ashabelnikov/secu3doc/PDF/SECU-3T-BLUETOOTH/secu3t_bluetooth_rev2_sch.png

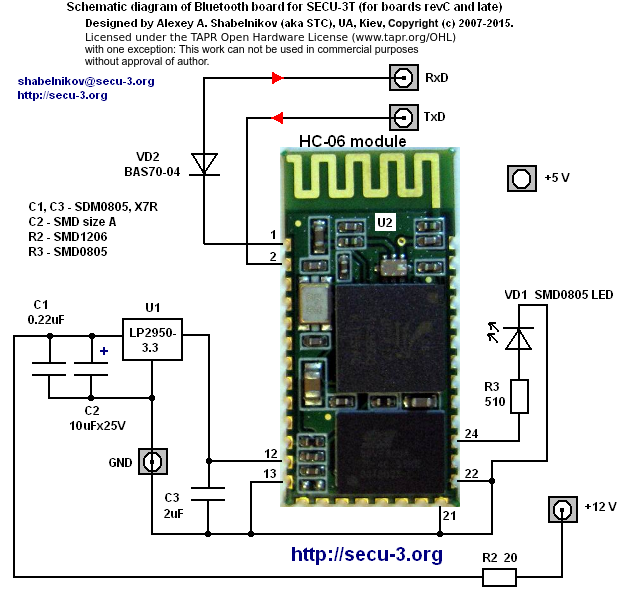
PDF/SECU-3T-BLUETOOTH/secu3t_bluetooth_rev2_sch.png
