ashabelnikov/secu3doc/README.md

# secu3doc
SECU-3 Project documentation

PCB, Schematic diagrams, pinouts etc

Contacts:
Author: Alexey A. Shabelnikov, UA, Kiev
        aka Oleksii Shabelnykov, STC
Website: http://secu-3.org
e-mail: shabelnikov@secu-3.org
