ashabelnikov/secu3doc/PDF/SECU-3T-BLUETOOTH/secu3t_bluetooth_rev2_botsilk.pdf

SECU-3T Bluetooth PCB rev. 2
Designed by Alexey A. Shabelnikov (aka STC). UA, Kiev,
Copyright (C) 2007-2015 Alexey A. Shabelnikov, http://secu-3.org Licensed under the TAPR Open Hardware License (www.tapr.org/OHL) with one exception: You can not use this work in commercial purposes

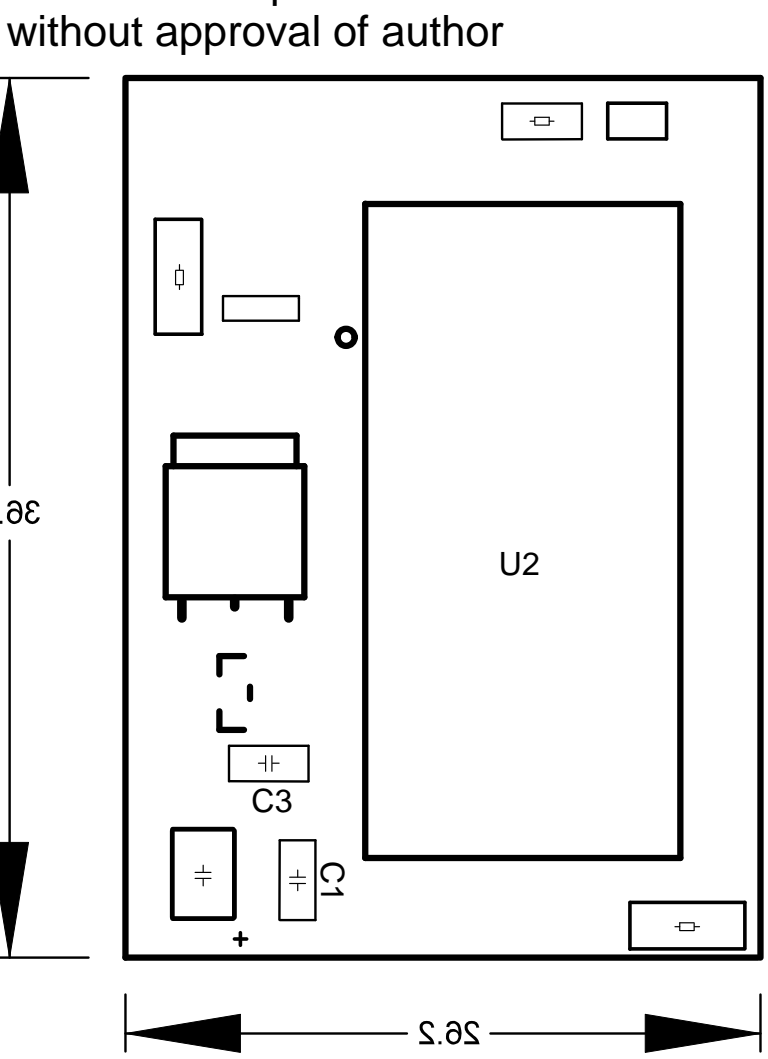
[picture p2: figure]
without approval of author
