ashabelnikov/secu3doc/PDF/SECU-INJ-DRV4/secu3_hi-z_inj_drv_botsilk.pdf

24.5

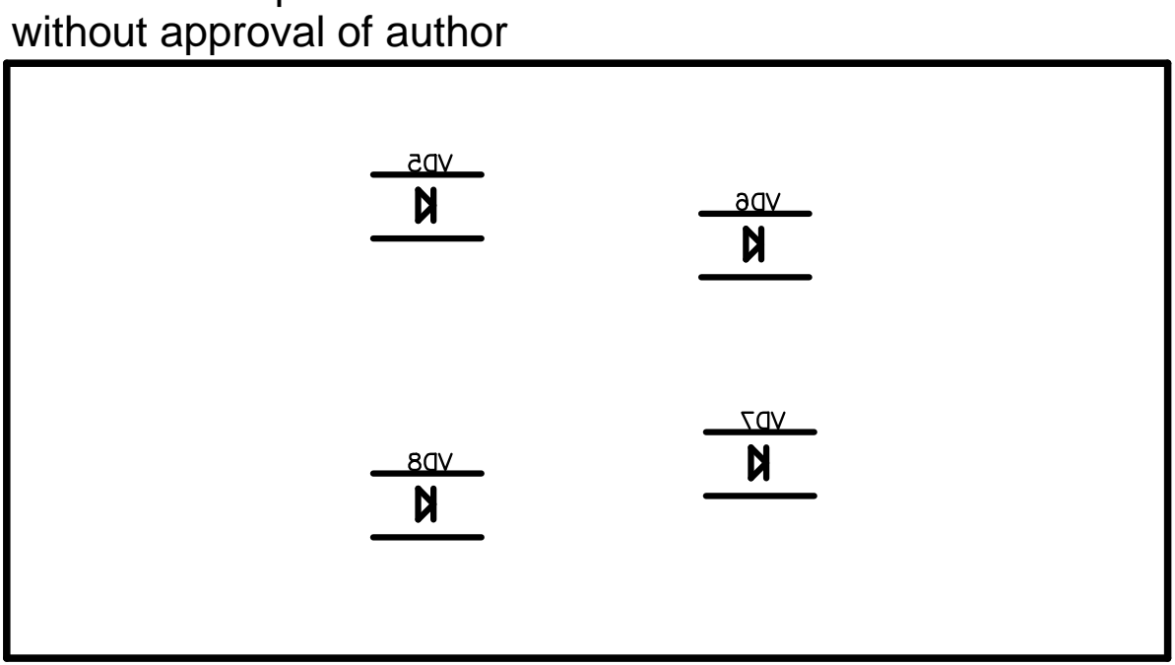
[picture p3: figure]
without approval of author

47.8

4-channel hi-z injector driver board PCB
Designed by Alexey A. Shabelnikov (aka STC). UA, Kiev.
Copyright (C) 2007-2015 Alexey A. Shabelnikov, http://secu-3.org Licensed under the TAPR Open Hardware License (www.tapr.org/OHL) with one exception: You can not use this work in commercial purposes
