ashabelnikov/secu3doc/PDF/SECU-P&H+PWMIAC/secu3_pnh+pwm_iac_pcb_topsilk.pdf

P&H injector + PWM IAC driver PCB rev.0 (SECU-P&H+PWMIAC) Designed by Alexey A. Shabelnikov (aka STC), UA, Kiev.
Copyright (C) 2007-2015 Alexey A. Shabelnikov, http://secu-3.org Licensed under the TAPR Open Hardware License (www.tapr.org/OHL) with one exception: You can not use this work in commercial purposes

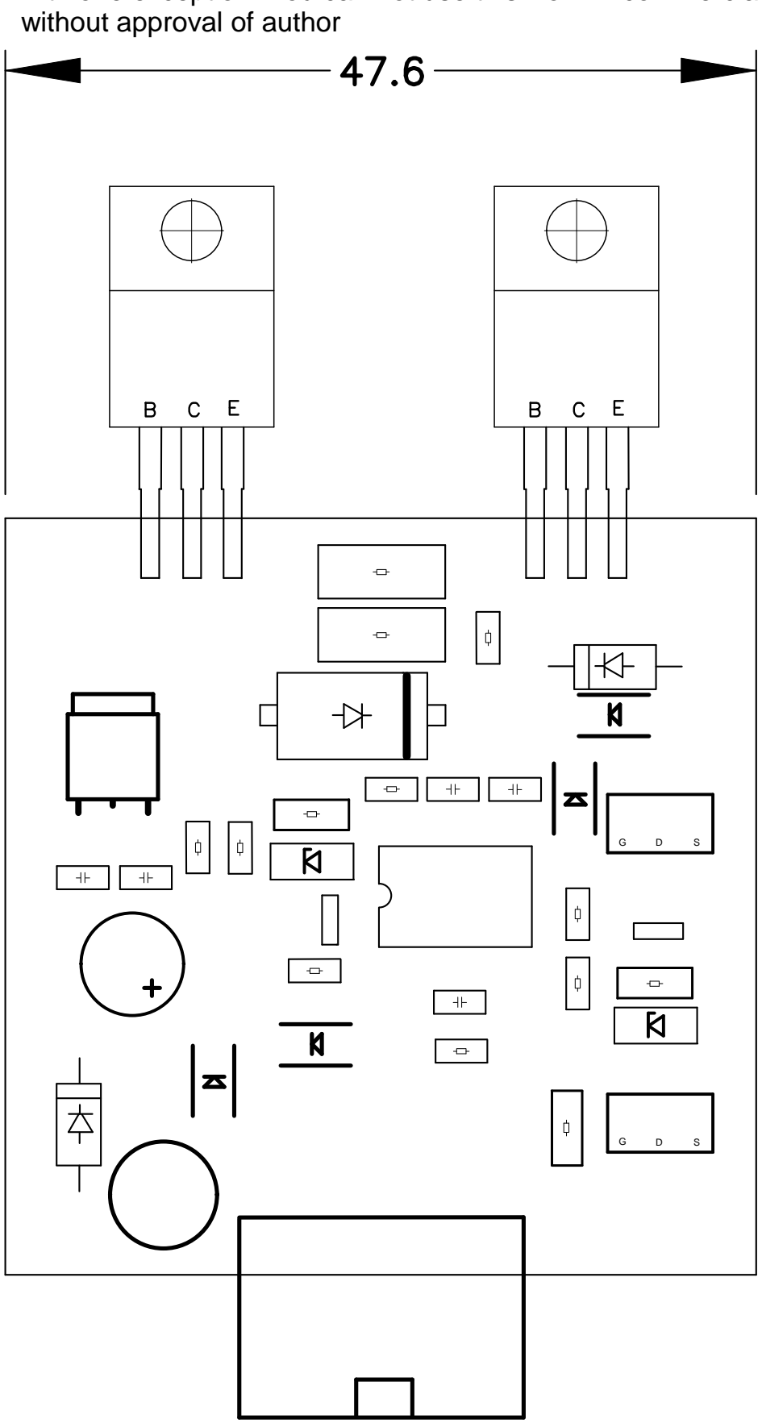
[picture p4: figure]
without approval of author
