ashabelnikov/secu3doc/Publications/readme.txt

            List of publications

1. 47939-96219-1-PB.pdf, p.90-95
"ЭЛЕКТРОННЫЙ БЛОК УПРАВЛЕНИЯ ДВИГАТЕЛЕМ ВНУТРЕННЕГО СГОРАНИЯ SECU-3"
Шабельников А. А.
Электронный блок управления двигателем внутреннего сгорания secu-3 / А. А. Шабельников // Вісник
Національного технічного університету "ХПІ". Серія : Механіко-технологічні системи та комплекси. - 2015.
- № 22. - С. 90-95. - Режим доступу: http://nbuv.gov.ua/j-pdf/vcpimtck_2015_22_26.pdf
http://mtsc.khpi.edu.ua/article/view/47939

2. BRANCH_PROBLEMS_OF_ECOLOGICAL_SAFETY_KhNADU-22-10-2015.pdf, p.55-56
Шабельников А.А.
"РАСЧЕТ ВРЕМЕНИ ВПРЫСКА В БЛОКЕ УПРАВЛЕНИЯ ДВИГАТЕЛЕМ ВНУТРЕННЕГО СГОРАНИЯ SECU-3"
І International scientific and practical conference of students, undergraduates and
graduate students «BRANCH PROBLEMS OF ECOLOGICAL SAFETY», dedicated to 85-th anniversary of KhNADU
I Міжнародна науково-практична конференція студентів, магістрантів та
аспірантів «ГАЛУЗЕВІ ПРОБЛЕМИ ЕКОЛОГІЧНОЇ БЕЗПЕКИ», присвячена 85-річчю ХНАДУ
22 October 2015, Kharkiv
Харків, ХНАДУ, 2015
http://dl.khadi.kharkov.ua/course/view.php?id=106

3. 2015-06-21_A4_tom-13.pdf, p.22-25
Шабельников А. А.
"Микропроцессорная система управления двигателем внутреннего сгорания SECU-3"
Материали за 11-а международна научна практична
конференция, «Найновите постижения на европейската
наука», - 2015. Том 13. Технологии. Селско стопанство.
Здание и архитектура. София. «Бял ГРАД-БГ» ООД - 96 стр.
http://www.rusnauka.com/23_ADEN_2015/Tecnic/4_197934.doc.htm
http://www.ukrnauka.ru/25_ADEN_2015/2015-06-21_A4_tom-13.pdf
http://www.warmdax.com/Diploms/197934.pdf

4. NTU-KhPI_N46-1155-2015.pdf, p.115-121
Шабельников А.А.
Система управления зажиганием для двигателей внутреннего сгорания SECU-3L (Lite) / А. А. Шабельников // Вісник
Національного технічного університету "ХПІ". Серія : Нові рішення в сучасних технологіях.
- № 46 (1155) 2015. - C. 115-121. p-ISSN 2079-5459, e-ISSN 2413-4295
Shabelnikov A. "Ignition control system for internalcombustion engines SECU-3L (Lite)"
BULLETIN OF THE NATIONAL TECHNICAL UNIVERSITY “KHARKIV POLYTECHNIC INSTITUTE”
Collected Works. Series: New solutions in modern technology. - Kharkiv: NTU
"KhPI" – 2015. – No 46 (1155) – 155 p.

5. MICROPROCESSOR CONTROLLED IGNITION SYSTEM SECU-3 MICRO, p.55-61
Materia.y XII Mi.dzynarodowej naukowi-praktycznej
konferencji «Aktualne problemy nowoczesnych nauk-2016» Volume 12.
Techniczne nauki, Budownictwo i architektura, Matematyka :
Przemy.l. Nauka i studia – 112 str.
http://www.rusnauka.com/21_APSN_2016/Tecnic/4_214692.doc.htm

6. SECU-3i PROGRAMMABLE ENGINE MANAGEMENT SYSTEM, p.67-73
SECU-3i PROGRAMMABLE ENGINE MANAGEMENT SYSTEM / Alexey Shabelnikov // Всеукраїнський науково – технічний журнал
«Техніка, енергетика, транспорт АПК» / Редколегія: Калетнік Г.М. (головний редактор) та інші.–Вінниця, 2016.–No 2 (94) – 112 с.
http://tetapk.vsau.org/index.php?jour=11&lang=1&kind=articles&showyear=2016&shownumber=169&seenumber=2%20(94)

7. conf-2016_t2.pdf, p.201-204
Шабельников А.А. "Использование ЭСУД SECU-3 для улучшения эксплуатационных
и экологических показателей двигателей внутреннего сгорания"
Социально-экономические и экологические проблемы горной промыш-ленности, строительства и энергетики:
11-я Международная конференция по проблемам горной промышленности, строительства и энергетики. В 2 т.
Т.2: материалы конференции. Тула: Изд-во ТулГУ, 2016. 384 с.
ISBN 978-5-7679-3618-2
ISBN 978-5-7679-3622-9 (т.2)
http://tsu.tula.ru/gs/science/conf/

Publications' list on the author's site: http://secu-3.org/publications
