ashabelnikov/secu3doc/Publications/197934.pdf

# СЕРТИФИКАТ УЧАСТНИКА

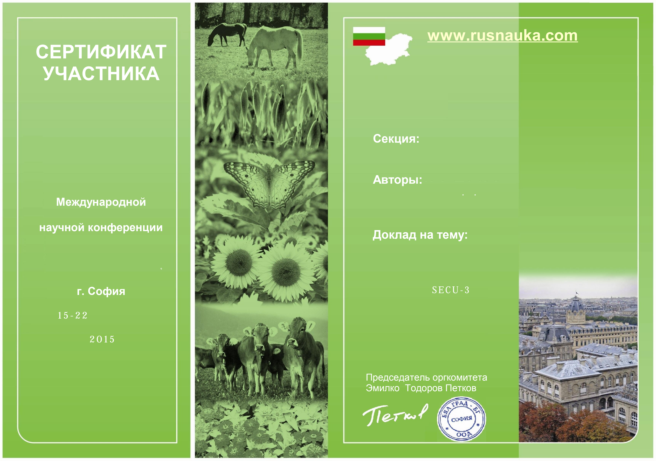
[picture p5: page 1]

Международной

научной конференции

г. София

### Секция:

### Авторы:

### Доклад на тему:

Председатель оргкомитета
Эмилко Тодоров Петков

## www.rusnauka.com

Технические науки

15-22 июня

2015

НАЙНОВИТЕ ПОСТИЖЕНИЯ
НА ЕВРОПЕЙСКАТА НАУКА˛

Шабельников А.А.

МИКРОПРОЦЕССОРНАЯ
СИСТЕМА УПРАВЛЕНИЯ
ДВИГАТЕЛЕМ ВНУТРЕННЕГО
СГОРАНИЯ SECU-3
