ashabelnikov/secu3doc/PDF/SECU-FAN-PWM/secu3t_cooling_fan_pwr_unit.gif

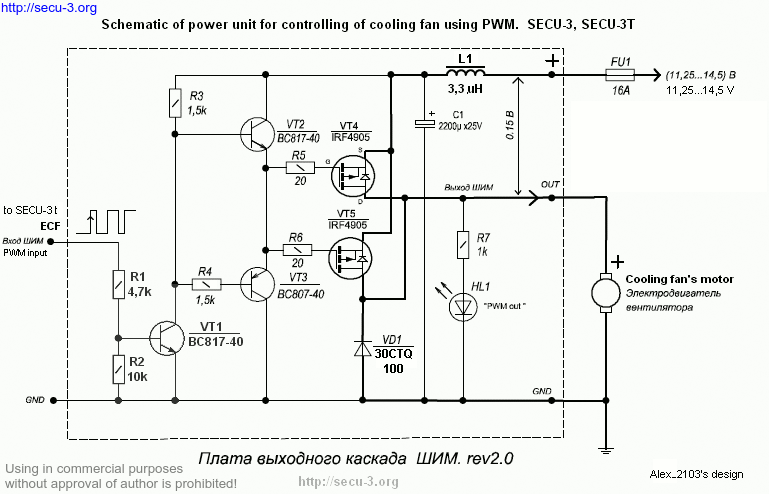
PDF/SECU-FAN-PWM/secu3t_cooling_fan_pwr_unit.gif
