ashabelnikov/secu3doc/Pinouts/fanpwm_ext_connector_config.gif

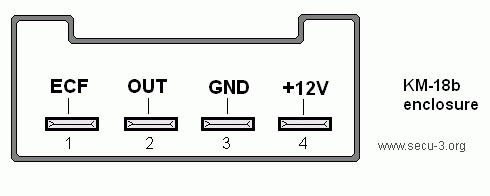
Pinouts/fanpwm_ext_connector_config.gif
