ashabelnikov/secu3doc/Pinouts/secu3-pnh-inj-drv-ext-conn-cfg.png

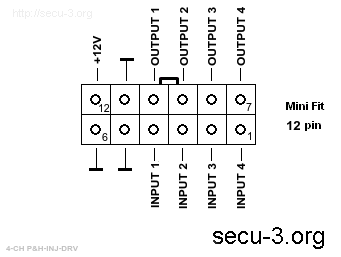
Pinouts/secu3-pnh-inj-drv-ext-conn-cfg.png
