ashabelnikov/secu3doc/Pinouts/secu3_ext_connector_config.gif

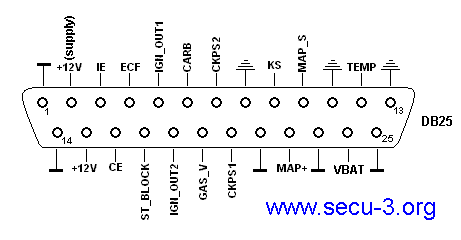
Pinouts/secu3_ext_connector_config.gif
