ashabelnikov/secu3doc/Pinouts/secu3_hi-z_inj_drv_ext_connector_config.gif

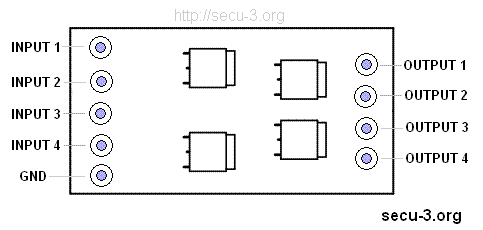
Pinouts/secu3_hi-z_inj_drv_ext_connector_config.gif
