ashabelnikov/secu3doc/Pinouts/secu3_pnh+pwm_iac_ext_connector_config.gif

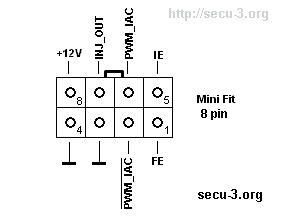
Pinouts/secu3_pnh+pwm_iac_ext_connector_config.gif
