ashabelnikov/secu3doc/Pinouts/secu3igniters_ext_connector_config.gif

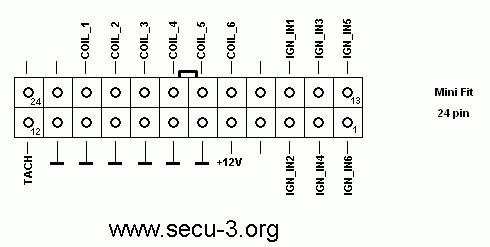
Pinouts/secu3igniters_ext_connector_config.gif
