ashabelnikov/secu3doc/Pinouts/secu3l_ext_connector_config.png

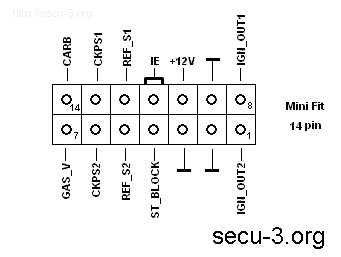
Pinouts/secu3l_ext_connector_config.png
