ashabelnikov/secu3doc/Pinouts/secu3m-ext-conn-cfg.png

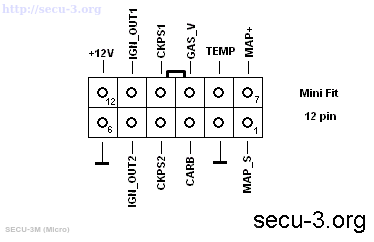
Pinouts/secu3m-ext-conn-cfg.png
