ashabelnikov/secu3doc/Pinouts/secu3smcu_ext_connector_config.gif

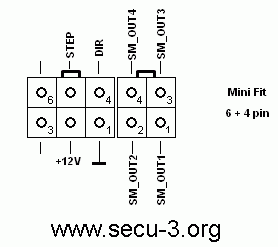
Pinouts/secu3smcu_ext_connector_config.gif
