ashabelnikov/secu3doc/Pinouts/secu3t_ext_connector_config14+12.png

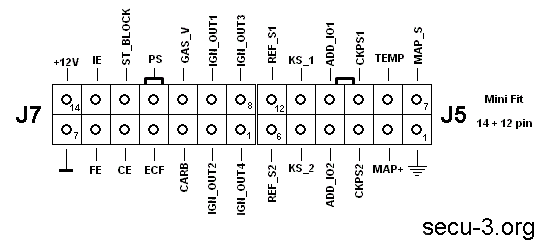
Pinouts/secu3t_ext_connector_config14+12.png
