ashabelnikov/secu3doc/Pinouts/secu3t_ext_connector_config24.png

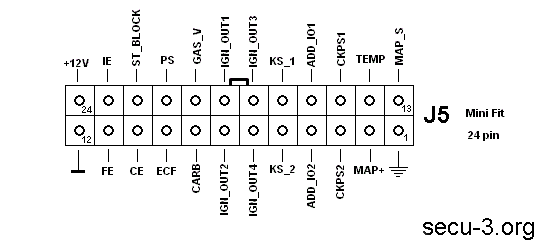
Pinouts/secu3t_ext_connector_config24.png
