ashabelnikov/secu3doc/Pinouts/secu3t_ext_connector_config.gif

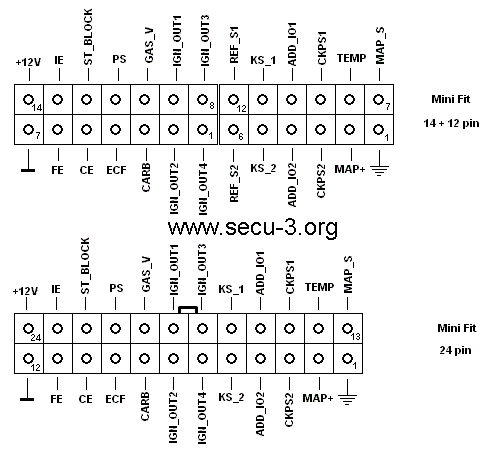
Pinouts/secu3t_ext_connector_config.gif
