ashabelnikov/secu3doc/BOM/secu-2pnh+step-bill-of-materials.xls

ComponentName | Package | Value | Count | Description
CAPACITOR
C14 | SMD_0805 | 10nF | 1 | Must be X7R
C17 | SMD_0805 | 22nF | 1 | Must be X7R
C4, C5, C6, C7, C8, C9, C11, C13 | SMD_0805 | 100nF | 8 | Must be X7R
C2, C3, C12, C15, C16 | SMD_0805 | 2.2uF x 50V | 5 | Must be X7R
C1 | Size: D5-H11 | EL 10/35V 5x11 SAMWHA | 1 | Electrolytic capacitor | Leaded component
C10 | Size: D5-H11 | EL 47/63V 6.3x11 SAMWHA | 1 | Electrolytic capacitor | Leaded component
RESISTOR
R17, R18 | SMD_0805 | 0.1 | 2
R22 | SMD_0805 | 5.1 | 1
R15 | SMD_0805 | 270 | 1
R5, R6, R7, R8, R25, R28 | SMD_0805 | 1k | 6
R2, R4, R19, R20, R24, R27 | SMD_0805 | 10k | 6
R9, R10 | SMD_0805 | 39k | 2
R16 | SMD_0805 | 1MO | 1
R21, R23 | SMD_0805 | 68k | 2
R1, R3, R26, R29 | SMD_1206 | 1k | 4
R11, R12, R13, R14 | SMD_2512 | 0.22Ohm | 4
DIODE
VD1 | SMB | SMBJ18A | 1 | TVS diode
VD2, VD3 | SOD-80 | BZV55-C4v7 | 2 | Zener diode
VD4, VD6 | DO-201 | FR303 | 2 | FAST RECOVERY RECTIFIER | Leaded component
VD5 | DO-41 | 1N4753A | 1 | Zener diode 36V, BZV85-C36V | Leaded component
VD7, VD8 | SOT-23 | BAS70-04 | 2 | Schottky barrier diode
TRANSISTOR
VT1, VT2, VT6 | SOT-23 | BC817 | 3
VT3, VT4 | TO220 | TIP122 | 2 |  | Leaded component
VT5 | TO220 | TIP42 | 1 |  | Leaded component
ICs
U1 | TO252 | LP2950CDT-5.0 | 1 | LDO IC
U2, U3 | DIP8 | LM1949 | 2 | Injector drive controller | Leaded component
U4 | HTSSOP | DRV8825 | 1 | Stepper motor driver
OTHER
J1 | Mini-Fit, 14pin, RA | MF-14MRA, MF-2x7 MRA | 1 | Connector | Without mounting pegs! Leaded component
L1 | 47uH | DM0608-470K-S0 | 1 | Radial inductor | Leaded component
 |  | Bill of materials for SECU 2P&H + STEP driver board |  |  | Revision 1. 29/01/2017
HTTP://SECU-3.ORG, © Alexey A. Shabelnikov 2007-2017
All rights reserved.
