ashabelnikov/secu3doc/BOM/secu-drv8825-bill-of-materials.xls

ComponentName | Package | Value | Count | Description
CAPACITOR
C5 | SMD_0805 | 10nF | 1 | Must be X7R
C8 | SMD_0805 | 22nF | 1 | Must be X7R
C2, C4 | SMD_0805 | 100nF | 2 | Must be X7R
C1, C3, C6, C7, C9 | SMD_0805 | 2.2uF x 50V | 5 | Must be X7R
RESISTOR
R2, R3 | SMD_0805 | 0.1 | 2
R7 | SMD_0805 | 5.1 | 1
R10, R14 | SMD_0805 | 1k | 2
R4, R5, R9, R13 | SMD_0805 | 10k | 4
R1 | SMD_0805 | 1MO | 1
R6, R8 | SMD_0805 | 68k | 2
R12 | SMD_1206 | 510 | 1
R11, R15 | SMD_1206 | 1k | 2
DIODE
VD3 | SOD-80 | BZV55-C4v7 | 1 | Zener diode
VD1, VD2 | SOT-23 | BAS70-04 | 2 | SCHOTTKY BARRIER DIODE
TRANSISTOR
VT1 | SOT-23 | BC817 | 1 | NPN transistor
ICs
U1 | HTSSOP | DRV8825 | 1 | Stepper motor driver
OTHER
- | - | - | - | - | -
 |  | Bill of materials for SECU-DRV8825 driver board |  |  | Revision 0. 28/03/2017
HTTP://SECU-3.ORG, © Alexey A. Shabelnikov 2007-2017
All rights reserved.
