ashabelnikov/secu3doc/BOM/fanpwm_bill_of_materials.xls

ComponentName | Package | Value | Count | Description
CAPACITOR
C1 | Size: D13-H25 | EL 2200/25V 13x25 SAMWHA | 1 | Electrolytic capacitor | Leaded component
RESISTOR
R1, R3, R4, R7 | SMD_1206 | 1k | 4
R5, R6 | SMD_1206 | 20 | 2
R2 | SMD_1206 | 10k | 1
 | SMD_1206 | 0 | 1 |  | Marked on top silk as R8
DIODE
VD1 | TO220 | 30CTQ100 | 1 |  | Leaded component
HL1 | 5x2mm | FYL-2513 HD | 1 | LED | Leaded component
TRANSISTOR
VT1, VT2 | SOT-23 | BC817-40 | 1
VT3 | SOT-23 | BC807-40 | 1
VT4, VT5 | TO220 | IRF4905 | 2 |  | Leaded component
OTHER
 | W: 6,3mm L: 25,1 | 6.3mm male crimp terminal connector | 4 | Connector | Leaded component
L1 | Size: D16-H16 | 4,7uH (RCR1616NP-4R7) | 1 | Radial inductor | Leaded component
FU1 | ATN20A | ATN910200 | 1 | 20A Fuse | Leaded component
 |  | Bill of materials for cooling fan power board |  |  | Revision 1. 24/06/2015
HTTP://SECU-3.ORG, © Alexey A. Shabelnikov 2007-2015
