ashabelnikov/secu3doc/BOM/secu-3-micro-bill-of-materials.xls

ComponentName | Package | Value | Count | Description
CAPACITOR
C4, C5 | SMD_0805 | 20pF, X7R | 2 | Must be X7R
C3, C15 | SMD_0805 | 3.3nF, X7R | 2 | Must be X7R
C2, C6, C7, C8, C9, C10, C11, C12, C14, C17, C18, C19, C20, C21 | SMD_0805 | 220nF x 25V, X7R | 14 | Must be X7R
C1, C13, C16 | SMD_0805 | 2.2uF x 50V, X7R | 3 | Must be X7R
RESISTOR
R6, R7, R8, R13, R19, R22, R24, R27 | SMD_0805 | 1k | 8
R1, R2, R3, R18, R26 | SMD_0805 | 10k | 5
R21 | SMD_0805 | 470k | 1
R4, R5, R10, R12, R20, R25 | SMD_0805 | 2k | 6
R9, R11, R17, R23 | SMD_0805 | 20k | 4
R14 | SMD_1206 | 20k | 1
R15, R16 | SMD_1206 | 10k | 2
DIODE
VD1 | SMA | SN1G (S1M) | 1 | Diode
VD3 | SMA | SMBJ22A | 1 | TVS diode
VD4, VD5 | SOT-23 | BAS70-04 | 2 | Schottky diode
VD2 | SMD_0805 | HCL-1705AOR-4 | 1 | LED
TRANSISTOR
VT1, VT2 | SOT-23 | BC817-40 | 2 | NPN transistor
ICs
U3 | TQFP44 | ATMEGA644-20AU | 1 | AVR MCU IC
U5 | SOT-23-5 | LMV331-N | 1 | Comparator IC
U4 | TO252 | LP2950CDT-5.0 | 1 | LDO IC
U1 | QFN28 | CP2102 | 1 | USB to UART bridge IC
U2 | SOT143 | SP0503BAHT | 1 | ESD protection IC
OTHER
J3 | Mini-Fit, 12pin, RA | MF-12MRA, MF-2x6 MRA | 1 | Connector | Without mounting pegs! Leaded component
Z1 | HC-49/S | 20MHZ/Geyer KX-3HT | 1 | Crystal (-40…85C) | Leaded component
L1 |  | 47uH (CECL-470K-CEC) | 2 | Axial inductor | Leaded component
J2 | Pin pitch 2.54mm | DS1021-1*6 | 1 | Connector | Leaded component
J5, J6 | Pin pitch 2.54mm | DS1021-2*2 | 1 | Connector | Leaded component
J1 | USBB-1J |  | 1 | USB Connector | Leaded component
washer | QW-3 (FIX&FASTEN) |  | 1 | Crystal Insulating washer
Enclosure | KM-86 |  | 1
Notes:
 |  | Bill of materials for SECU-3 Micro ignition controller unit |  |  | Revision 1. 02/03/2016
HTTP://SECU-3.ORG, © Alexey A. Shabelnikov 2007-2015
