ashabelnikov/secu3doc/BOM/secu3-inj-drv4-bill-of-materials.xls

ComponentName | Package | Value | Count | Description
RESISTOR
R1, R2, R3, R4 | SMD_1206 | 510 | 4
R5, R6 | SMD_1206 | 1k | 2
DIODE
VD1, VD2, VD3, VD4 | SOD-80 | BZV55-C4v7 | 4 | Zener diode
TRANSISTOR
VT1, VT2, VT3, VT4 | SOT-223 | NCV8403 | 4 | VND14NV04, IPS021L
 |  | Bill of materials for 4-ch Hi-Z injector driver board |  |  | Revision 1. 13/02/2015
HTTP://SECU-3.ORG, © Alexey A. Shabelnikov 2007-2015
All rights reserved.
