ashabelnikov/secu3doc/BOM/secu3-pnh+pwm-iac-bill-of-materials.xls

ComponentName | Package | Value | Count | Description
CAPACITOR
C4, C5 | SMD_0805 | 100nF | 2 | Must be X7R
C2, C6 | SMD_0805 | 220nF x 50V, X7R | 2 | Must be X7R
C3 | SMD_0805 | 1uF, X7R | 1 | Must be X7R
C1 | Size: D5-H11 | EL 10/35V 5x11 SAMWHA | 1 | Electrolytic capacitor | Leaded component
RESISTOR
R12 | SMD_0805 | 270 | 1
R6, R8, R9 | SMD_0805 | 1k | 3
R1, R4, R7 | SMD_0805 | 10k | 3
R10 | SMD_0805 | 39k | 1
R3 | SMD_1206 | 510 | 1
R2, R5 | SMD_1206 | 1k | 2
R11, R13 | SMD_2512 | 0.22Ohm | 2
DIODE
VD1 | DO-15 | P6KE18A | 1 | TVS diode | Leaded component
VD2, VD3 | SOD-80 | BZV55-C4v7 | 2 | Zener diode
VD8, VD9 | SMA | SN1G | 2
VD7 | DO-201 | FR303 | 1 | FAST RECOVERY RECTIFIER | Leaded component
VD6 | DO-41 | 1N4753A | 1 | Zener diode 36V, BZV85-C36V | Leaded component
TRANSISTOR
VT2, VT3 | SOT-23 | BC817 | 2
VT5 | TO220 | TIP122 | 1 |  | Leaded component
VT6 | TO220 | TIP42 | 1 |  | Leaded component
VT1, VT4 | SOT-223 | NCV8403 | 2 | IPS021L
ICs
U1 | TO252 | LP2950CDT-5.0 | 1 | LDO IC
U2 | DIP8 | LM1949 | 1 | Injector drive controller | Leaded component
OTHER
X1 | Mini-Fit, 8pin, RA | MF-8MRA, MF-2x4 MRA | 1 | Connector | Without mounting pegs! Leaded component
L1 | 47uH | DM0608-470K-S0 | 1 | Radial inductor | Leaded component
 |  | Bill of materials for P&H injector + PWM IAC driver board |  |  | Revision 1. 12/08/2015
HTTP://SECU-3.ORG, © Alexey A. Shabelnikov 2007-2015
All rights reserved.
