ashabelnikov/secu3doc/BOM/secu3-pnh-inj-drv4-bill-of-materials.xls

ComponentName | Package | Value | Count | Description
CAPACITOR
C7, C11, C15, C19 | SMD_0805 | 3,3nF, X7R | 4 | Must be X7R
C4, C6, C8, C10, C12, C14, C16, C18 | SMD_0805 | 100nF | 8 | Must be X7R
C2, C5, C9, C13, C17 | SMD_0805 | 220nF x 50V, X7R | 5 | Must be X7R
C3 | SMD_0805 | 1uF, X7R | 1 | Must be X7R
C1 | Size: D5-H11 | EL 10/35V 5x11 SAMWHA | 1 | Electrolytic capacitor | Leaded component
RESISTOR
R5, R13, R21, R29 | SMD_0805 | 0 | 4
R33 | SMD_0805 | 270 | 1
R3, R4, R11, R12, R19, R20, R27, R28 | SMD_0805 | 1k | 8
R1, R9, R17, R25 | SMD_0805 | 10k | 4
R6, R14, R22, R30 | SMD_0805 | 39k | 4
R2, R10, R18, R26 | SMD_1206 | 1k | 4
R7, R8, R15, R16, R23, R24, R31, R32 | SMD_2512 | 0.22Ohm | 8
DIODE
VD1 | DO-15 | P6KE18A | 1 | TVS diode | Leaded component
VD2, VD4, VD6, VD8 | SOD-80 | BZV55-C4v7 | 4 | Zener diode
VD3, VD5, VD7, VD9 | DO-201 | FR303 | 4 | FAST RECOVERY RECTIFIER | Leaded component
VD10 | DO-41 | 1N4753A | 1 | Zener diode 36V, BZV85-C36V | Leaded component
TRANSISTOR
VT1, VT3, VT5, VT7 | SOT-23 | BC817 | 4
VT2, VT4, VT6, VT8 | TO220 | TIP122 | 4 |  | Leaded component
VT9 | TO220 | TIP42 | 1 |  | Leaded component
ICs
U1 | TO252 | LP2950CDT-5.0 | 1 | LDO IC
U2, U3, U4, U5 | DIP8 | LM1949 | 4 | Injector drive controller | Leaded component
OTHER
X1 | Mini-Fit, 12pin, RA | MF-12MRA, MF-2x6 MRA | 1 | Connector | Without mounting pegs! Leaded component
L1 | 47uH | DM0608-470K-S0 | 1 | Radial inductor | Leaded component
 |  | Bill of materials for 4-ch P&H injector driver board |  |  | Revision 1. 13/01/2016
HTTP://SECU-3.ORG, © Alexey A. Shabelnikov 2007-2016
All rights reserved.
