ashabelnikov/secu3doc/BOM/secu3_bill_of_materials.xls

ComponentName | Package | Value | Count | Description | Replacement
CAPACITOR
C2, C3, C10, C11 | SMD_0805 | 20pF | 4 | Capacitor | 18pF, 22pF
C1, C6, C12, C13, C14, C15, C16, C17, C18,C19,C20,C21,C22,C24,C27,C30,C33 | SMD_0805 | 220nF | 17 |  | 150nF, 330nF
C4, C9 | SMD_0805 | 22nF | 2 |  | 33nF
C5 | SMD_0805 | 3,3nF | 1 |  | 4,7nF
C23, C25 | EIA 3216-18 (Size A) | 4.7uFx10v | 2 |  | SMD1206, C >= 2.2uF, U >= 6,3V (ceramic)
C7, C8, C34 | EIA 3528-21 (Size B) | 10uFx16v | 3 |  | C >= 10uF, U >= 16V, SizeB
C32 | EIA 3528-21 (Size B) | 47uFx10v | 1 |  | C >= 47uF, U >= 6,3V, SizeB
C26 | SMD_0805 | 1000pFx250v | 1 | Capacitor | CL11 Polyester Film Capacitor, C=1000pF, U >= 200V
C29 | Size: D8-H12 | 470uFx25v | 1 |  | C>= 220uF, U >=25V Size: D<=10mm, H<=20mm
C28 | Size: D10-H12 | 220uFx50v | 1 |  | C>= 100uF, U >=35V Size: D<=10mm, H<=20mm
C31 | Size: D12-H22 | 1000uFx25v | 1 |  | C>=470uF, U >= 6,3V Size: D<=12mm, H<=22mm
RESISTOR
R10, R18, R19, R33, R35, R37, R39, R44, R46, R47 | SMD_0805 | 1k | 10 | Resistor | 820…1500 Ohm
R2, R3, R5, R6, R7, R9, R10, R14, R15, R16, R17, R20, R21, R22, R23, R25, R2, R29, R31 | SMD_0805 | 10k | 19
R1 | SMD_0805 | 1MO | 1 |  | 1…10 MOhm
R11, R12, R13 | SMD_0805 | 510 | 3
R9 | SMD_0805 | 68k | 1 |  | 47…68 kOhm
R8, R45 | SMD_0805 | 470k | 2
R24, R30 | SMD_0805 | 2k | 2
R26 | SMD_0805 | 15k | 1
R34, R36, R38, R40, R50 | SMD_1206 | 2k7 | 5 |  | 2000…3000Ohm
R41 | SMD_1206 | 20k | 1
R48, R49 | SMD_1206 | 10 | 2 |  | 0…10 Ohm
R28, R32, R51 | SMD_1206 | 1k | 3 |  | 820…1500 Ohm
R42, R43 | SMD_1206 | 10k | 2
DIODE
VD4, VD5, VD6, VD7, | SMA | SN1G (S1M) | 4 | Rectifier | 1N4004,1N4005,1N4006,1N4007
VD13 | SMA | SS14 | 1 | Shottky diode | SHOTTKY - 40V/1A
VD8, VD9 | SOD80 | 4v7 | 2 | Zener diode | 5v1 zener
VD14 | SOD80 | 9v1 | 1 | Zener diode
VD12 | DO-15 | P6KE18A | 1 | Supressor | Optional* (ESD protection), SMBJ18A, P6KE20A
VD1, VD2, VD3, VD10, VD11 | SOD80 | 1N4148 | 5 | General purpose diode | BAS32L, KD521, KD522
TRANSISTOR
VT8 | D-PAK | IRFR010 | 1 | FET | IRFL014
VT2, VT4, VT6 | D-PAK | IRFR9010 | 3 | FET | IRFL9014
VT1, VT3, VT5, VT7, VT9, VT10 | SOT-23 | BC847 | 6 | NPN | NPN transistor - 60V/100mA, BC817
ICs
U4, U5, U6 | SO4 | TLP181 | 3 | Photocoupler | PC817
U2 | SOT-23 | DS1811-15 | 1 |  | Optional* (Voltage monitor)
U1 | SO20 | HIP9011AB | 1 |  | Optional* (Knock detector)
U3 | TQFP44 | ATMEGA32-16AU | 1 | MCU | ATMEGA32A, ATMEGA16A
U7 | SO8 | LM293 | 1 | Comparator | LM393
U8 | TO220 | LM2931T-5,0 | 1 | LDO | LM2937-5.0, LM2940T-5.0, LM7805
Optional* ISP Adapter | DIP20 (SO20) | 74HC244 | 1 | Buffer IC | 74LS244
OTHER
J4 | DB9F | DB9F | 1 | Connector (female)
J5 | DB25M | DB25M | 1 | Connector (male)
Z1 | HC-49/S | 4mHz/Geyer KX-3HT | 1 | crystal (-40…85C) | 4 or 16mHz HC-49/U
Z2 | HC-49/S | 16mHZ/Geyer KX-3HT | 1 | crystal (-40…85C) | 16 mHz HC-49/U
L1,L2, L3 | SMD, Size: 0705 (0703) | 39uH | 3 | Inductor | L>=33uH, D=7…8mm, H<=10mm
L4 | Size: D8-H15 | 50uH (Bourns, RLB0914-470KL) | 1 | Inductor | L>=50uH, D=8…10mm, H<=20mm
J1, J2, J3 | One Line Connector 2.5MM |  | 1 | Connector
 |  |  |  |  | revision 9. 23/01/2012
Copyright © 2007-2012 Alexey A. Shabelnikov, UA, Kiev
http://secu-3.org
