ashabelnikov/secu3doc/BOM/secu3_bluetooth_bill_of_materials.xls

ComponentName | Package | Value | Count | Description
CAPACITOR
C1 | SMD_0805 | 0.22uF X 25V | 1
C3 | SMD_0805 | 2uF | 1
C2 | Size B (EIA 3528) | SA1 10uF x 25V
RESISTOR
R2 | SMD_1206 | 20 | 1
R3 | SMD_0805 | 510 | 1
DIODE
VD1 | SMD_0805 | L-C170KRCT | 1 | SMD LED
VD2 | SOT-23 | BAS70-04 | 1 | LED | Leaded component
IC
U1 | TO252 | LP2950CDT-3.3 | 1
OTHER
pins | PLS-40 2.54mm | 4 pins | 4 | Connector | Leaded component
 |  | Bill of materials for bluetooth board |  |  | Revision 1. 24/06/2015
HTTP://SECU-3.ORG, © Alexey A. Shabelnikov 2007-2015
