ashabelnikov/secu3doc/BOM/secu3_smcu_bill_of_materials.xls

ComponentName | Package | Value | Count | Description
CAPACITOR
C6 | SMD_0805 | 3,3nF | 1
C2, C5, C7, C8, C9 | SMD_0805 | 220nF x 25V, X7R | 5 | Must be X7R
C4 | SMD_0805 | 1uF | 1 | Must be X7R
C1, C3 | Size: D5-H11 | EL 10/35V 5x11 SAMWHA | 2 | Electrolytic capacitor | Leaded component
C10 | Size: D8-H12 | EL 220/35V 8x12 SAMWHA | 1 | Electrolytic capacitor | Leaded component
RESISTOR
R2, R4, R5, R10 | SMD_1206 | 1k | 4
R3, R6, R7, R8, R9 | SMD_1206 | 10k | 5
R11 | SMD_1206 | 20k | 1
R12, R13 | MOR200S | 0.51Ohm | 2 |  | Leaded component
DIODE
VD1 | DO-15 | P6KE18A | 1 | TVS diode | Leaded component
VD2, VD3 | SOT-23 | BAS70-04 | 2 | Schottky diode
TRANSISTOR
VT1 | SOT-23 | BC807 | 1
ICs
U1 | TO252 | LP2950CDT-5.0 | 1 | LDO IC
U2 | DIP20 | L297/1 | 1 | Stepper motor controller | Leaded component
U3 | Multiwatt15 | L298 | 1 | Stepper motor bgidge | Leaded component
U4 | DIP16 | L6210 | 1 | Dual schottky bridge | Leaded component
OTHER
X1 | Mini-Fit, 6pin, RA | MF-6MRA, MF-2x3 MRA | 1 | Connector | Without mounting pegs! Leaded component
X2 | Mini-Fit, 4pin, RA | MF-4MRA, MF-2x2 MRA | 1 | Connector | Without mounting pegs! Leaded component
L1 | SMD_1210 | 47uH (CECL-470K-CEC) | 1 | Axial inductor | Leaded component
 |  | Bill of materials for stepper motor controller board |  |  | Revision 1. 24/06/2015
HTTP://SECU-3.ORG, © Alexey A. Shabelnikov 2007-2015
