ashabelnikov/secu3doc/BOM/secu3l_bill_of_materials.xls

ComponentName | Package | Value | Count | Description
CAPACITOR
C6, C7 | SMD_0805 | 20pF | 2 | Must be X7R
C14, C24 | SMD_0805 | 3,3nF | 2 | Must be X7R
C4, C17 | SMD_0805 | 22nF | 2 | Must be X7R
C2, C3, C5, C8, C9, C10, C11, C12, C13, C15, C20, C21, C22, C23, C25, C26, C29 | SMD_0805 | 220nF x 25V, X7R | 17 | Must be X7R
C1, C16, C18, C27, C28 | SMD_0805 | 1uF | 5 | Must be X7R
C19 | Size: D5-H11 | EL 100/25V 5x11 SAMWHA | 1 | Electrolytic capacitor | Leaded component
RESISTOR
R4, R8, R11, R15, R17, R31, R33, R36, R46 | SMD_0805 | 1k | 9
R5, R6, R9, R12*, R13, R14, R18*, R20, R22, R23, R26, R34, R37, R39, R44 | SMD_0805 | 10k | 15 | If R12,R18 are soldered, then R13,R14 should not be soldered and vice versa | See notes at the bottom!
R10, R16 | SMD_0805 | 330 | 2
R30 | SMD_0805 | 510 | 1
R40 | SMD_0805 | 68k | 1
R32, R38 | SMD_0805 | 470k | 2
R1, R41, R42, R43 | SMD_0805 | 2k7 | 4
R21, R35 | SMD_0805 | 100 | 2
R45 | SMD_0805 | 2k | 1
R25 | SMD_1206 | 20k | 1
R2, R3, R7, R19, R24 | SMD_1206 | 1k | 5
R27, R28, R29 | SMD_1206 | 10k | 3
DIODE
VD1, VD2 | SMA | SN1G (S1M) | 2 | Diode
VD4, VD6 | SOD80 | BZV55 4v7 | 2 | Zener diode
VD8 | SMA | P4SMAJ18A | 1 | TVS diode
VD3, VD5, VD7, VD9 | SOT-23 | BAS70-04 | 4 | Schottky diode
HL1 | D=3mm | LTL1CHKEKNN |  | LED | Leaded component
TRANSISTOR
VT1 | SOT-223 | NCV8450 | 1 | *P-channel MOSFET or smart high-side switch | In board rev3 IRFL9014 must be used or you should make changes to PCB. For rev4 is Ok (NCV8450 is default).
VT3 | SOT-223 | NCV8403 | 1 | N-channel MOSFET
VT2, VT5, VT7, VT8 | SOT-23 | BC817-40 | 4 | NPN transistor
VT4, VT6 | TO-220 | BIP373 | 2 | Ignition transistor | Leaded component
ICs
U4 | TQFP44 | ATMEGA644-20AU | 1 | AVR MCU IC
U5 | SO8 | LM2903D | 1 | Comparator IC
U6 | TO252 | LP2950CDT-5.0 | 1 | LDO IC
U1 | QFN28 | CP2102 | 1 | USB to UART bridge IC
U2 | SOT143 | SP0503BAHT | 1 | ESD protection IC
U3 | SO-8 | ADUM1201 | 1 | Digital isolator
OTHER
J5 | Mini-Fit, 14pin, RA | MF-14MRA, MF-2x7 MRA, Mini-Fit Jr. MOLEX 39301140 | 1 | Connector | Without mounting pegs! Leaded component
Z1 | HC-49/S | 20mHZ/Geyer KX-3HT | 1 | Crystal (-40…85C) | Leaded component
L1 |  | 47uH (CECL-470K-CEC) | 1 | Axial inductor | Leaded component
J1 | Pin pitch 2.54mm | DS1021-1*6 | 1 | Connector | Leaded component
J2, J3 | Pin pitch 2.54mm | DS1021-2*2 | 1 | Connector | Leaded component
J4 | USBB-1J |  | 1 | USB Connector | Leaded component
washer | QW-3 (FIX&FASTEN) |  | 1 | Crystal Insulating washer
Enclosure | UNI-S-BOX-070 |  | 1 | Aluminium profile enclosure
For MAP sensor mounting:
Map sensor | MPX4250AP |  | 1
Screwed spacer sleeve | TFF-10mm M4 |  | 2
Screw | M4, 12mm |  | 2
Countersunk screw | M4, 8mm |  | 2
M4 washer | M4 x 9mm |  | 2
For mounting of VT4, VT6 transistors:
Transistor silicon insulator for TO-220 |  |  | 2
Insulating tablet for TO-220 |  |  | 2
Countersunk screw | M3, 10mm |  | 2
Screw nut | M3 |  | 2
M3 washer | M3 x 7mm |  | 2
Notes:
* In default configuration R12,R18 are not soldered
 |  | Bill of materials for SECU-3L (Lite) ignition controller unit |  |  | Revision 4. 02/01/2016
HTTP://SECU-3.ORG, © Alexey A. Shabelnikov 2007-2015
