ashabelnikov/secu3doc/BOM/secu3t_bill_of_materials.xls

ComponentName | Package | Value | Count | Description | Replacement
CAPACITOR
C1, C2, C8, C9 | SMD_0805 | 20pF | 4 | Capacitor | 18pF, 22pF
C3, C10, C11, C12, C13, C14, C15, C16, C17, C18, C19, C20, C21, C22, C23, C24, C28, C29, C33, C34, C43 | SMD_0805 | 220nF | 20 |  | 150nF, 330nF
C4, C7, C37 | SMD_0805 | 22nF | 3 |  | 33nF
C5, C6, C27, C40, C41 | SMD_0805 | 3,3nF | 5 |  | 4,7nF
C38, C39, C42 | SMD_0805 | 1uF | 2(3)
C25, C26 | EIA 3528-21 (Size B) | 10uFx16v | 0(2) |  | C >= 10uF, U >= 16V, SizeB
C35, C36 | EIA 3528-21 (Size B) | 47uFx10v | 2 |  | C >= 47uF, U >= 6,3V, SizeB
C30 | Size: D7-H12,5 | 220uFx50v | 1 | Electrolytic capacitor | C>= 220uF, U >=35V Size: D<=8mm, H<=20mm
C31, C32 | Size: D8-H15 | 470uFx25v | 2 | Electrolytic capacitor | C>= 100uF, U >=35V Size: D<=10mm, H<=20mm
RESISTOR
R40, R65, R67, R68, R69, R78, R79, R80, R81, R91, R93 | SMD_0805 | 1k | 10(11) | Resistor | 820…1500 Ohm
R4, R7, R8, R9, R10, R11, R12, R13, R14, R15, R16, R18, R23, R24, R26, R27, R28, R30, R32, R33, R34, R35, R36, R37, R39, R58, R60, R74, R90 | SMD_0805 | 10k | 28(29)
R1 | SMD_0805 | 1MO | 1 |  | 1…10 MOhm
R38, R41, R42, R71 | SMD_0805 | 510 | 1(4)
R5, R6, R75 | SMD_0805 | 68k | 3 |  | 47…68 kOhm
R2, R3, R66, R73 | SMD_0805 | 470k | 4
R17, R20, R25, R29, R44, R46, R48, R50, R52, R53, R54, R55, R56, R61 | SMD_0805 | 2k | 14
R19 | SMD_0805 | 15k | 1
R21, R22, R31, R43, R45, R76, R77 | SMD_0805 | 2k7 | 7 |  | 2000…3000Ohm
R72, R92 | SMD_0805 | 100 | 2
R62 | SMD_1206 | 20k | 1
R47, R51, R57, R59, R82, R83 | SMD_1206 | 1k | 6 |  | 820…1500 Ohm
R63, R64, R70 | SMD_1206 | 10k | 3
R84, R85, R86, R87, R88, R89 | SMD_1206 | 0 | 6
DIODE
VD6, VD7, VD8, VD9, VD15, VD27 | SMA | SN1G (S1M) | 6 | Rectifier | 1N4004,1N4005,1N4006,1N4007
VD14 | SMA | SS14 | 1 | Shottky diode | SHOTTKY - 40V/1A
VD2, VD12, VD16 | SOD80 | BZV55 4v7 | 3 | Zener diode | 5v1 zener
VD13 | DO-15 | P6KE18A | 1 | Supressor (ESD protection) | Optional*, SMBJ18A, P6KE20A
VD4, VD5, VD3, VD17, VD18, VD19, VD20, VD21, VD22, VD23, VD24, VD25, VD26 | SOT-23 | BAS70-04 | 10(13) | Shottky signal diode | SHOTTKY - 40V/50mA
TRANSISTOR
VT4, VT6 | SOT-23 | IRLML5203 | 2 | FET | IRLML5103, IRLML9303, IRLML9301, SI2319, BC807 (R82, R83 required!)
VT1, VT2, VT3, VT5, VT7, VT9, VT11, VT13, VT14, VT15, VT16, VT17, VT18 | SOT-23 | BC817 | 13 | NPN | NPN transistor - 45V/500mA
ICs
U4, U5, U6 | SO4 | TLP181 | 0(3) | Photocoupler | PC817
U2 | SOT-23 | DS1811-15 | 1 | Voltage monitor | Optional*, DS1811-5/10, MCP100-450/460/475/485, MCP120, MCP130
U1 | SO20 | HIP9011AB | 1 | Knock detector | Optional*
U3 | TQFP44 | ATMEGA644-20AU | 1 | MCU | ATMEGA32A
U7 | SO8 | LM293 | 1 | Comparator | LM393
U8 | TO220 | LM2931T-5,0 | 1 | LDO | LM2937-5.0, LM2940T-5.0, LM7805, LP2950CDT-5.0
U9 | QFN28 | CP2102 | 0(1) | USB to RS-232 conv.
U10 | SOT143 | SP0503BAHT | 0(1) | ESD protection
OTHER
J4 | DRB-9F | DRB-9F | 0(1) | Connector (female)
J5 | MOLEX Mini-Fit RTC Right angle, 12 pin | MOLEX Mini-Fit RTC Right angle, 12 pin | 1 | Connector (male) | MOLEX Mini-Fit 12pin RA (MF-2x12 MRA)
J7 | MOLEX Mini-Fit RTC Right angle, 14 pin | MOLEX Mini-Fit RTC Right angle, 14 pin | 1 | Connector (male) | MOLEX Mini-Fit 14pin RA (MF-2x14 MRA)
Z1, Z2 | HC-49/S | 20mHZ/Geyer KX-3HT | 2 | crystal (-40…85C) | 20 mHz HC-49/U
L1,L2, L3 | SMD_1210 | 47uH (LQH32M) | 3 | Inductor | L>=33uH
L4 | Size: D8-H15 | 47uH (Bourns, RLB0914-470KL) | 1 | Inductor | L>=47uH, D<=8mm, H<=20mm
J1 | WF10 | WF10 (10 pin) | 1 | Connector
J2, J3 | 2.5mm | 2pin | 2 | Connector
J6 | USBB-1J |  | 0(1) | USB Connector
Legend: |  |  |  |  | Revision 17. 20/10/2013
█ | Used only in USB version
█ | Used only in RS-232 version
Copyright © 2007-2013 Alexey A. Shabelnikov, UA, Kiev
http://secu-3.org
