ashabelnikov/secu3doc/BOM/secu3t_revcu6_bill_of_materials.xls

ComponentName | Package | Value | Count | Description
CAPACITOR
C1, C2, C8, C9 | SMD_0805 | 20pF | 4 | Must be X7R
C3, C10, C11, C12, C13, C14, C15, C16, C17, C18, C19, C20, C21, C22, C23, C28, C29, C33, C34, C43 | SMD_0805 | 220nF x 25V, X7R | 20 | Must be X7R
C4, C7, C37 | SMD_0805 | 22nF | 3 | Must be X7R
C5, C6, C27, C40, C41 | SMD_0805 | 3,3nF | 5 | Must be X7R
C38, C39, C42 | SMD_0805 | 1uF | 3 | Must be X7R
C35, C36 | EIA 3528-21 (Size B) | 47uFx10v | 2 | Tantalum SMD capacitor
C30 | Size: D8-H12 | EL 220/35V 8x12 SAMWHA | 1 | Electrolytic capacitor | Leaded component
C31, C32 | Size: D8-H12 | EL 470/25V 8x12 SAMWHA | 2 | Electrolytic capacitor | Leaded component
RESISTOR
R65, R67, R68, R69, R78, R79, R80, R81, R91, R93 | SMD_0805 | 1k | 10
R4, R7, R8, R9, R11, R12, R13, R14, R16, R18, R24, R26, R28, R30, R32, R33, R34, R35, R36, R37, R58, R60, R74 | SMD_0805 | 10k | 23
R1 | SMD_0805 | 1MO | 1
R71 | SMD_0805 | 510 | 1
R5, R6, R75 | SMD_0805 | 68k | 3
R2, R3, R66, R73 | SMD_0805 | 470k | 4
R17, R20, R25, R29, R44, R46, R48, R50, R52, R53, R54, R55, R56, R61 | SMD_0805 | 2k | 14
R21, R22, R31, R43, R45, R76, R77 | SMD_0805 | 2k7 | 7
R72, R92 | SMD_0805 | 100 | 2
R62 | SMD_1206 | 20k | 1
R47, R51, R57, R59, R82, R83 | SMD_1206 | 1k | 6
R63, R64, R70 | SMD_1206 | 10k | 3
DIODE
VD6, VD7, VD8, VD9, VD15, VD27 | SMA | SN1G (S1M) | 6 | Diode
VD14 | SMA | SS14 | 1 | Schottky diode
VD2, VD12, VD16 | SOD80 | BZV55 4v7 | 3 | Zener diode
VD13 | DO-15 | P6KE18A | 1 | TVS diode | Leaded component
VD17, VD18, VD19, VD20, VD21, VD22, VD23, VD24, VD25, VD26 | SOT-23 | BAS70-04 | 10 | Schottky diode
TRANSISTOR
VT4, VT6 | SOT-23 | BC807 | 2
VT1, VT2, VT3, VT5, VT7, VT9, VT11, VT13, VT14, VT15, VT16, VT17, VT18 | SOT-23 | BC817-40 | 13 | NPN transistor
ICs
U1 | SO20 | HIP9011AB | 1 | Knock processing IC
U3 | TQFP44 | ATMEGA644-20AU | 1 | AVR MCU IC
U7 | SO8 | LM2903D | 1 | Comparator IC
U8 | TO252 | LP2950CDT-5.0 | 1 | LDO IC
U9 | QFN28 | CP2102 | 1 | USB to UART bridge IC
U10 | SOT143 | SP0503BAHT | 1 | ESD protection IC
OTHER
J5 | Mini-Fit, 12pin, RA | (MF-12MRA, MF-2x6 MRA, Mini-Fit Jr. MOLEX 39301120) | 1 | Connector | Without mounting pegs! Leaded component
J7 | Mini-Fit, 14pin, RA | MF-14MRA, MF-2x7 MRA, Mini-Fit Jr. MOLEX 39301140 | 1 | Connector | Without mounting pegs! Leaded component
Z1, Z2 | HC-49/S | 20mHZ/Geyer KX-3HT | 2 | Crystal (-40…85C) | Leaded component
L1,L2, L3 | SMD_1210 | 47uH (CECL-470K-CEC) | 3 | Axial inductor | Leaded component
L4 | Size: D8.7-H12 | 47uH (Bourns,RLB0914-470KL) | 1 | Radial inductor | Leaded component
J1 | Pin pitch 2.54mm | DS1021-1*10 | 1 | Connector | Leaded component
J2, J3 | Pin pitch 2.54mm | DS1021-2*2 | 1 | Connector | Leaded component
J6 | USBB-1J |  | 1 | USB Connector | Leaded component
- | QW-3 (FIX&FASTEN) |  | 2 | Crystal Insulating washer
Optional, for embedded MAP sensor:
Map sensor | MPX4250AP |  | 1
Screwed spacer sleeve | TFF-10mm M4 |  | 2
Screw | M4, 12mm |  | 2
Countersunk screw | M4, 8mm |  | 2
M4 washer | M4 x 9mm |  | 2
 |  | Bill of materials for SECU-3T revСU6 board |  |  | Revision 2. 08/09/2015
HTTP://SECU-3.ORG, © Alexey A. Shabelnikov 2007-2015
