ashabelnikov/secu3doc/Wiring/bip373-secu-3t-wiring.png

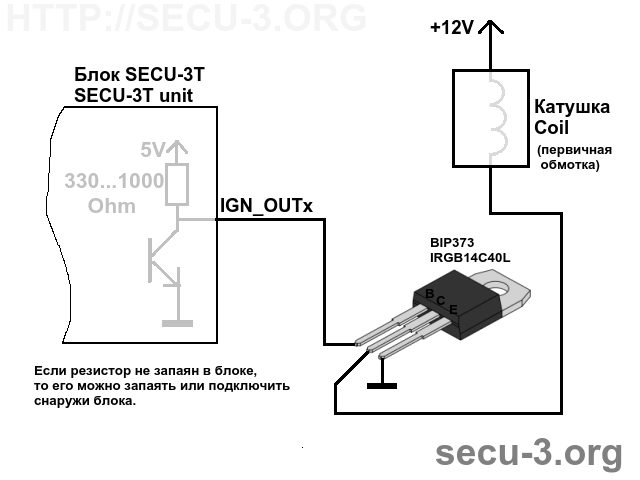
Wiring/bip373-secu-3t-wiring.png
