ashabelnikov/secu3doc/Wiring/secu3l_wiring_ckps.png

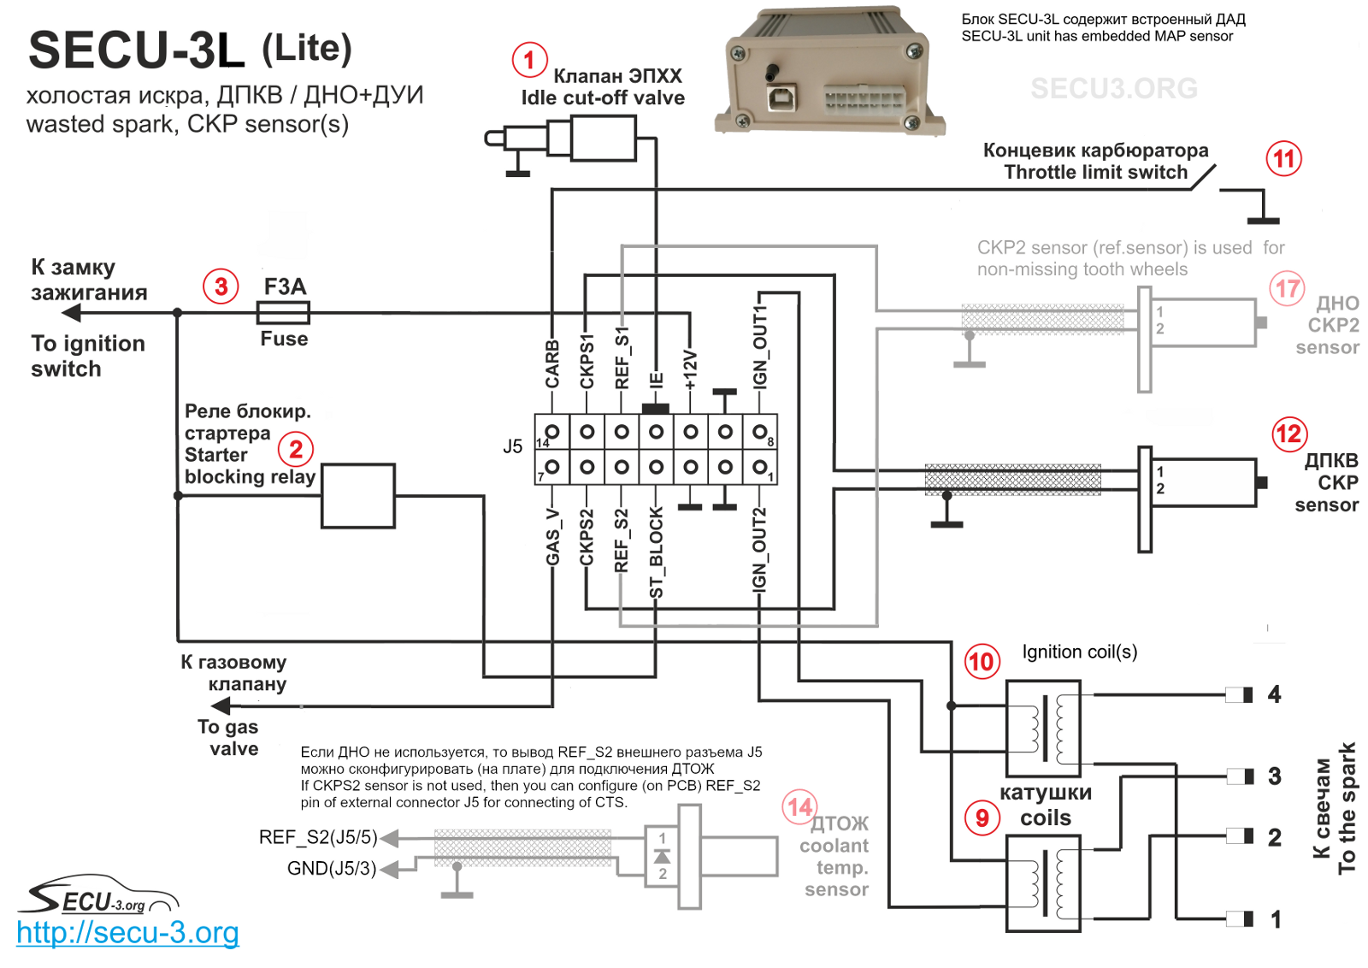
Wiring/secu3l_wiring_ckps.png
