ashabelnikov/secu3doc/Wiring/secu3l_wiring_hall.png

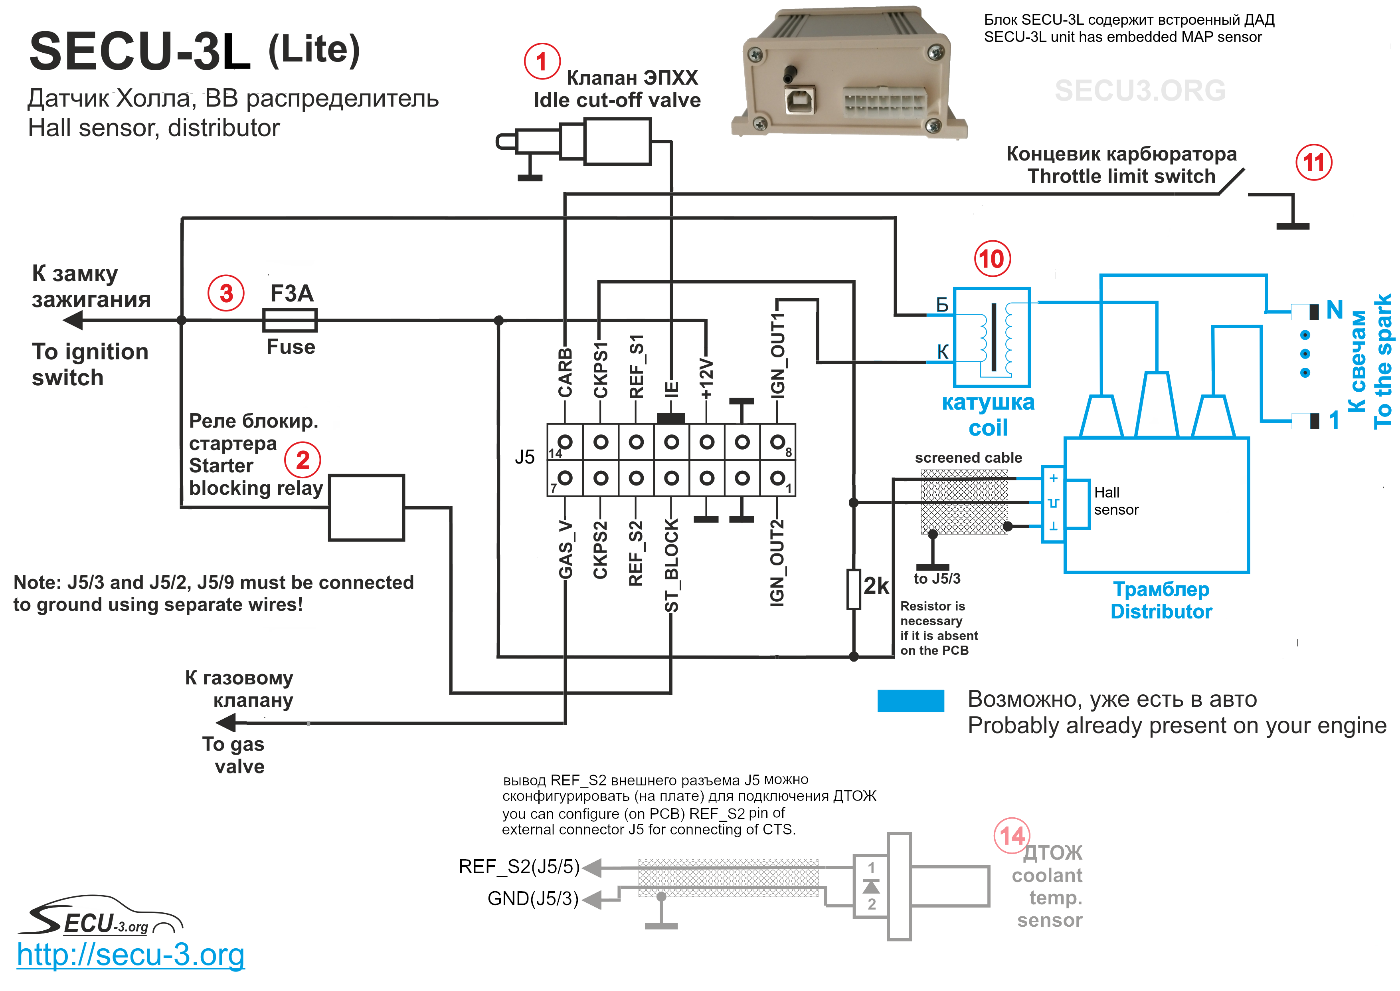
Wiring/secu3l_wiring_hall.png
