ashabelnikov/secu3doc/Wiring/secu3t-wiring-inj-drv4-sequential.png

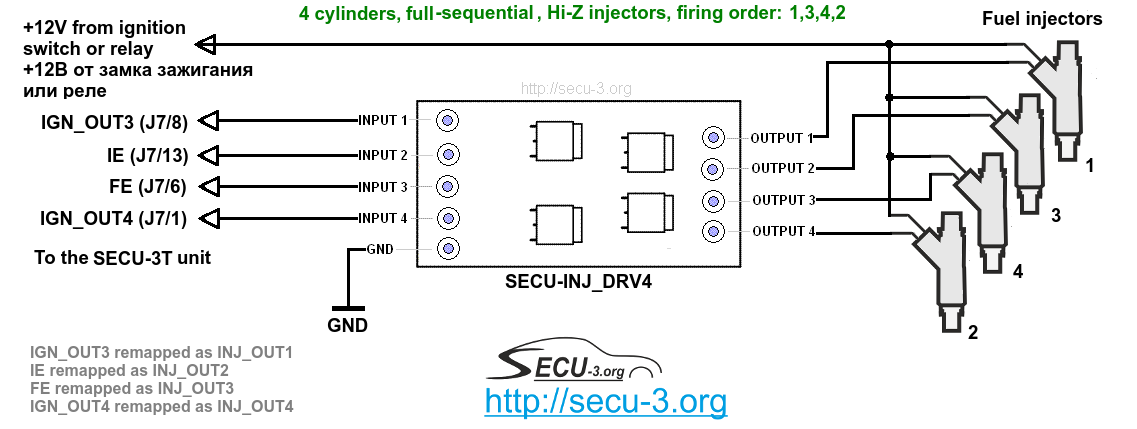
Wiring/secu3t-wiring-inj-drv4-sequential.png
