ashabelnikov/secu3doc/Wiring/secu3t-wiring-inj-drv4-simultaneous.png

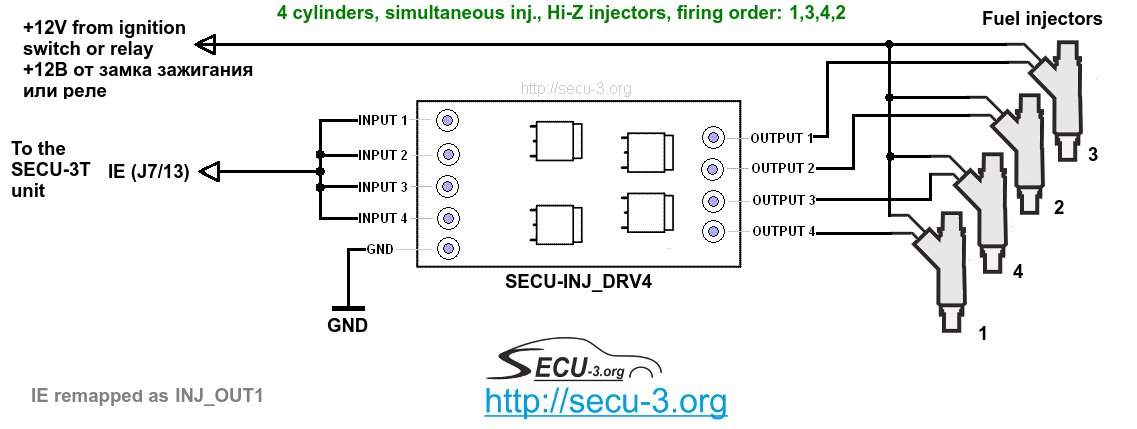
Wiring/secu3t-wiring-inj-drv4-simultaneous.png
