ashabelnikov/secu3doc/Wiring/secu3t-wiring-pnh-drv4.png

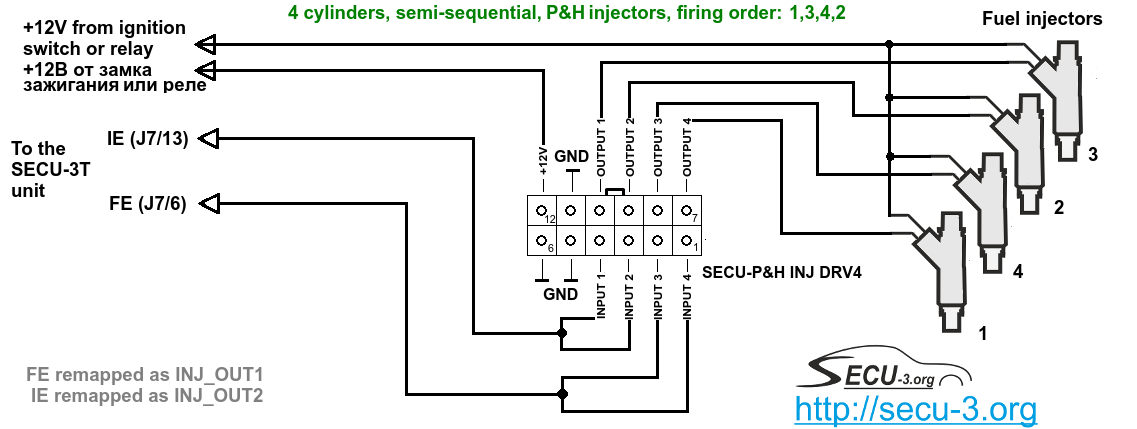
Wiring/secu3t-wiring-pnh-drv4.png
