ashabelnikov/secu3doc/Wiring/secu3t-wiring-pnh-pwm-iac.png

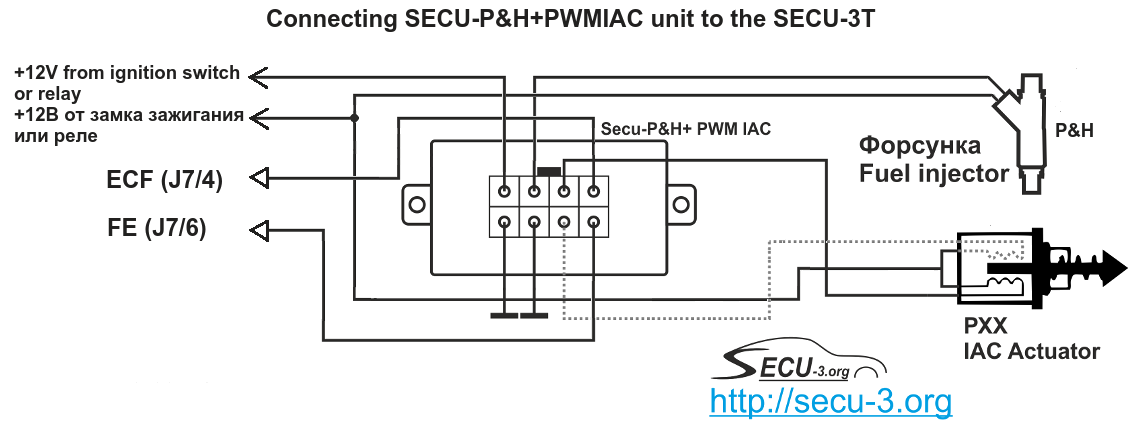
Wiring/secu3t-wiring-pnh-pwm-iac.png
