ashabelnikov/secu3doc/Wiring/secu3t_blde_to_secu-step.png

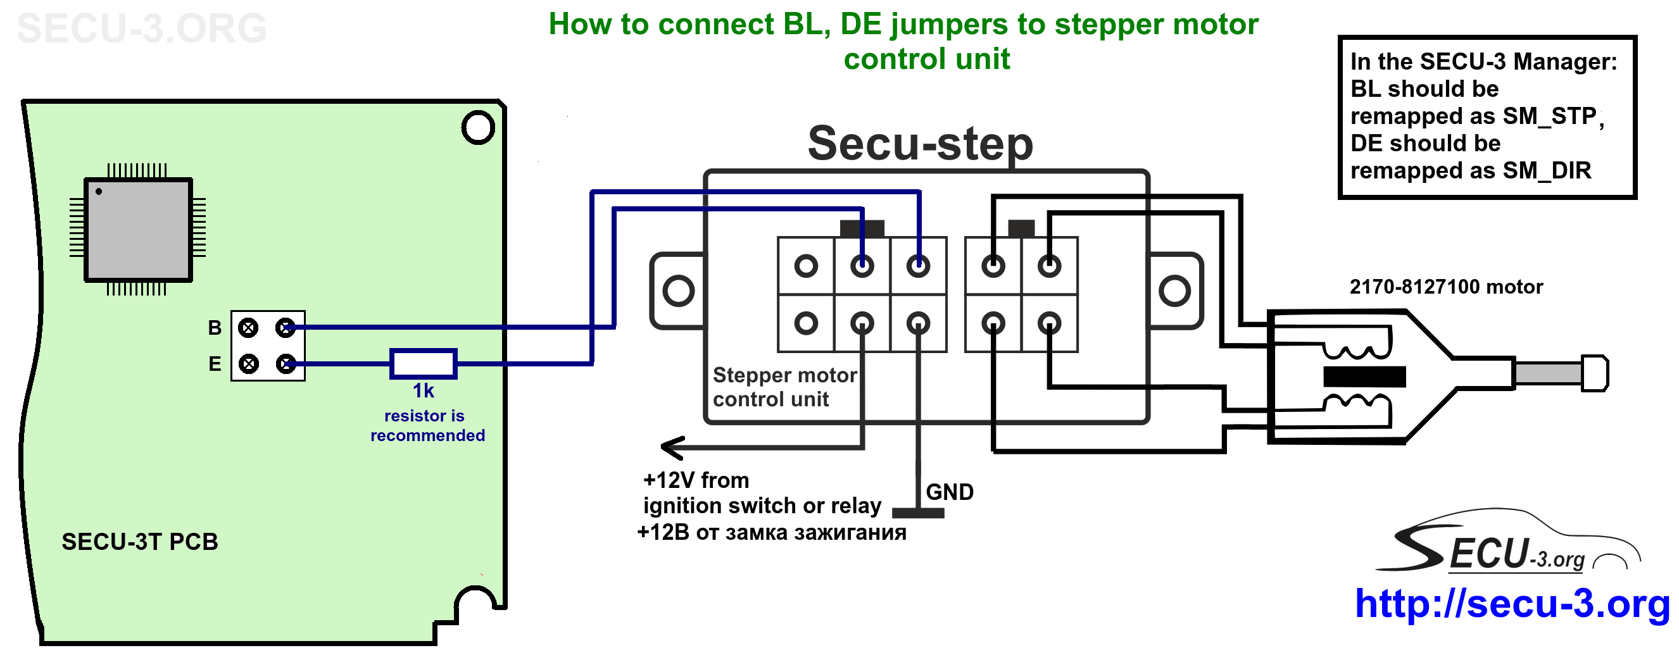
Wiring/secu3t_blde_to_secu-step.png
