ashabelnikov/secu3doc/Wiring/secu3t_wiring_inj_hi-z_stepper1.png

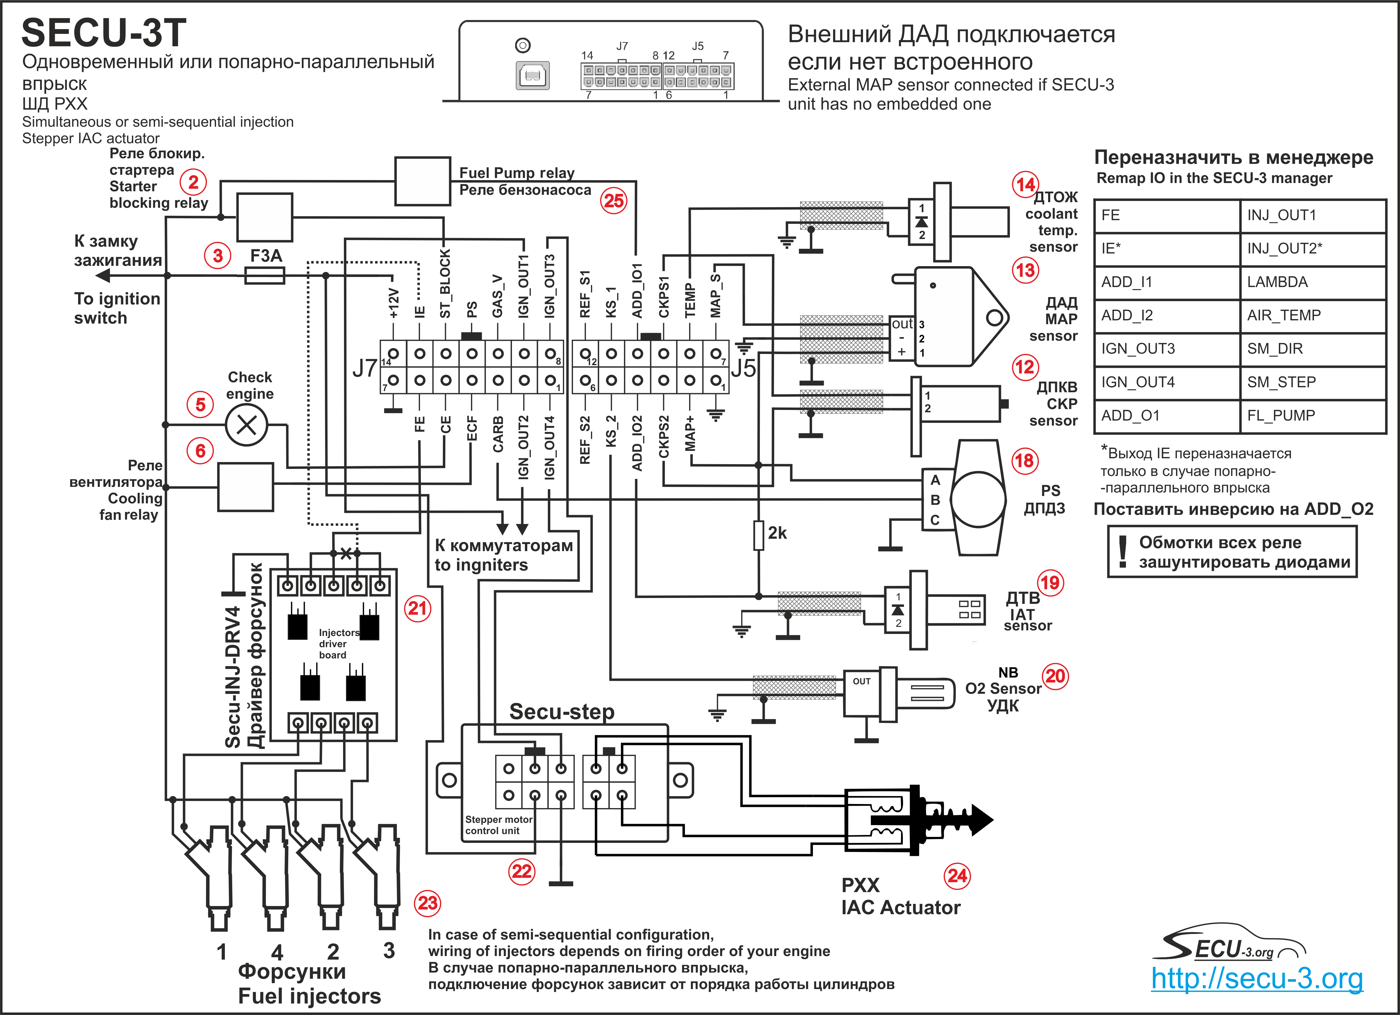
Wiring/secu3t_wiring_inj_hi-z_stepper1.png
