ashabelnikov/secu3doc/Wiring/secu3t_wiring_inj_lo-z_pwmiac1.png

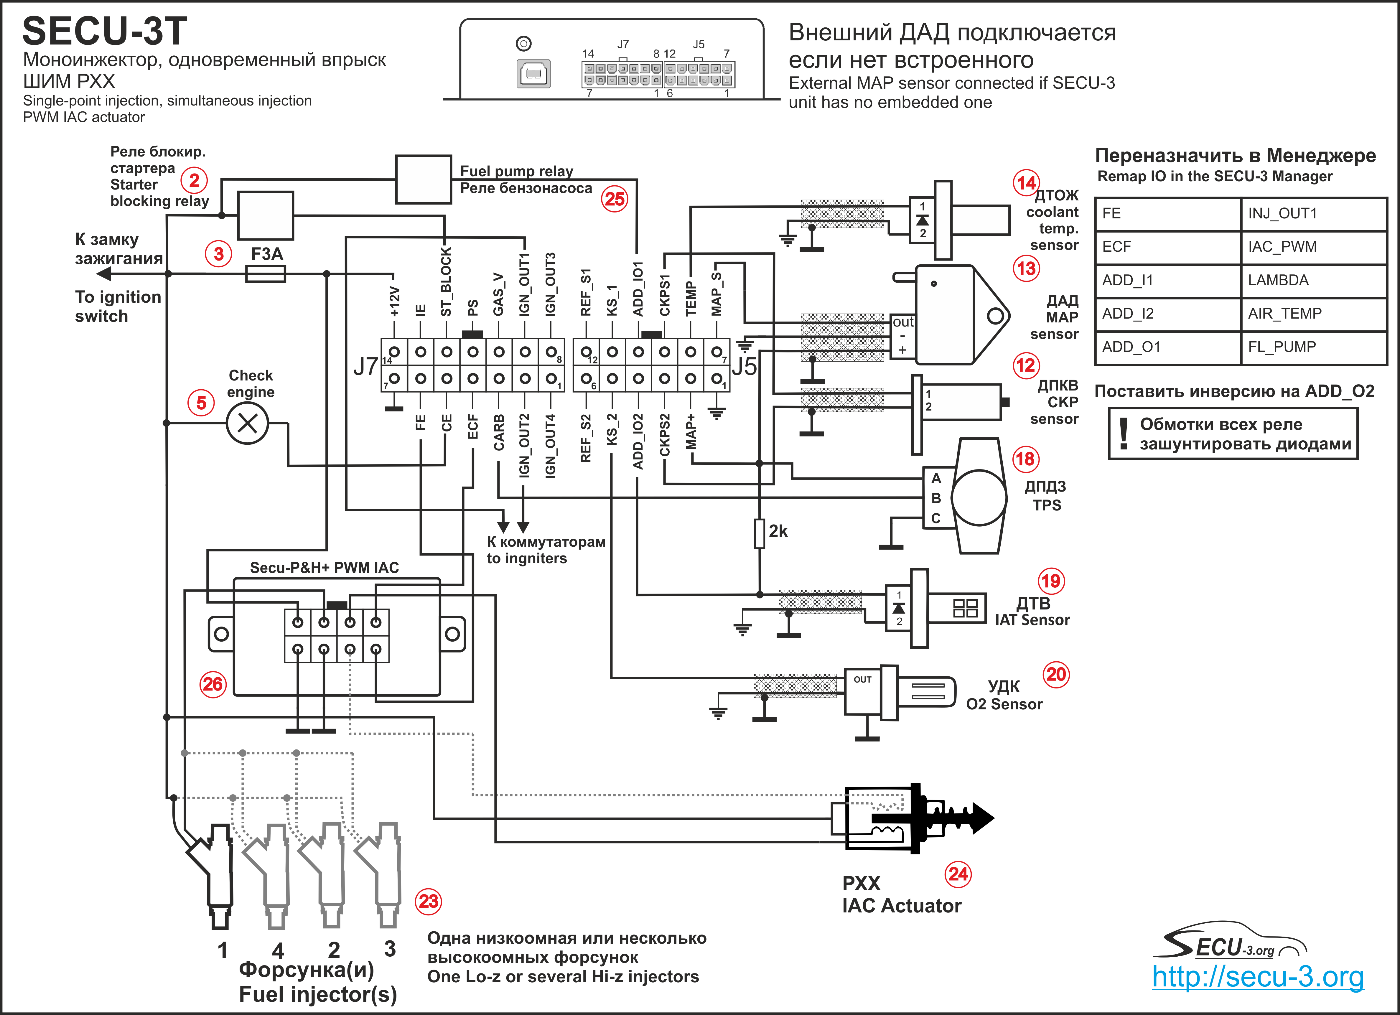
Wiring/secu3t_wiring_inj_lo-z_pwmiac1.png
