ashabelnikov/secu3doc/Wiring/secu3t_wiring_sc_pwm_iac.png

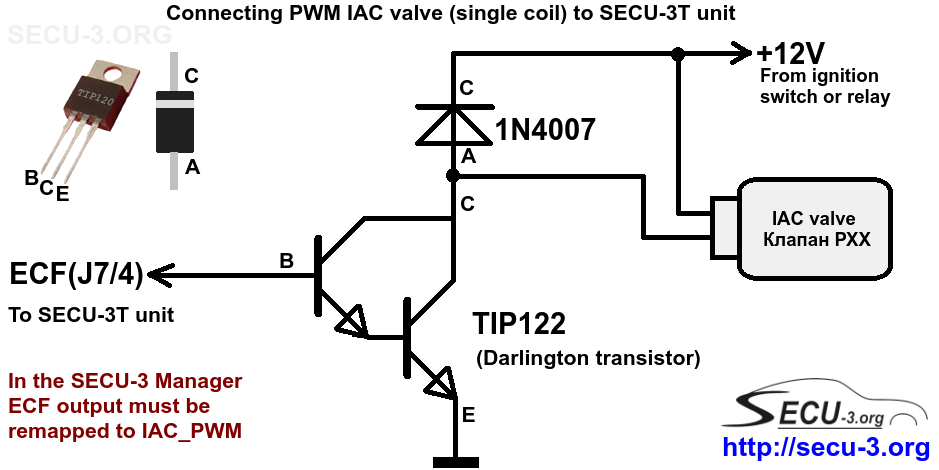
Wiring/secu3t_wiring_sc_pwm_iac.png
