ashabelnikov/secu3doc/Wiring/secu3t_wiring_stepper_iac.png

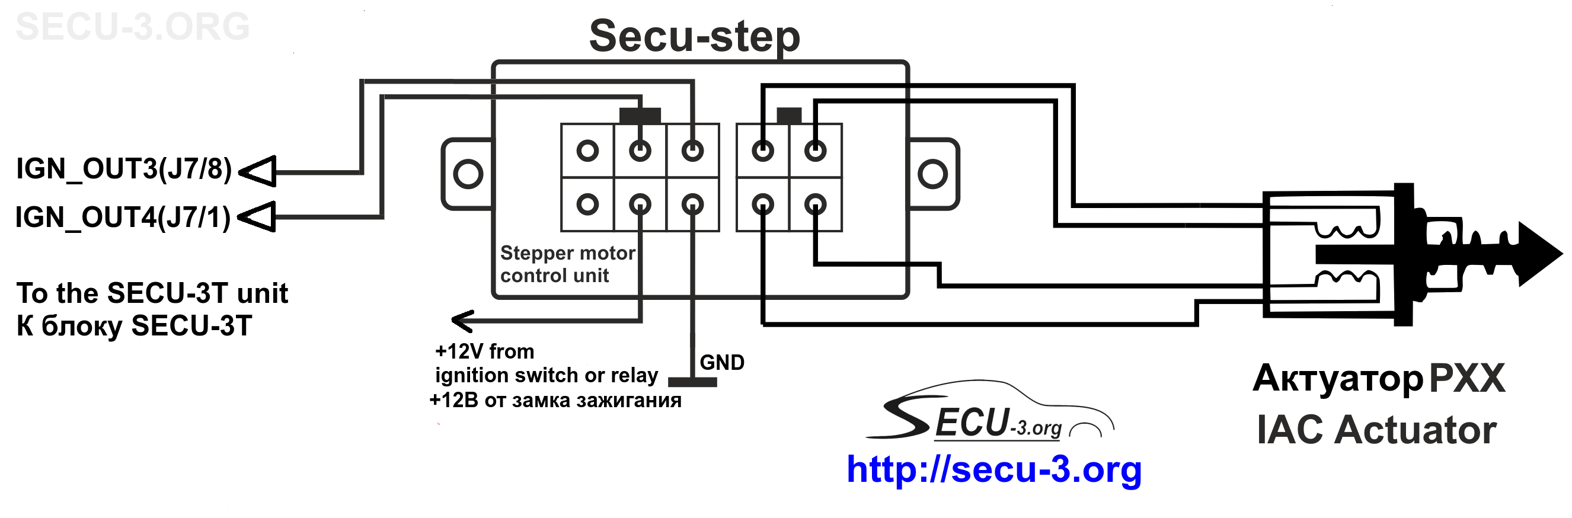
Wiring/secu3t_wiring_stepper_iac.png
