ashabelnikov/secu3doc/Wiring/secu-3-lite-grounding.png

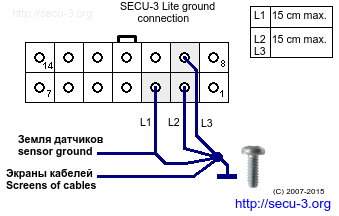
Wiring/secu-3-lite-grounding.png
