ashabelnikov/secu3doc/Wiring/secu-3-lite_to_secu-step.png

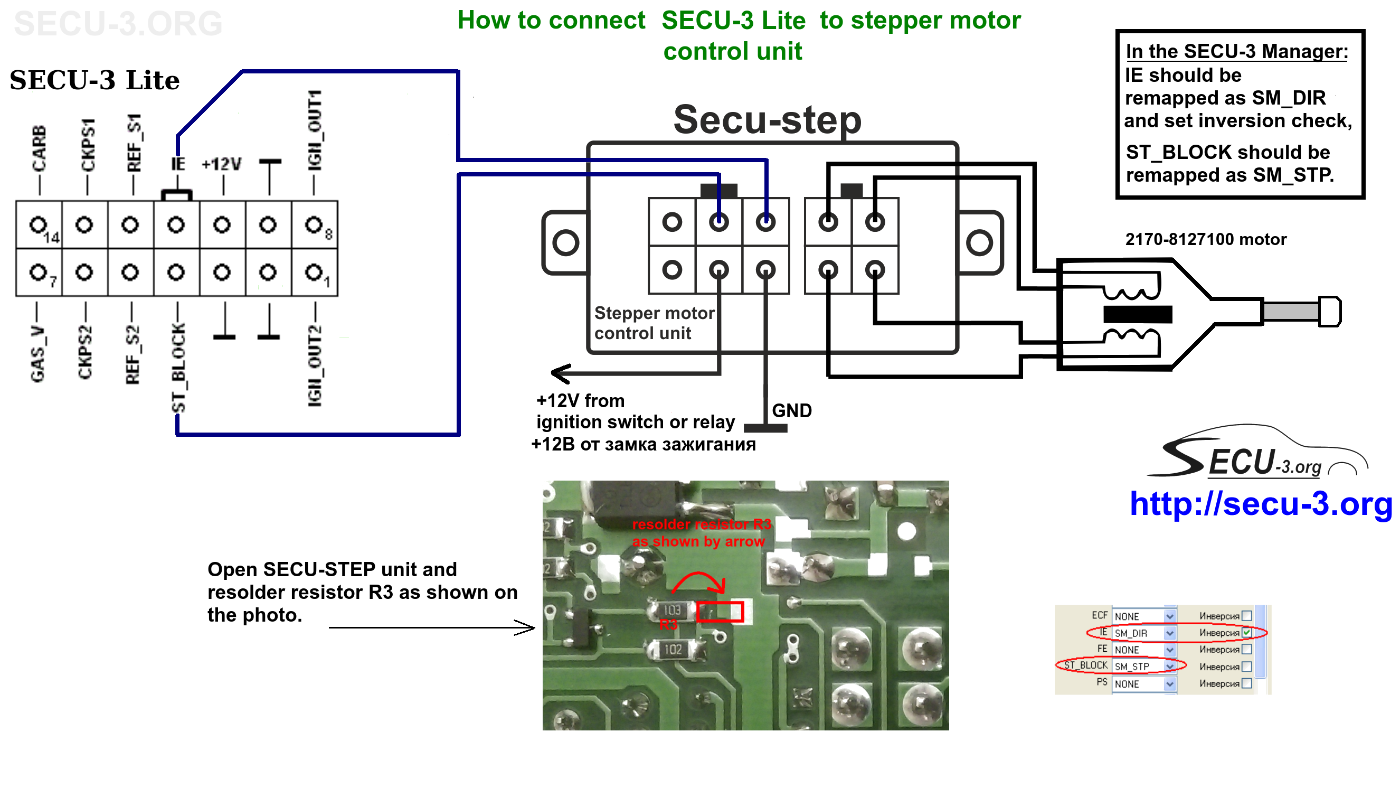
Wiring/secu-3-lite_to_secu-step.png
