ashabelnikov/secu3doc/Wiring/secu-3-mapsel-rotary-switch.png

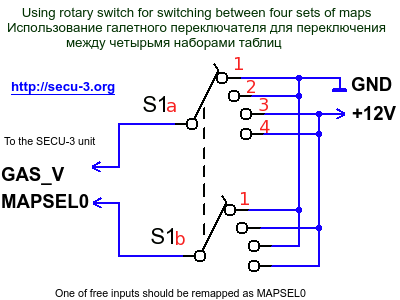
Wiring/secu-3-mapsel-rotary-switch.png
