ashabelnikov/secu3doc/Wiring/secu-3-micro-grounding.png

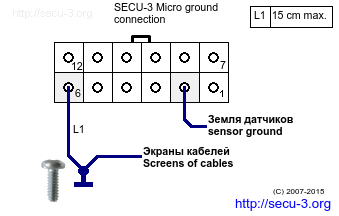
Wiring/secu-3-micro-grounding.png
