ashabelnikov/secu3doc/Wiring/secu-3i-wiring-4x4-0.png

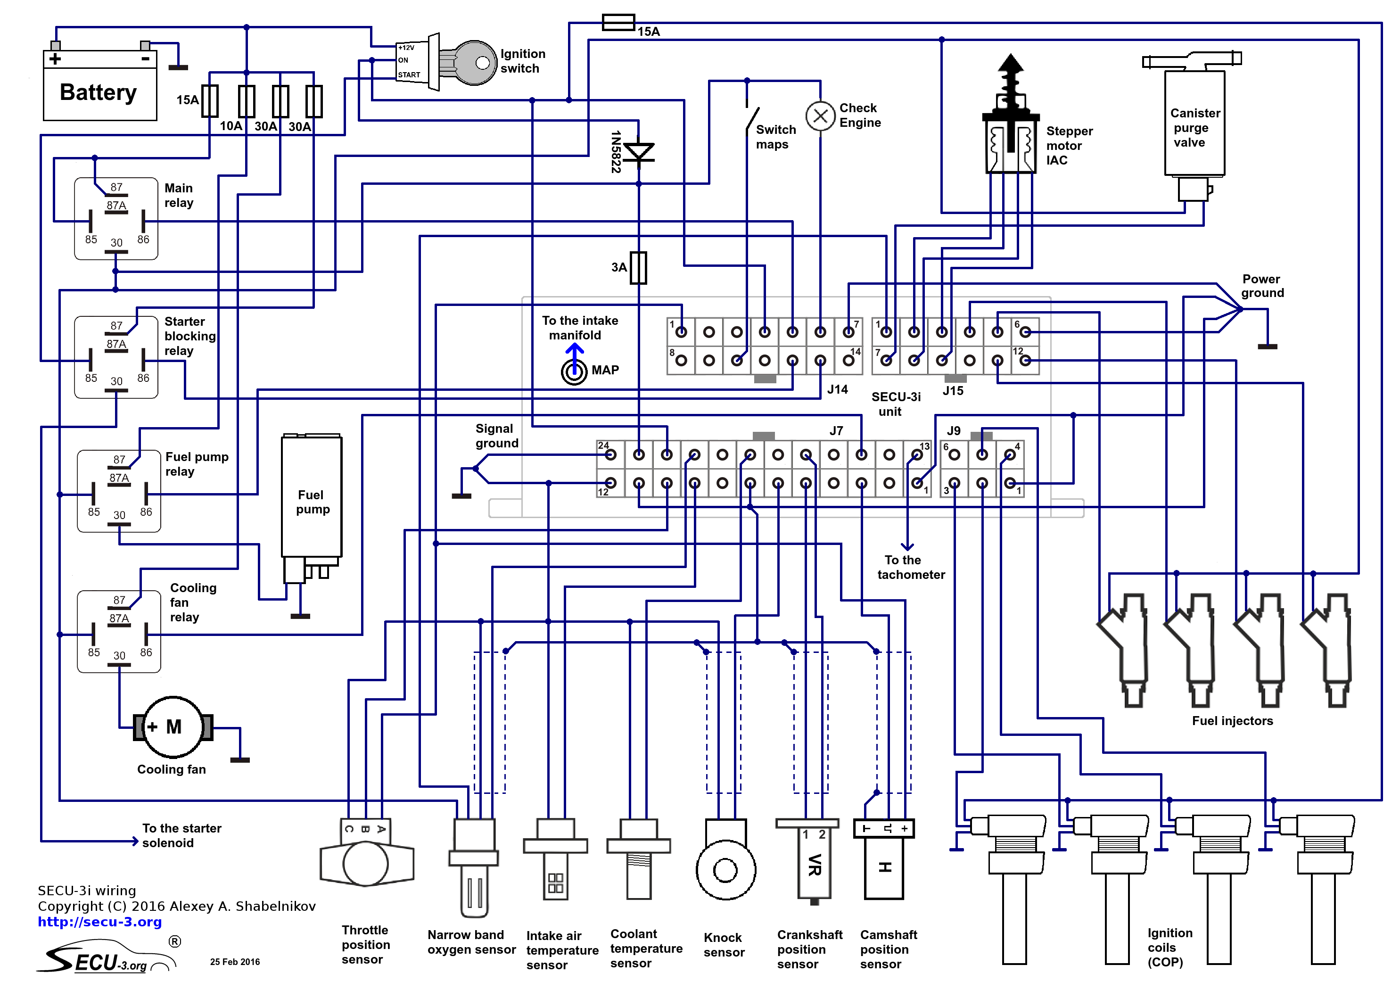
Wiring/secu-3i-wiring-4x4-0.png
