ashabelnikov/secu3doc/Wiring/secu-3l-w-o-st-block.jpg

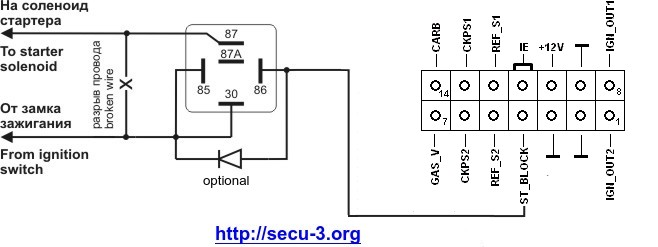
Wiring/secu-3l-w-o-st-block.jpg
