ashabelnikov/secu3doc/Wiring/secu-3l-wiring-ckps-distributor.png

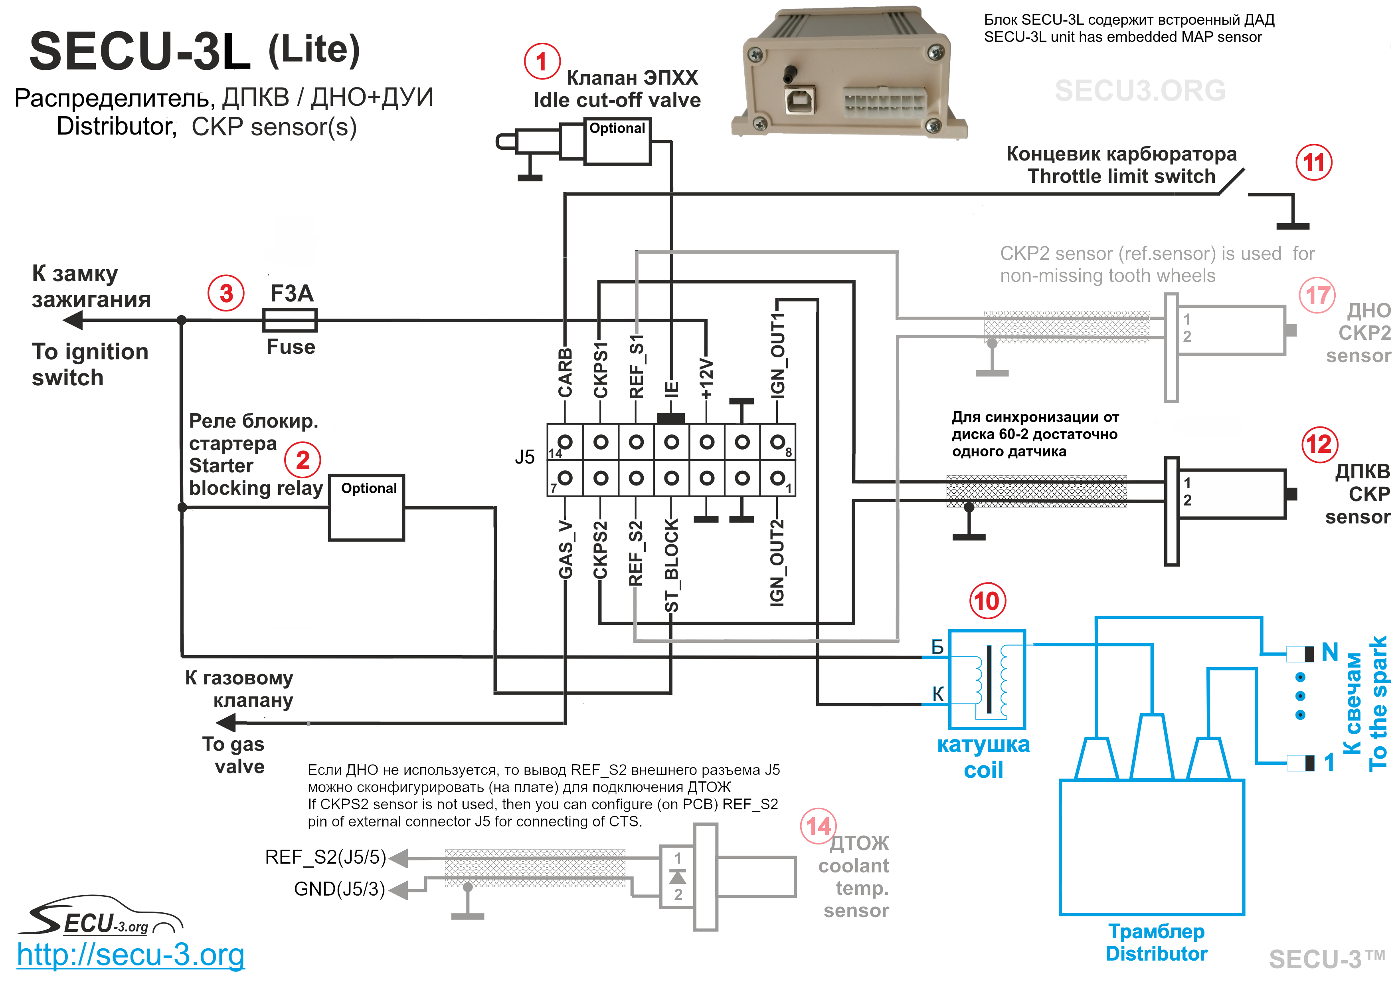
Wiring/secu-3l-wiring-ckps-distributor.png
