ashabelnikov/secu3doc/Wiring/secu-3m-bip373-ws-4cyl.png

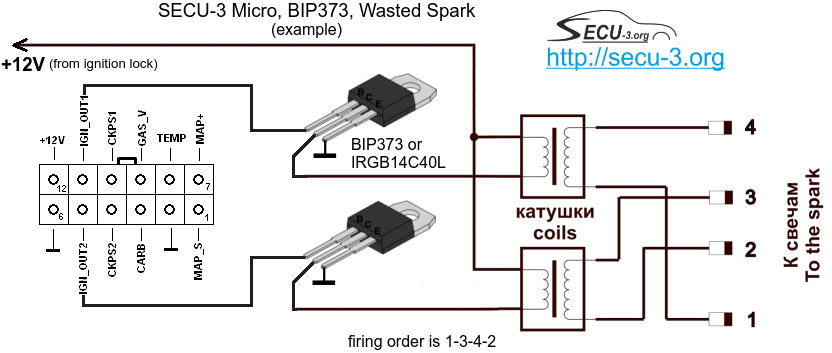
Wiring/secu-3m-bip373-ws-4cyl.png
