ashabelnikov/secu3doc/Wiring/SECU-3M_distributor.png

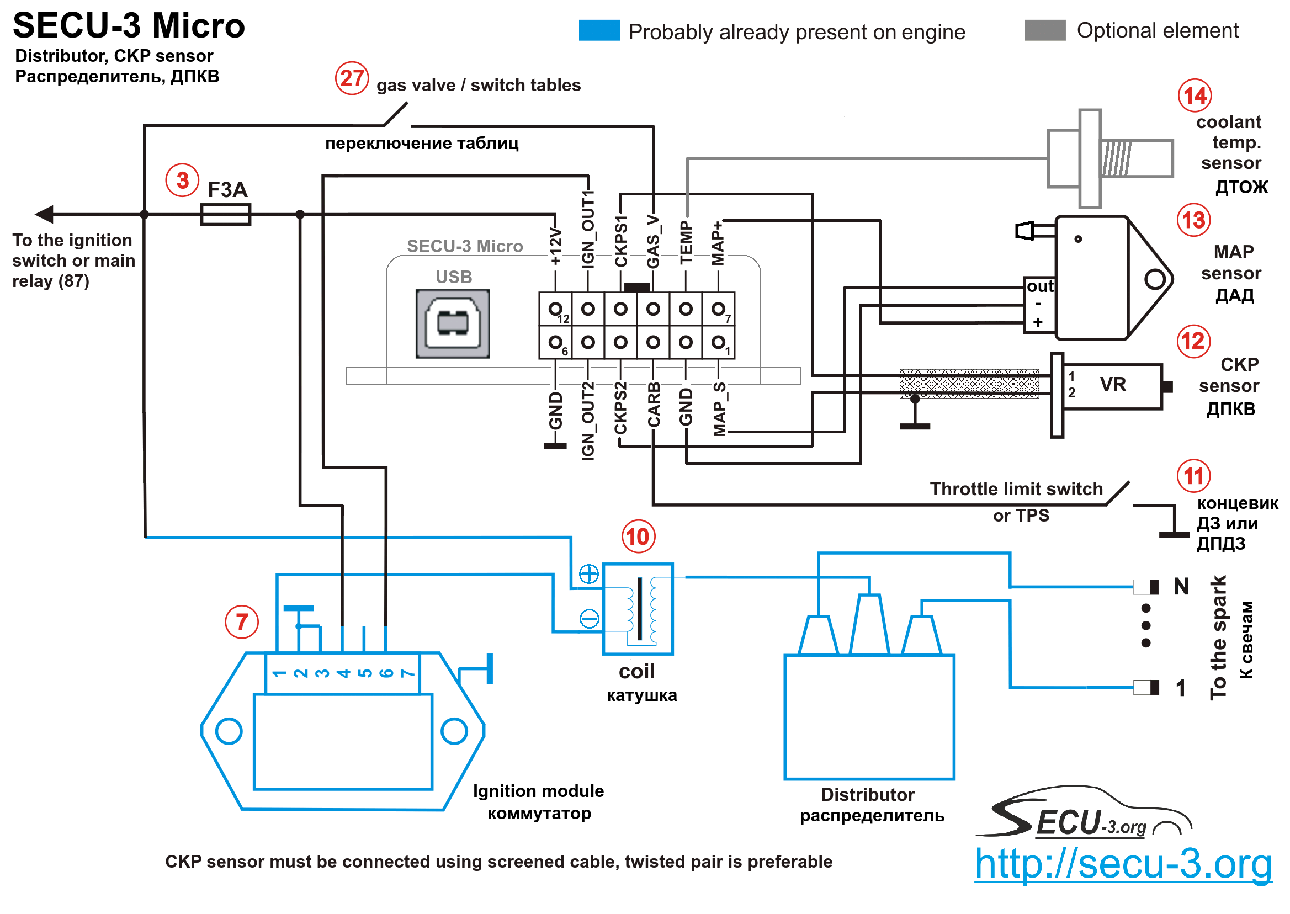
Wiring/SECU-3M_distributor.png
