ashabelnikov/secu3doc/Wiring/SECU-3M_distributor_hall.png

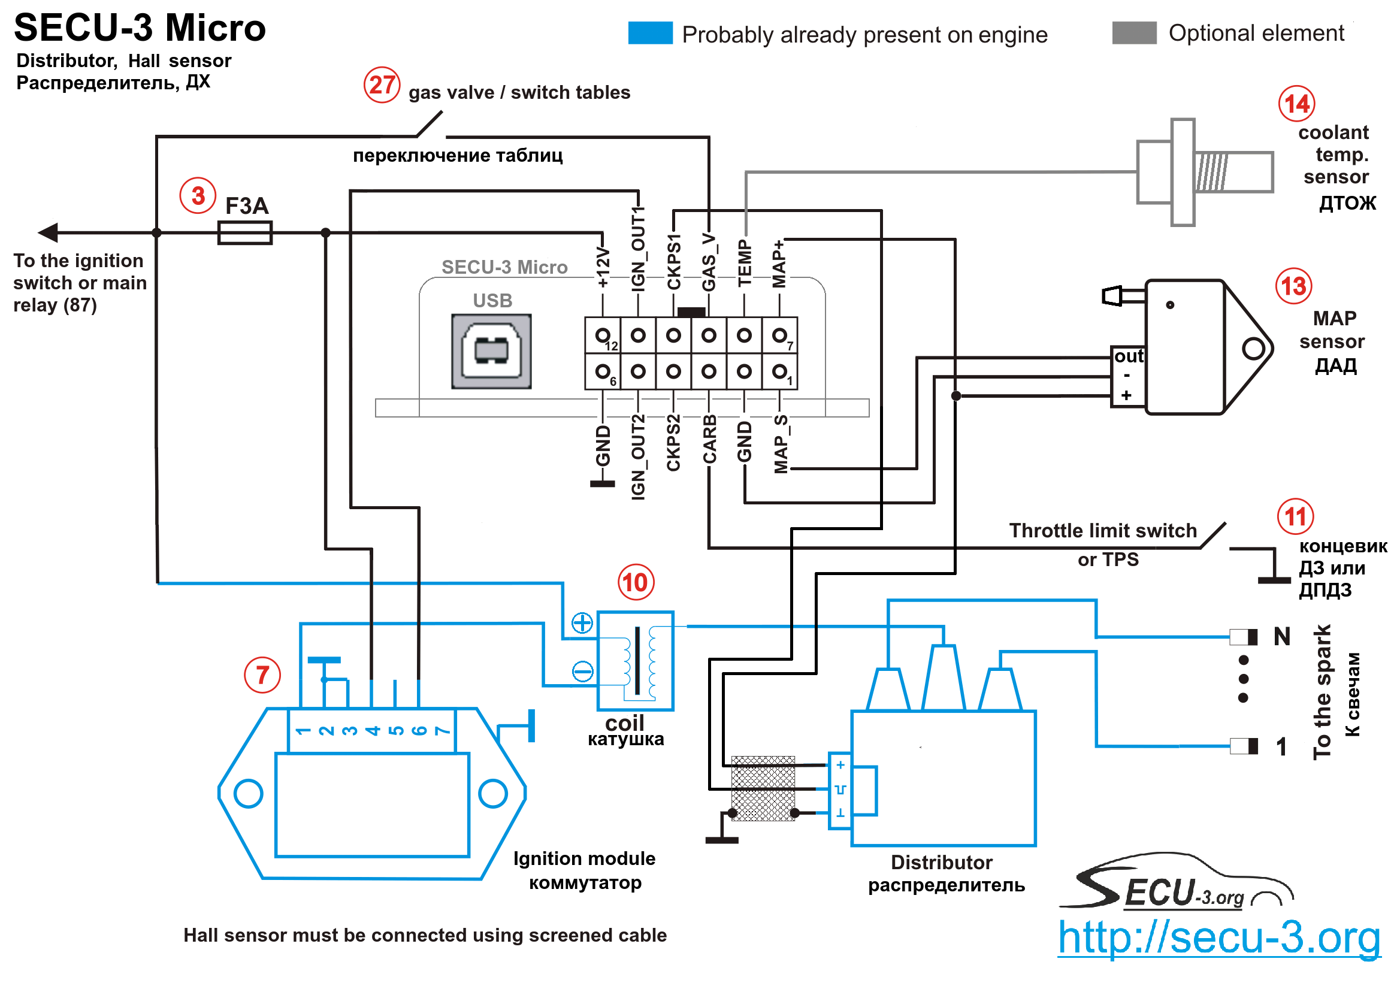
Wiring/SECU-3M_distributor_hall.png
