ashabelnikov/secu3doc/Wiring/SECU-3M_ws_ckps.png

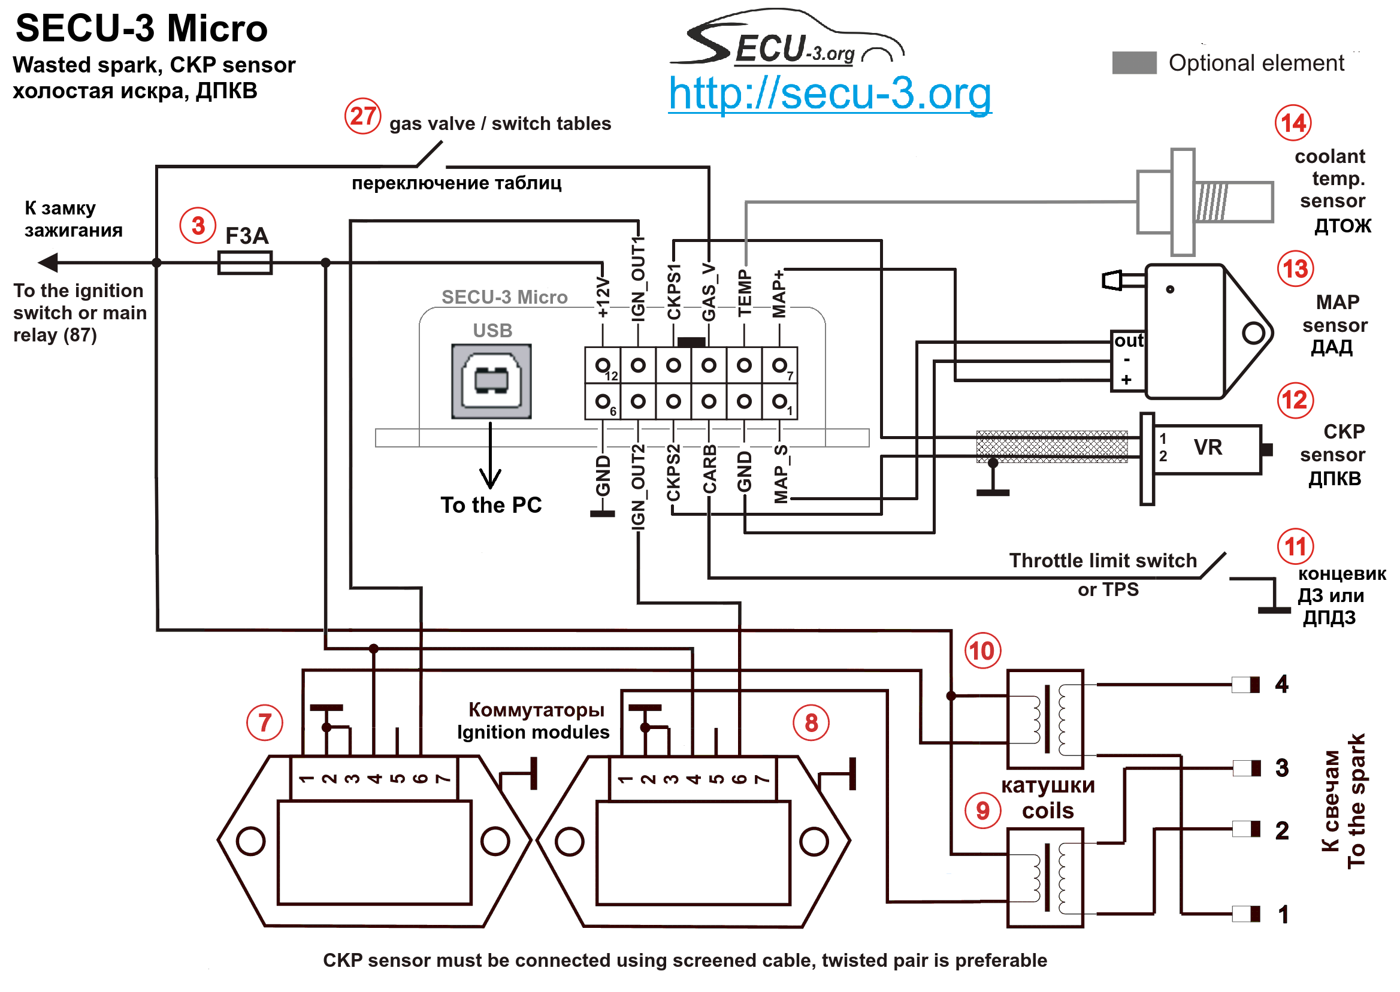
Wiring/SECU-3M_ws_ckps.png
