ashabelnikov/secu3doc/Wiring/secu-3t-bip373-ws-4cyl.png

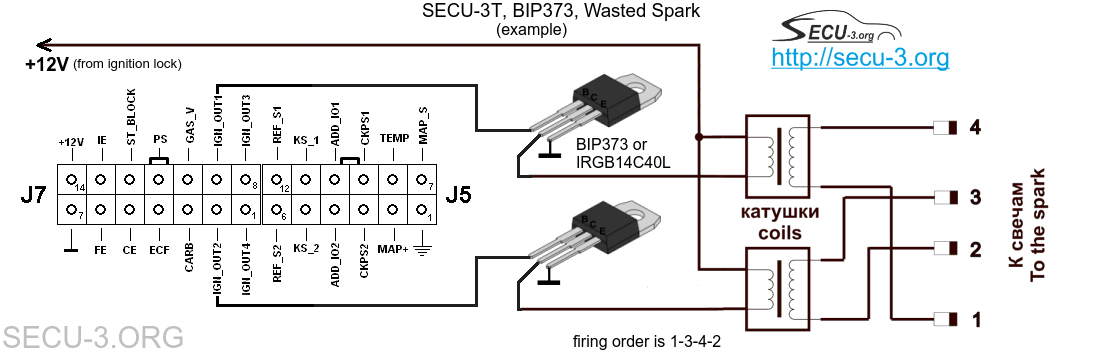
Wiring/secu-3t-bip373-ws-4cyl.png
