ashabelnikov/secu3doc/Wiring/secu-3t-ign34-to-secu-step.png

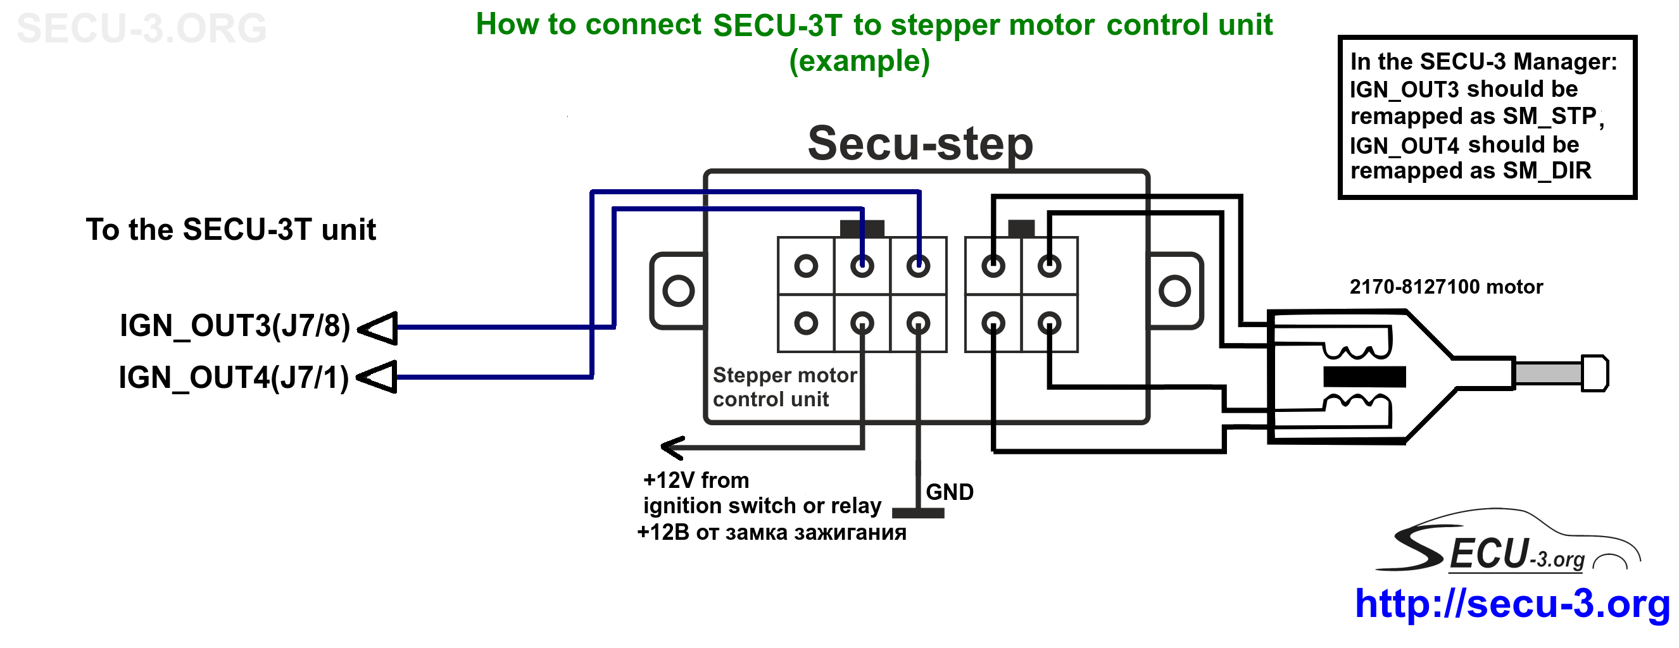
Wiring/secu-3t-ign34-to-secu-step.png
