ashabelnikov/secu3doc/Wiring/secu-3t-sequential-bip373-6cyl.png

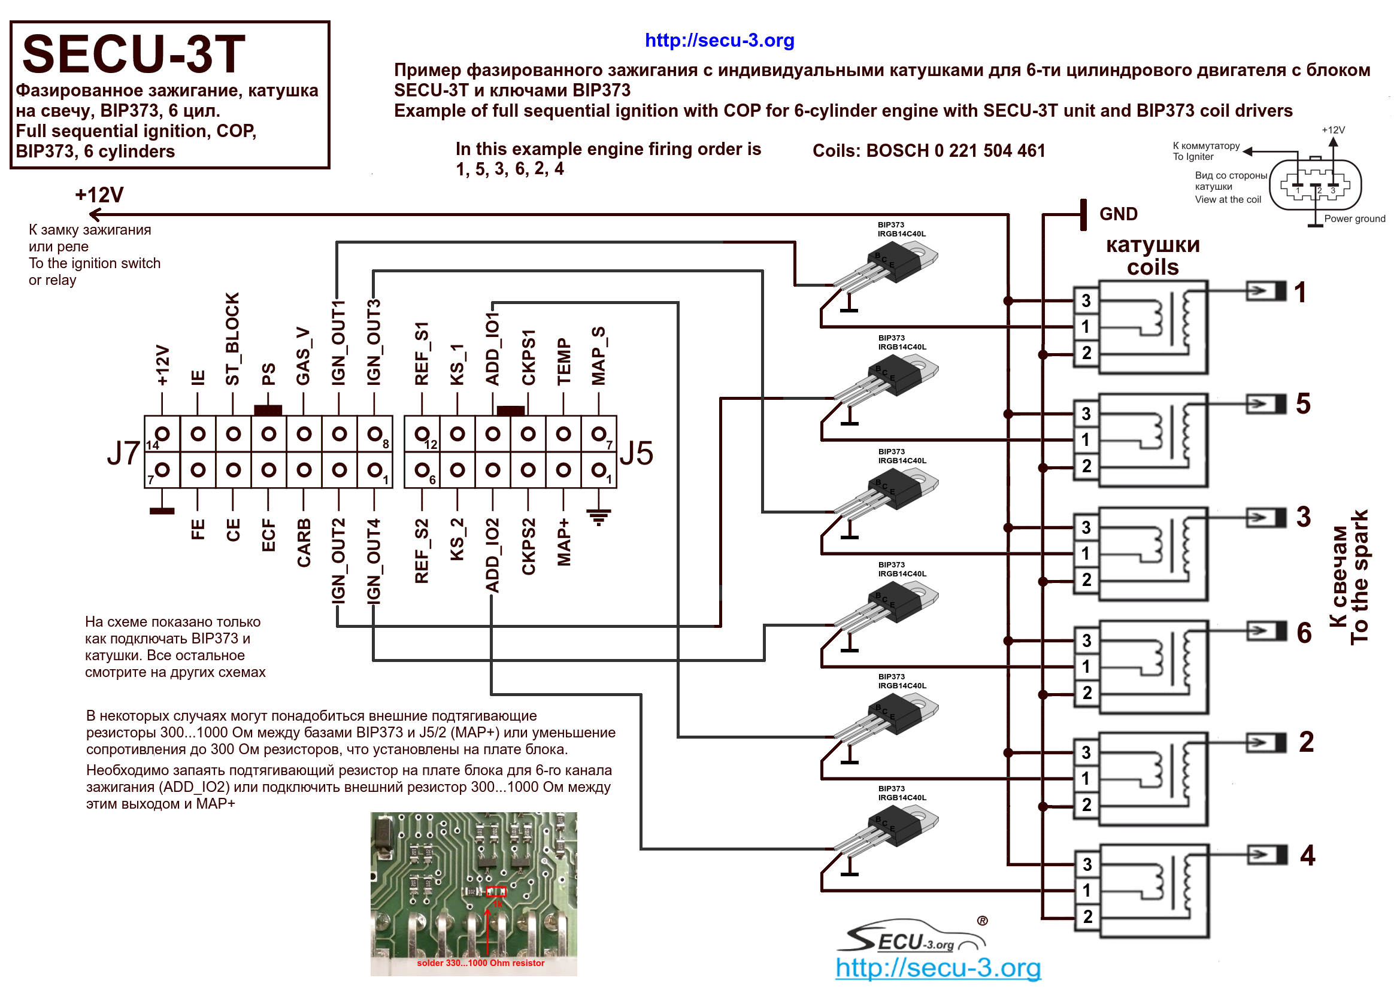
Wiring/secu-3t-sequential-bip373-6cyl.png
