ashabelnikov/secu3doc/Wiring/secu-3t-wiring-ign-module.png

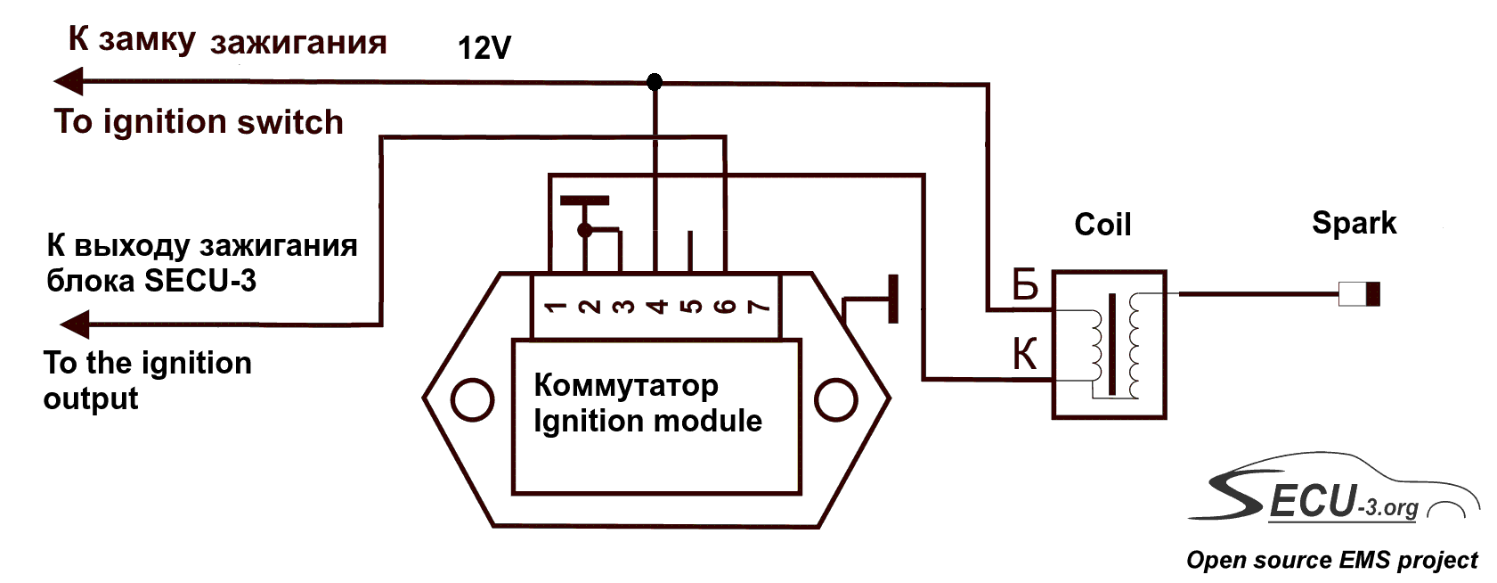
Wiring/secu-3t-wiring-ign-module.png
