ashabelnikov/secu3doc/Wiring/secu-3t-wiring-nb-oxygen-2.png

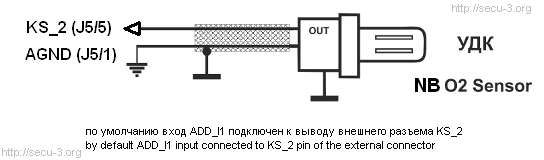
Wiring/secu-3t-wiring-nb-oxygen-2.png
