ashabelnikov/secu3doc/Wiring/secu-3t-wiring-nb-oxygen-4.png

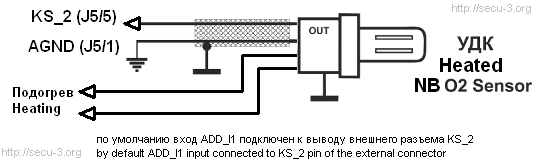
Wiring/secu-3t-wiring-nb-oxygen-4.png
