ashabelnikov/secu3doc/Wiring/secu-3t-wiring-stepper-attuator.png

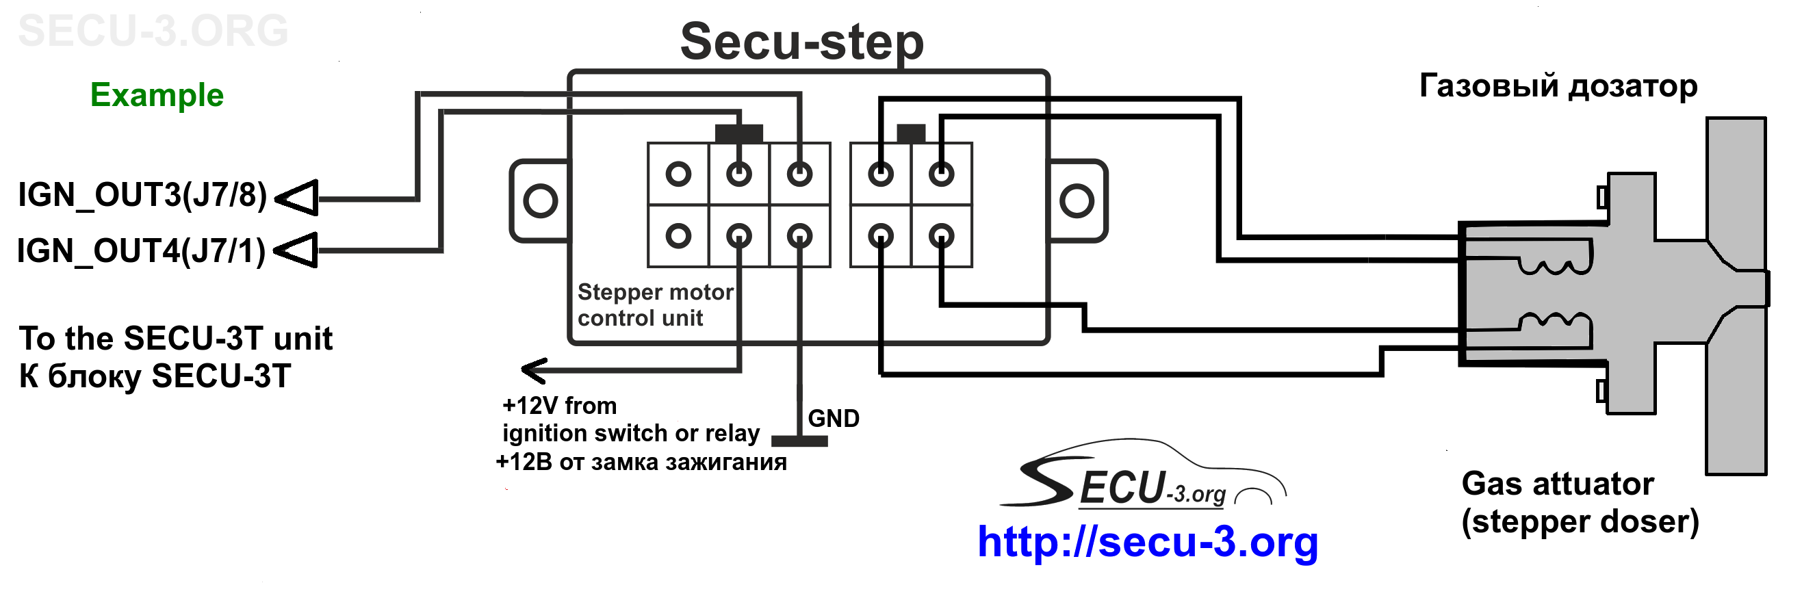
Wiring/secu-3t-wiring-stepper-attuator.png
