ashabelnikov/secu3doc/Wiring/secu-3t-ws-bip373-8cyl.png

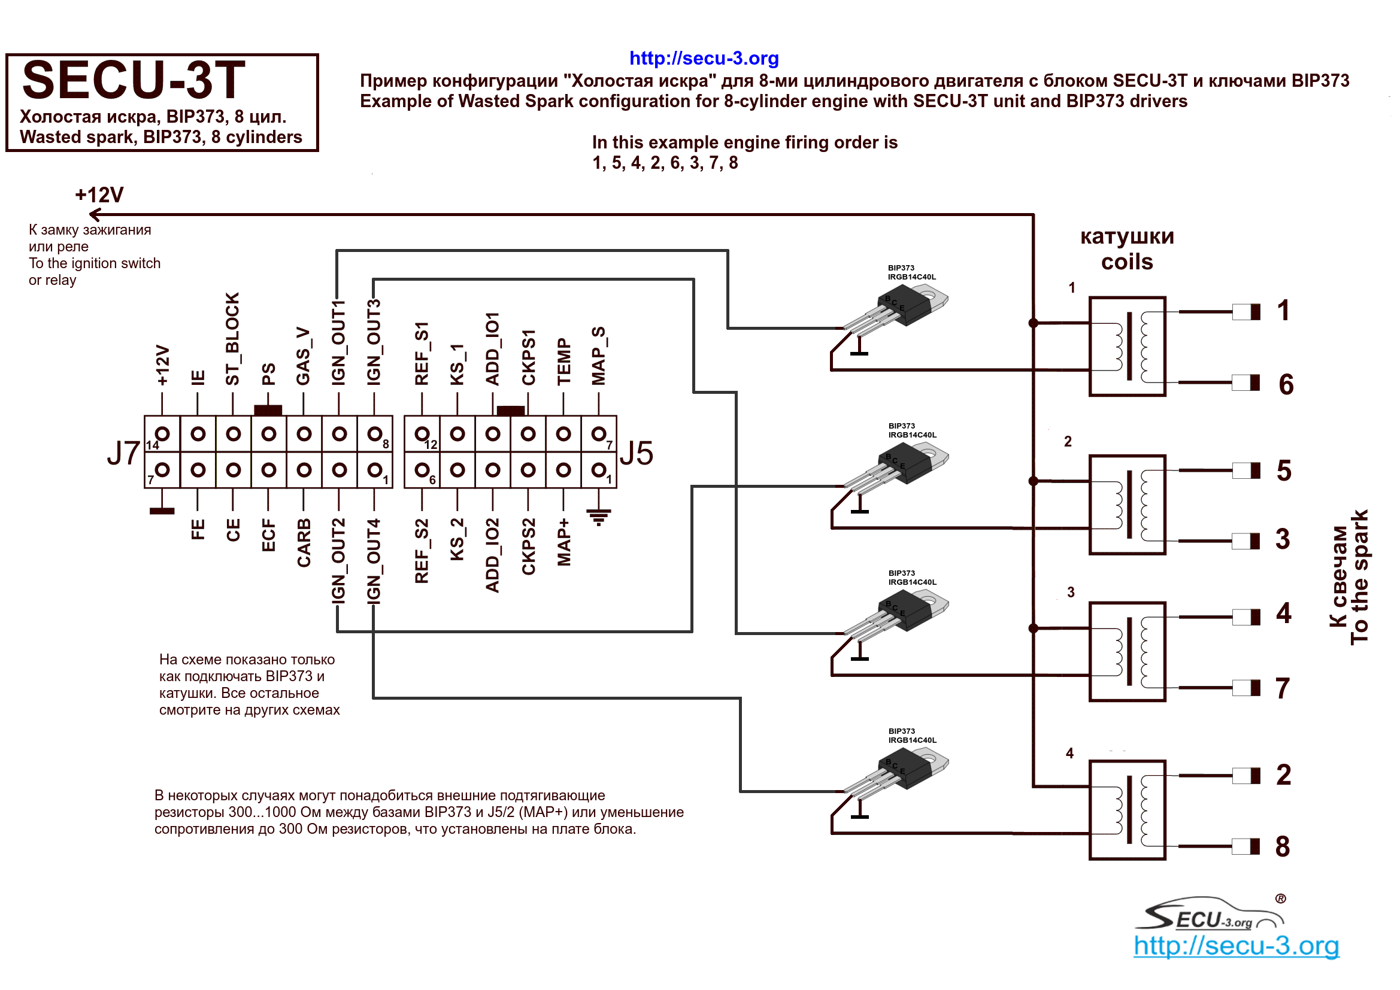
Wiring/secu-3t-ws-bip373-8cyl.png
