ashabelnikov/secu3doc/Wiring/secu-3t-ws-ckps-2chign.png

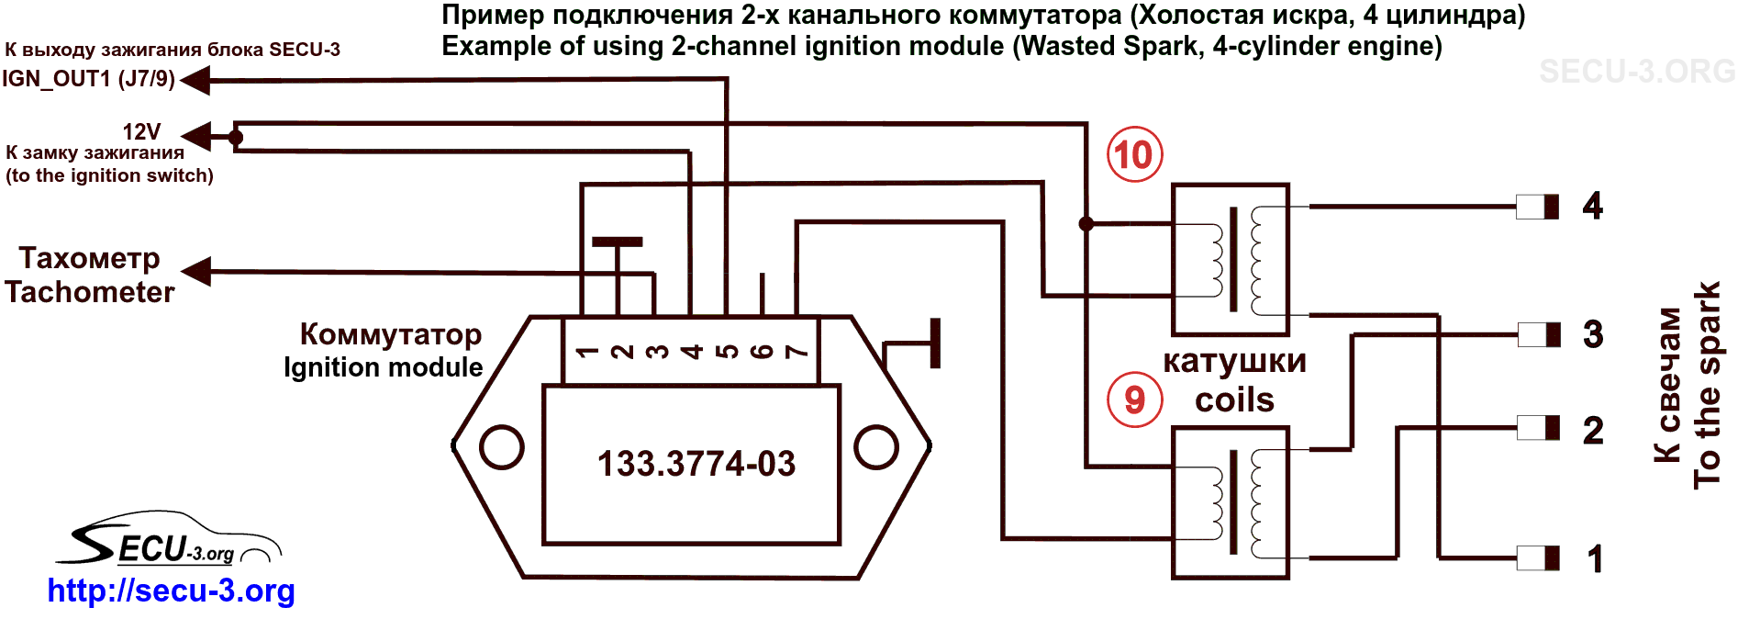
Wiring/secu-3t-ws-ckps-2chign.png
