ashabelnikov/secu3doc/Wiring/SECU-3T_min14+12.png

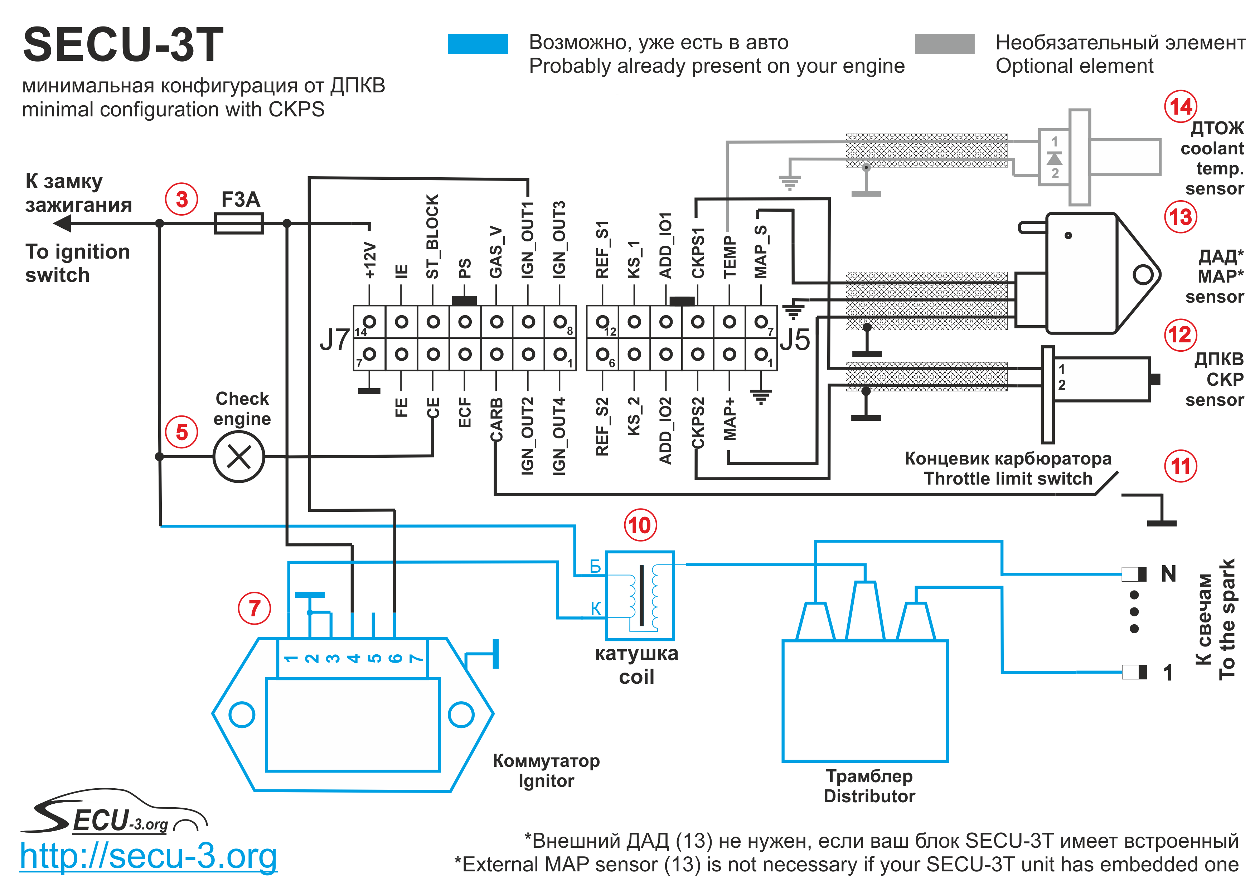
Wiring/SECU-3T_min14+12.png
