ashabelnikov/secu3doc/Wiring/SECU-3T_min_Hall Sensor14+12.png

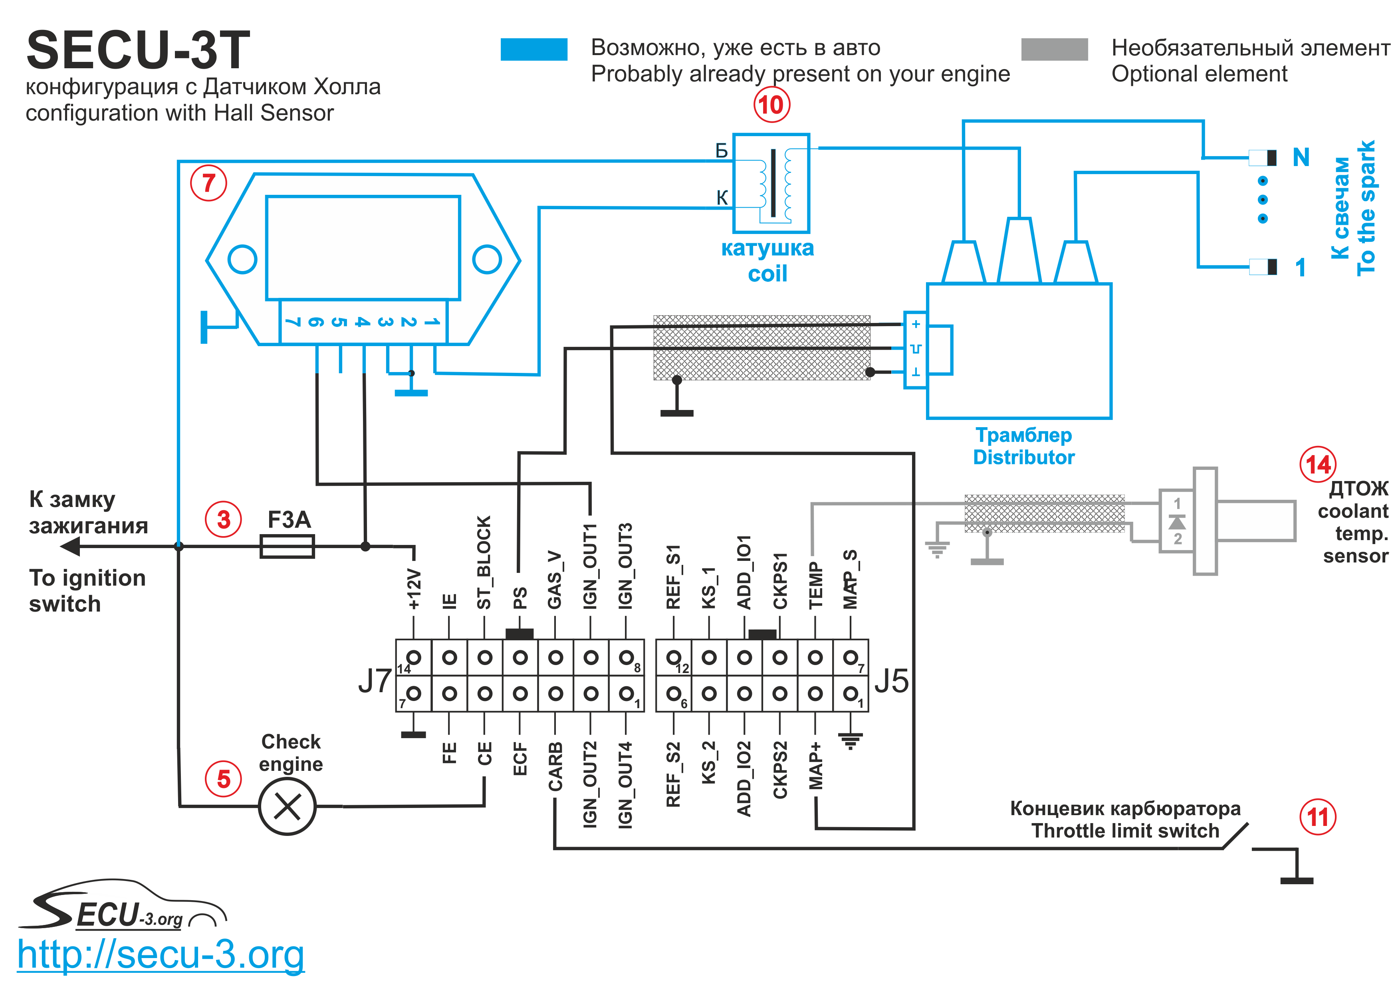
Wiring/SECU-3T_min_Hall Sensor14+12.png
