ashabelnikov/secu3doc/Wiring/SECU-3T_phased_ignition14+12.png

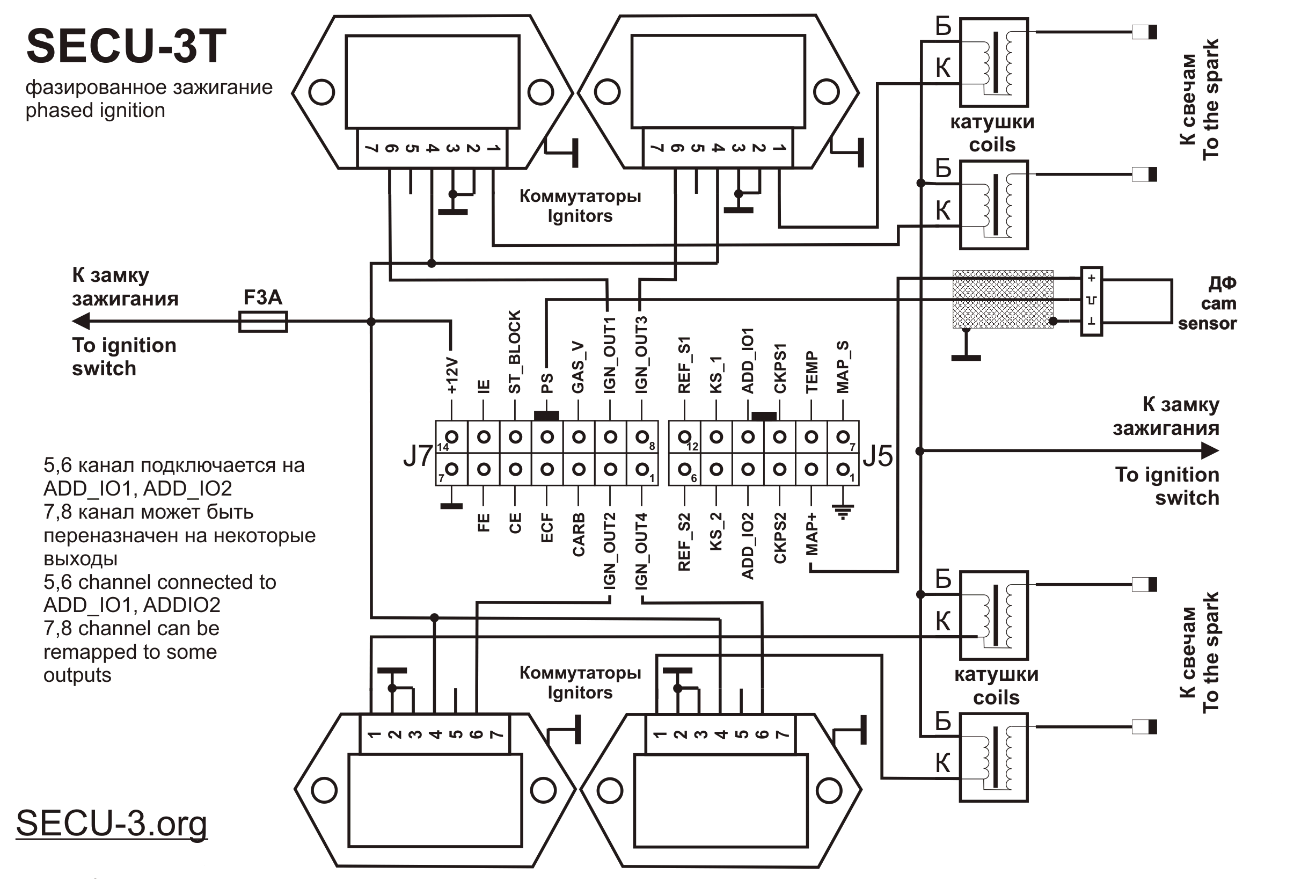
Wiring/SECU-3T_phased_ignition14+12.png
