ashabelnikov/secu3doc/Wiring/SECU-3T_PHASED_IGNITION_14+12.png

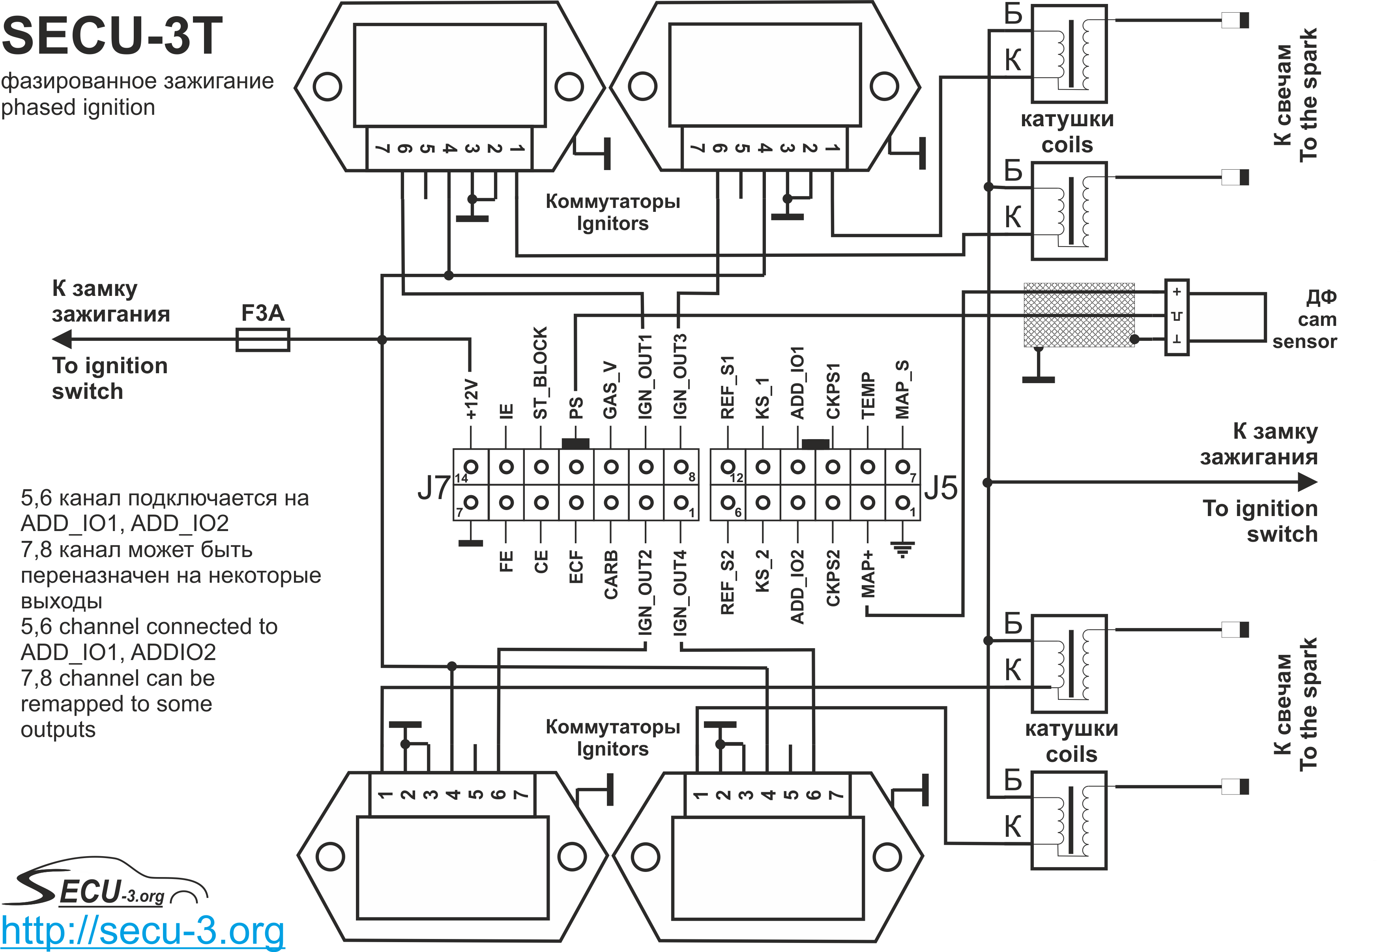
Wiring/SECU-3T_PHASED_IGNITION_14+12.png
