ashabelnikov/secu3doc/Wiring/SECU-3T_WS_CKPS.png

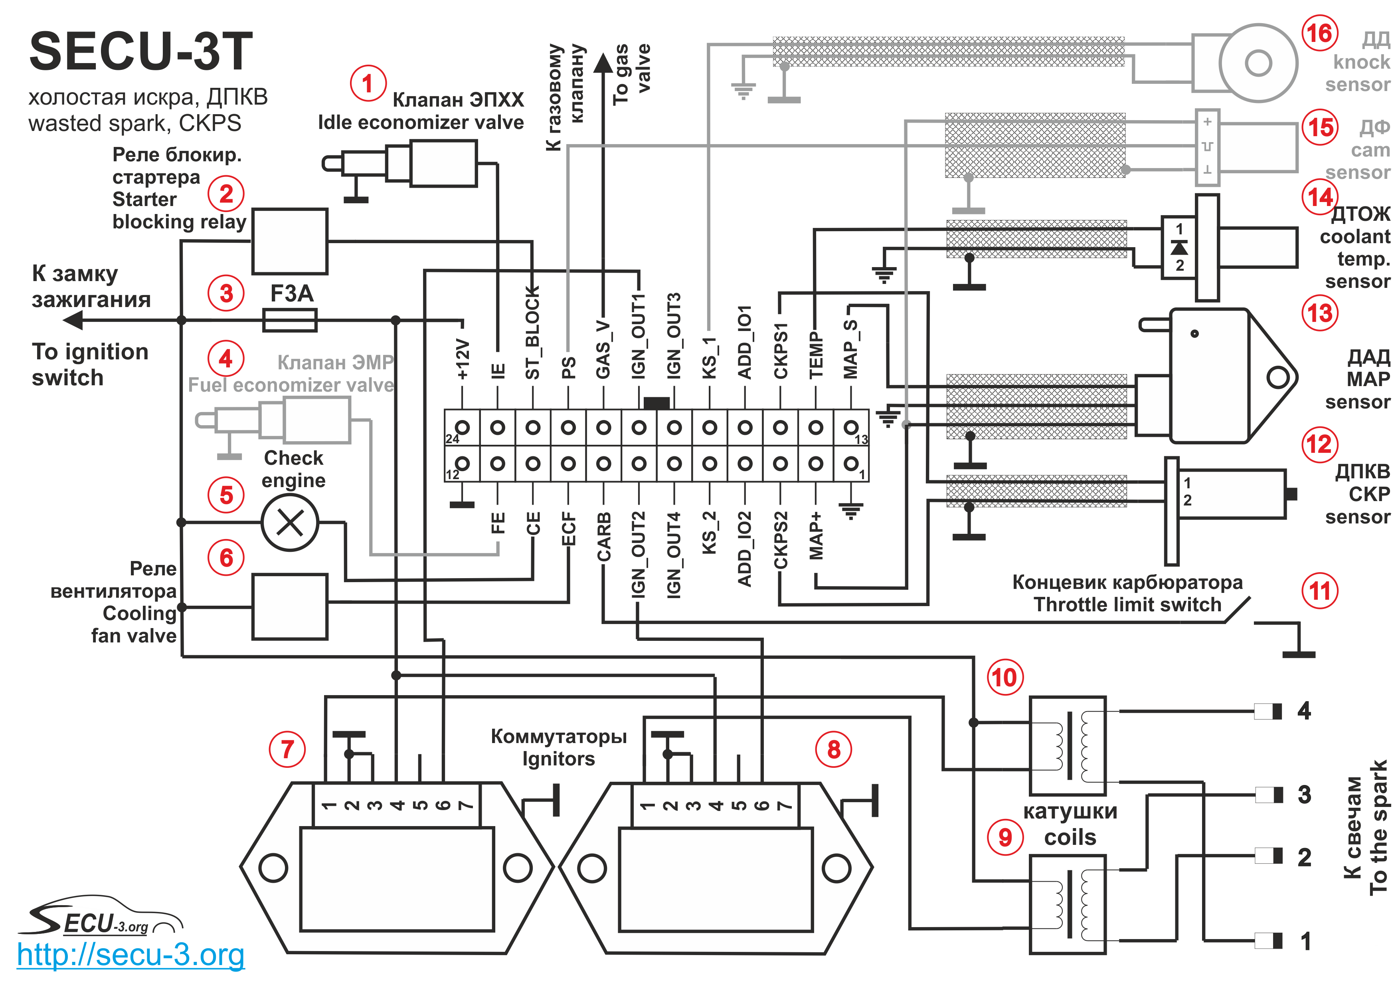
Wiring/SECU-3T_WS_CKPS.png
