ashabelnikov/secu3doc/Wiring/SECU-3T_WS_CKPS_2chign_14+12.png

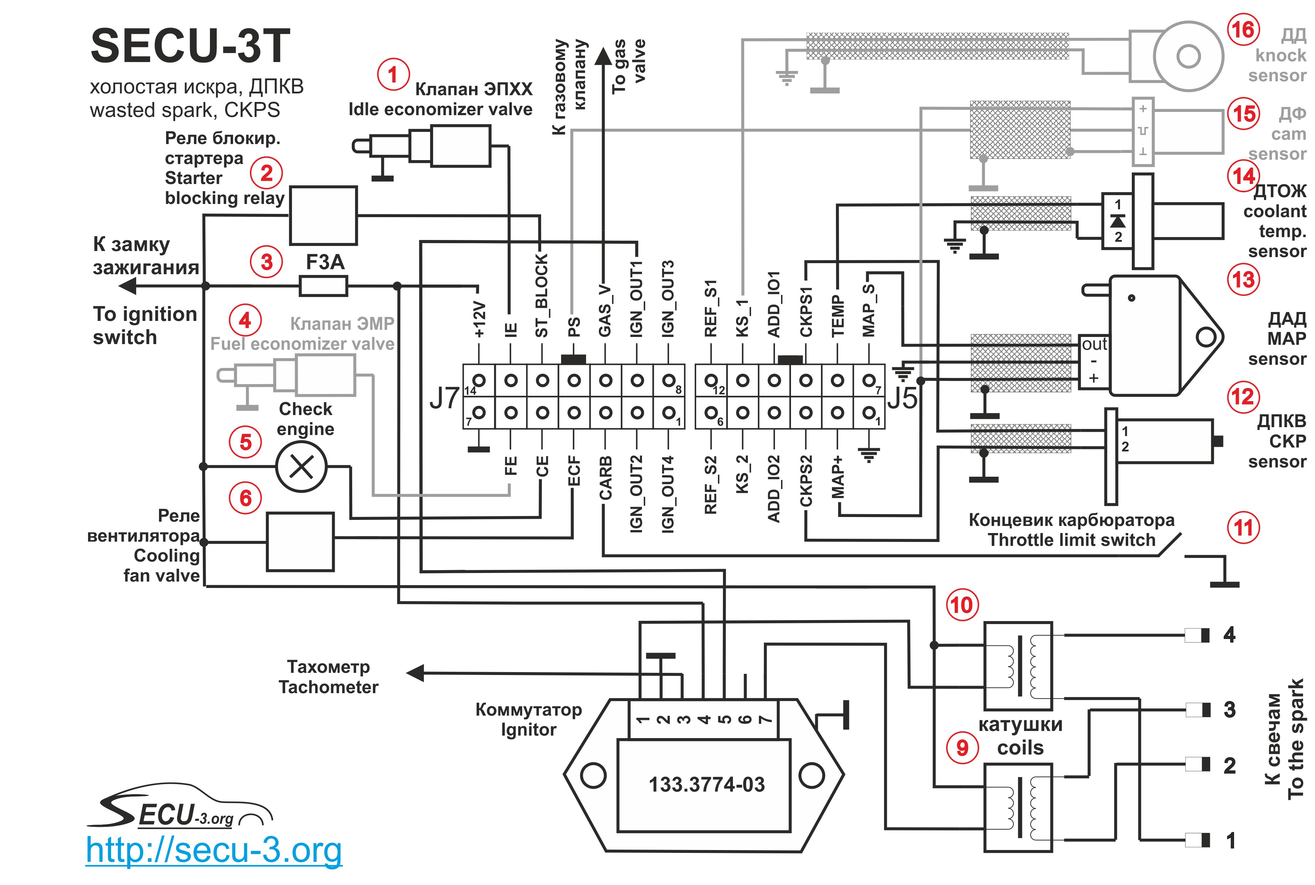
Wiring/SECU-3T_WS_CKPS_2chign_14+12.png
