ashabelnikov/secu3doc/Wiring/SECU-3T_WS_DUI_DNO.png

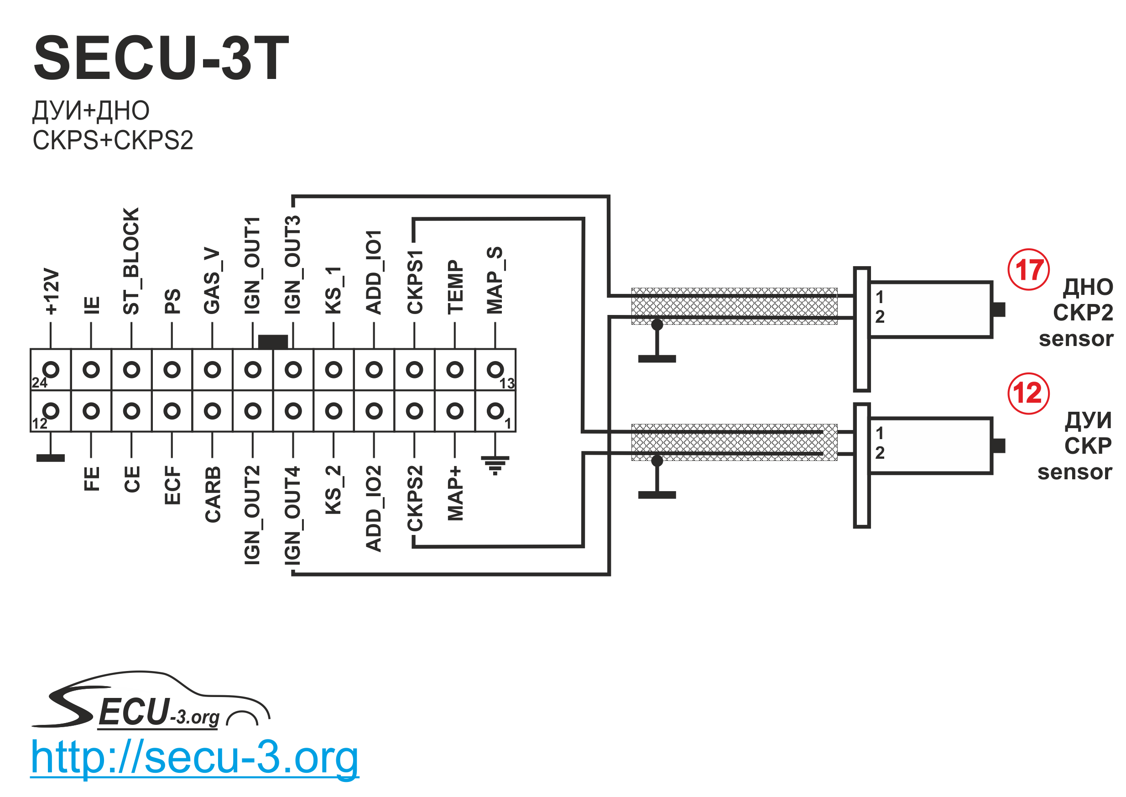
Wiring/SECU-3T_WS_DUI_DNO.png
