ashabelnikov/secu3doc/Wiring/SECU-3T_WS_DUI_DNO_14+12.png

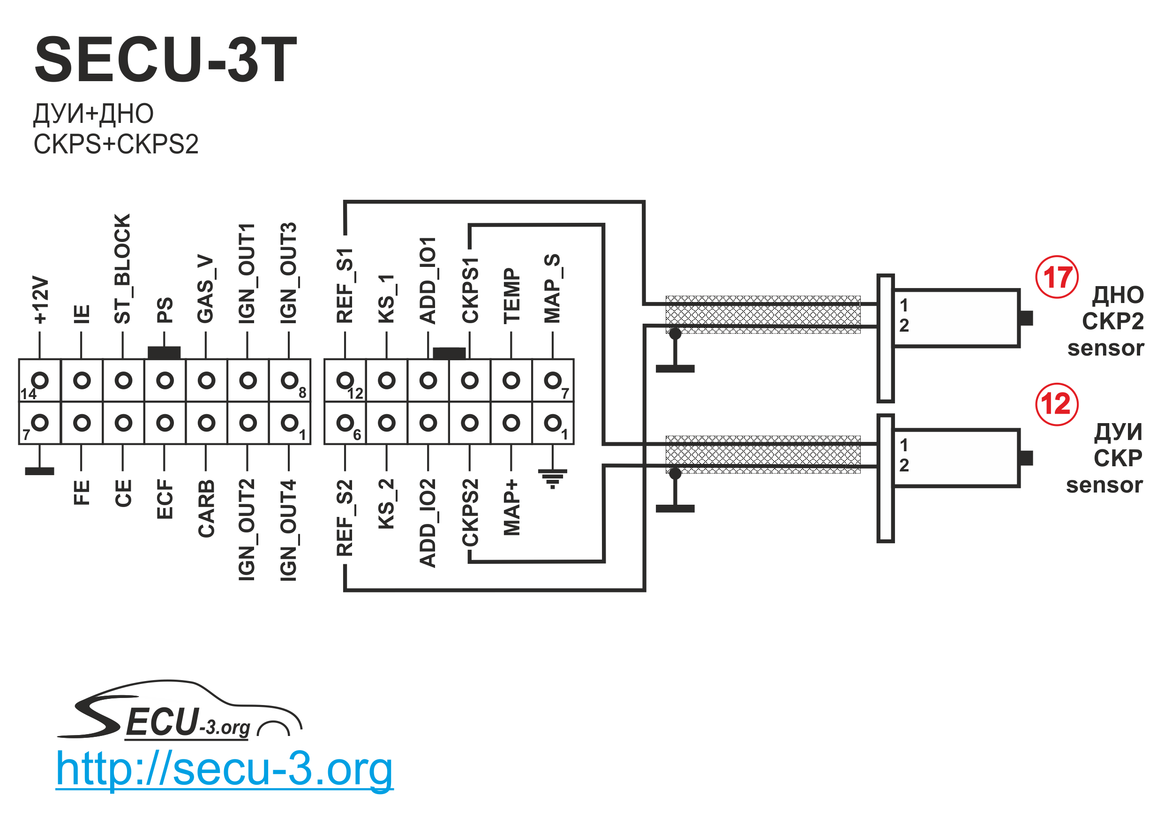
Wiring/SECU-3T_WS_DUI_DNO_14+12.png
