ashabelnikov/secu3doc/Wiring/secu-pnh-int-drv4-21121411020-40.png

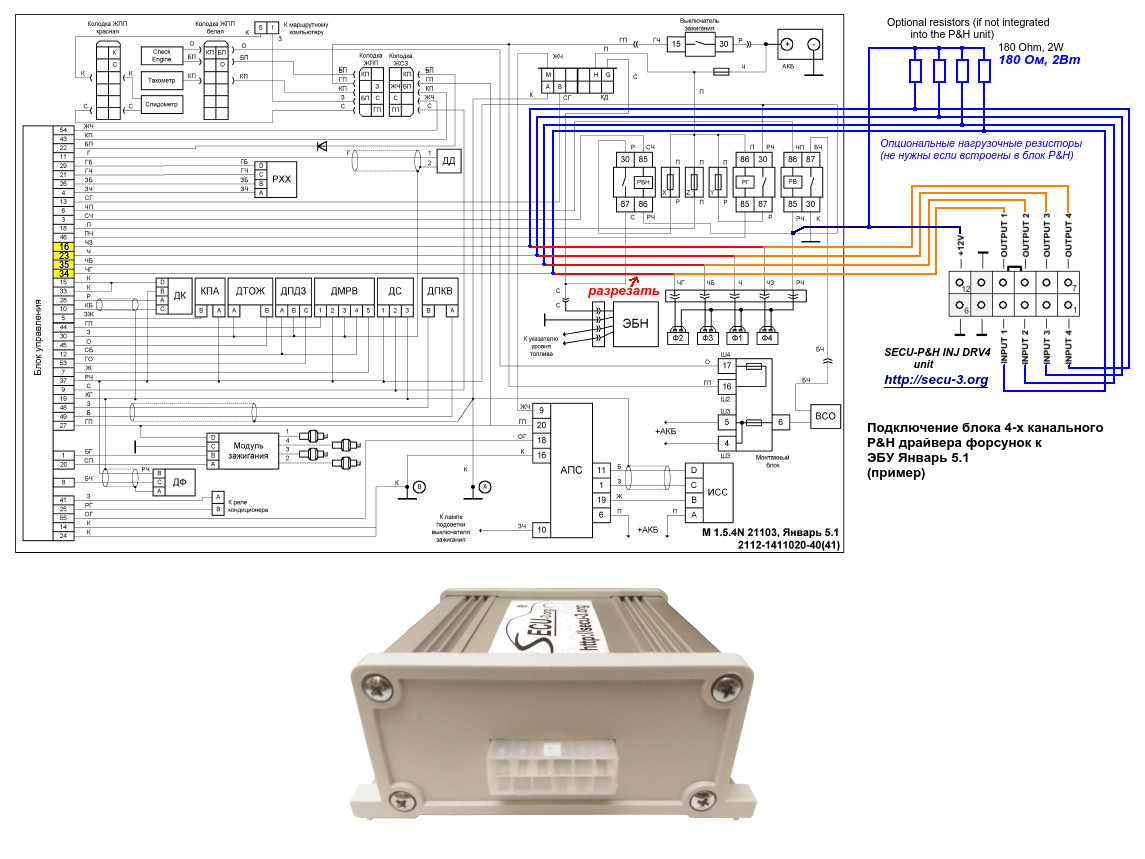
Wiring/secu-pnh-int-drv4-21121411020-40.png
