ashabelnikov/secu3doc/Wiring/ST_BLOCK.jpg

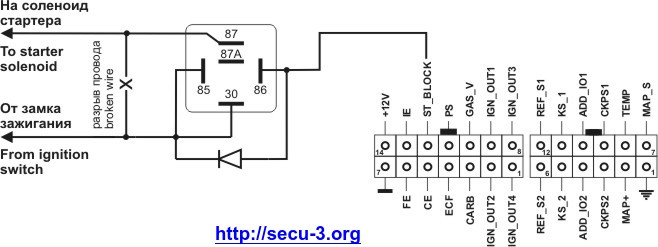
Wiring/ST_BLOCK.jpg
