ashabelnikov/secu3doc/Wiring/ST_BLOCK.png

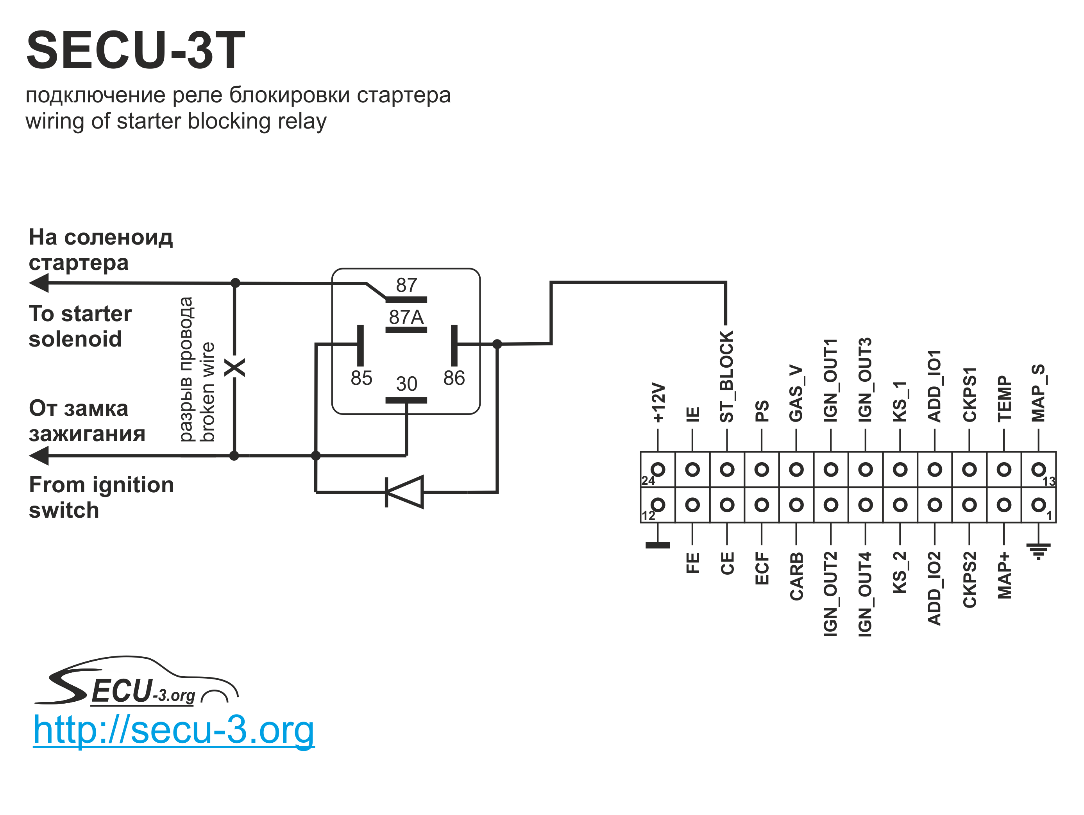
Wiring/ST_BLOCK.png
