ashabelnikov/secu3doc/Wiring/tachometer_via_diodes.gif

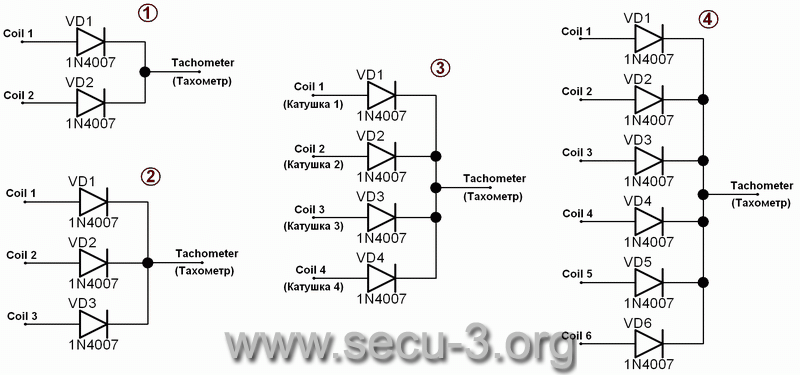
Wiring/tachometer_via_diodes.gif
