ashabelnikov/secu3doc/Wiring/Wiring_DUI_DNO_14+12.png

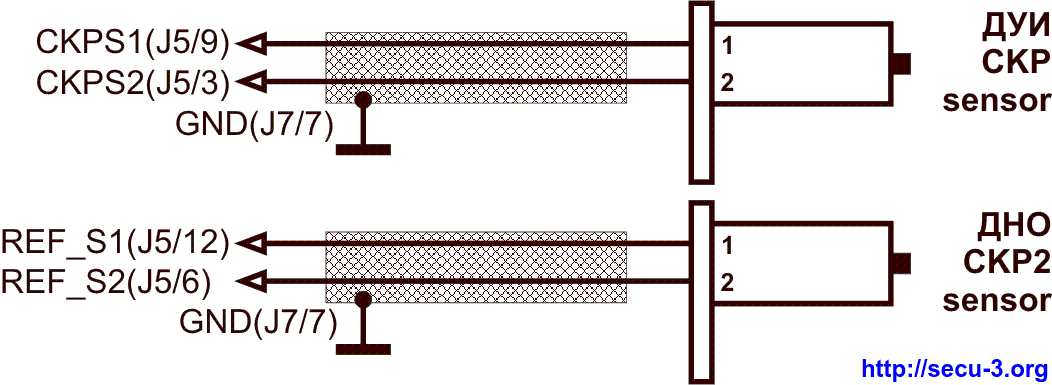
Wiring/Wiring_DUI_DNO_14+12.png
