ashabelnikov/secu3doc/Wiring/Wiring_FAN_Control_Always_Supply_PWM_14+12.png

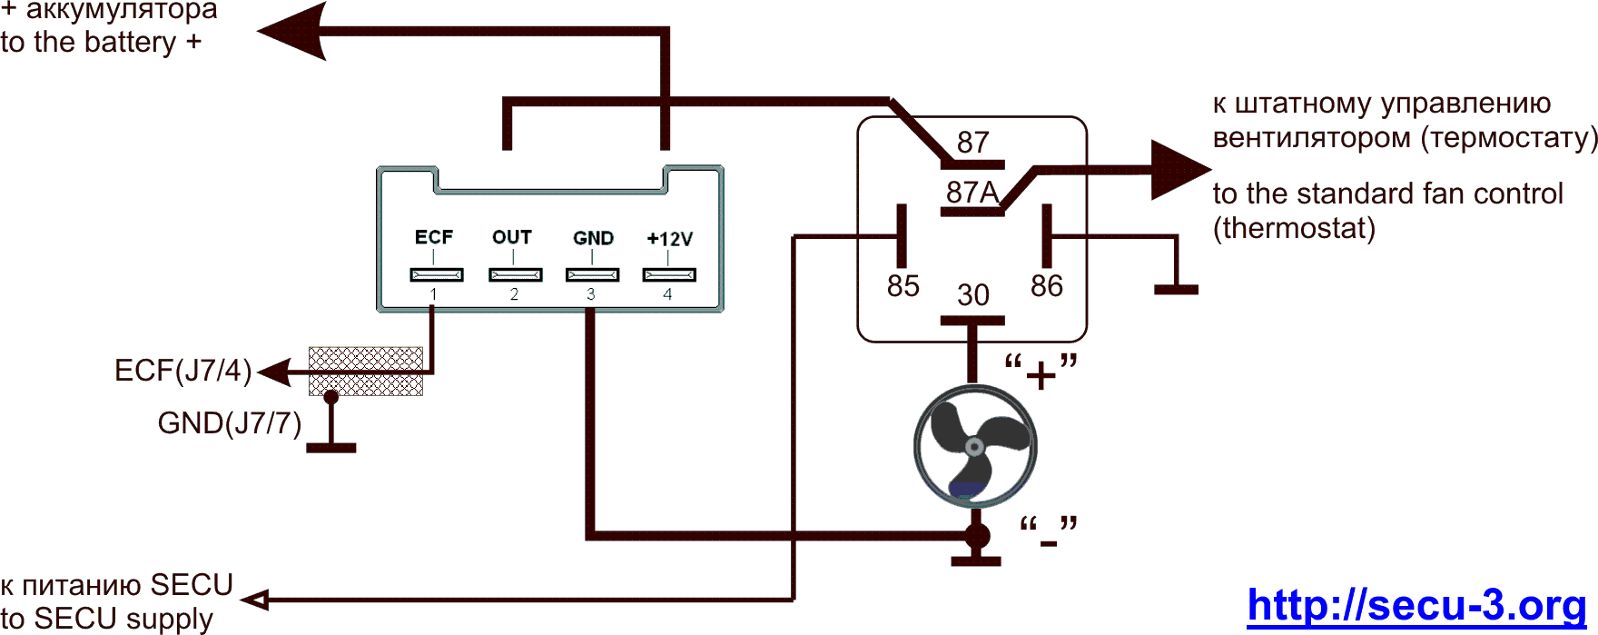
Wiring/Wiring_FAN_Control_Always_Supply_PWM_14+12.png
