ashabelnikov/secu3doc/Wiring/Wiring_FAN_Control_Supply_Relay_14+12.png

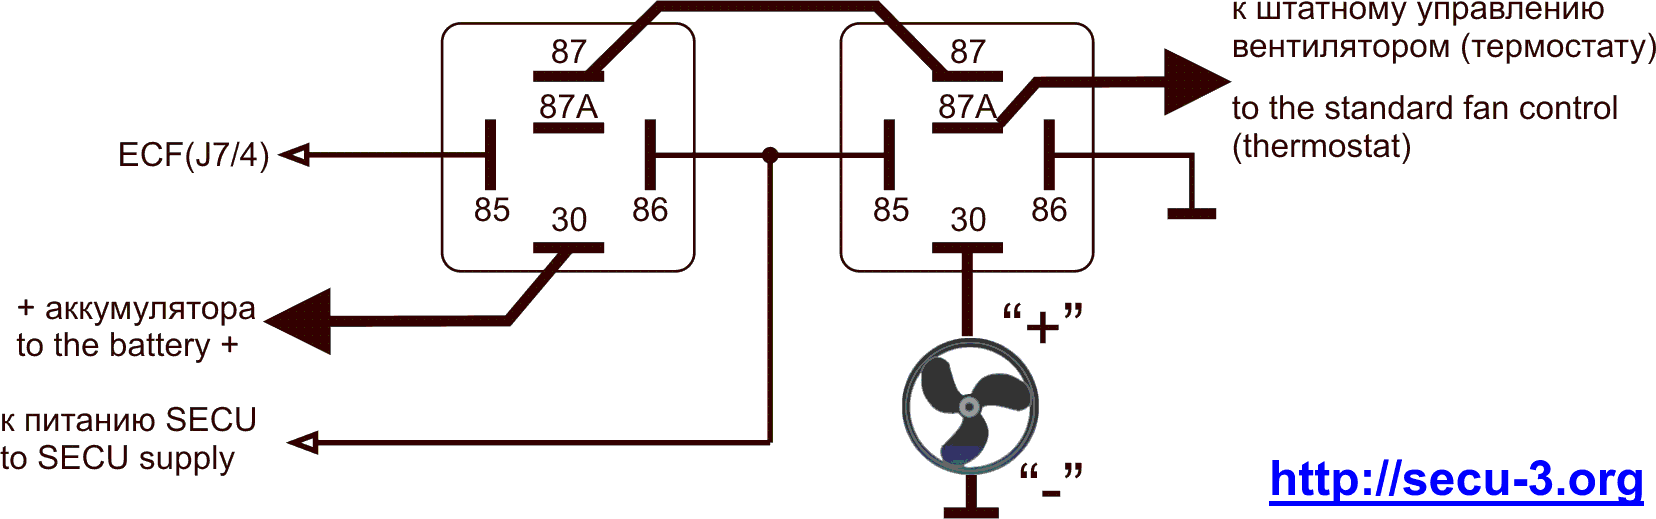
Wiring/Wiring_FAN_Control_Supply_Relay_14+12.png
