ashabelnikov/secu3doc/Wiring/Wiring_Fuel_Pump.png

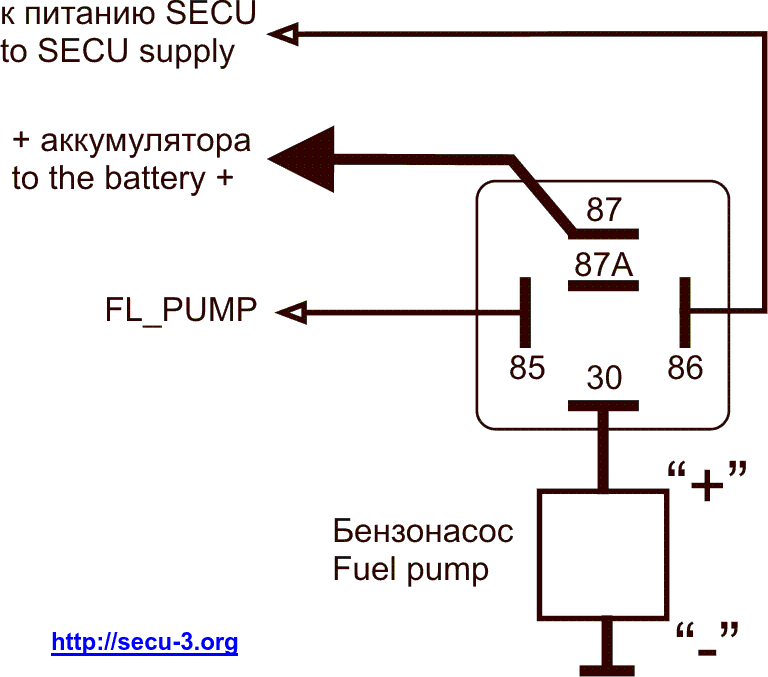
Wiring/Wiring_Fuel_Pump.png
