ashabelnikov/secu3doc/Wiring/Wiring_Hall_out_high_voltage_non_FE_IE.png

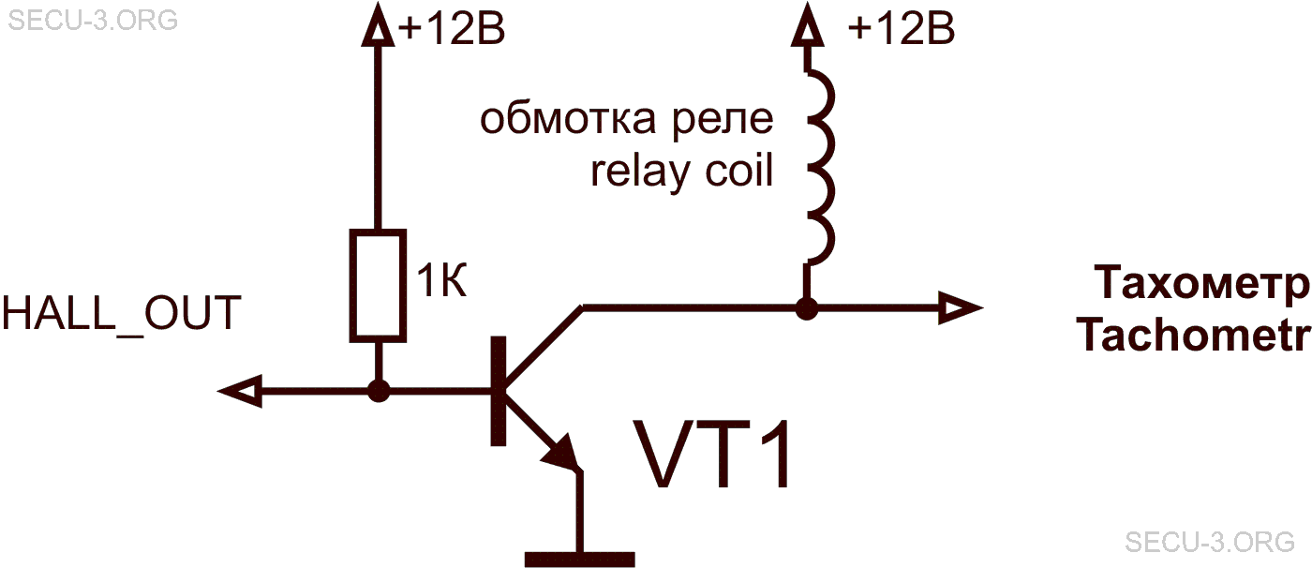
Wiring/Wiring_Hall_out_high_voltage_non_FE_IE.png
