ashabelnikov/secu3doc/Wiring/Wiring_PWR_RELAY_14+12.png

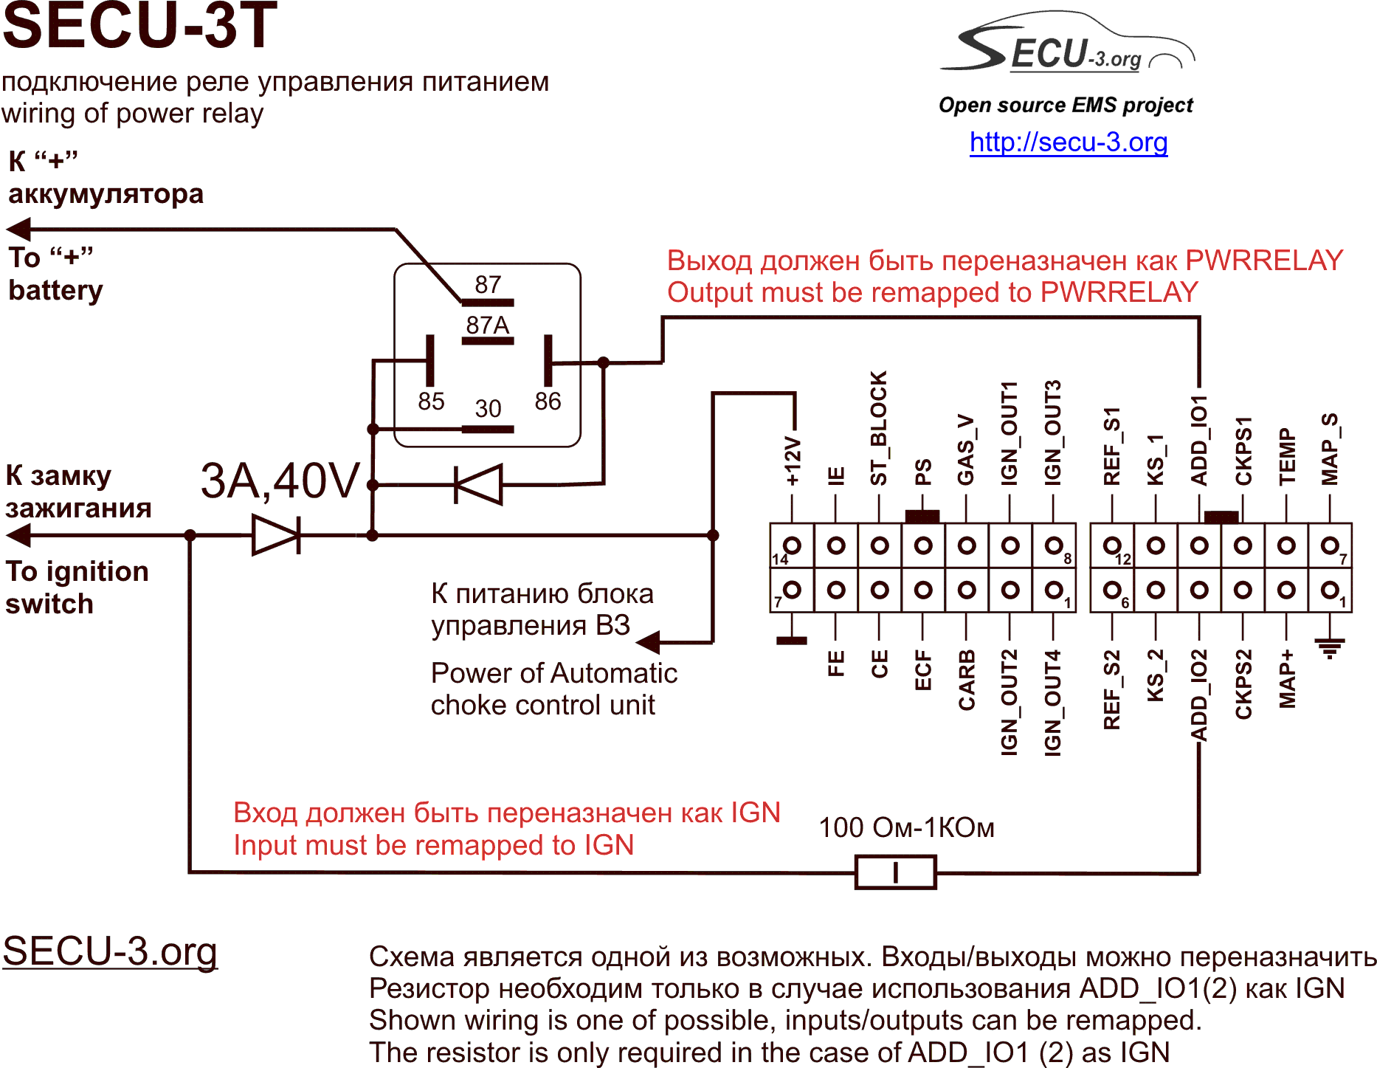
Wiring/Wiring_PWR_RELAY_14+12.png
