ashabelnikov/secu3doc/Wiring/WiringFanSpeedControlUnit.png

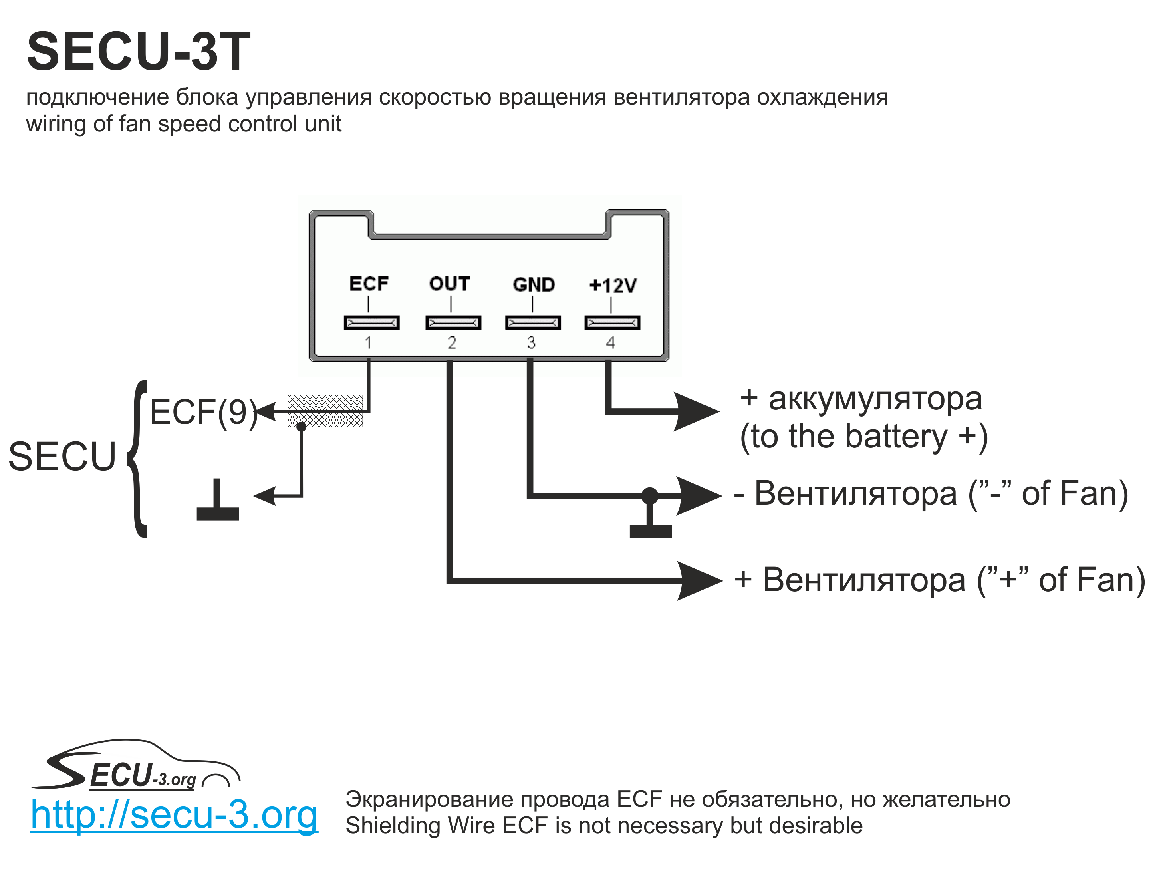
Wiring/WiringFanSpeedControlUnit.png
