ashabelnikov/secu3doc/PDF/SECU-2P&H+STEP/secu-2pnh+step-pcb-topsilk.pdf

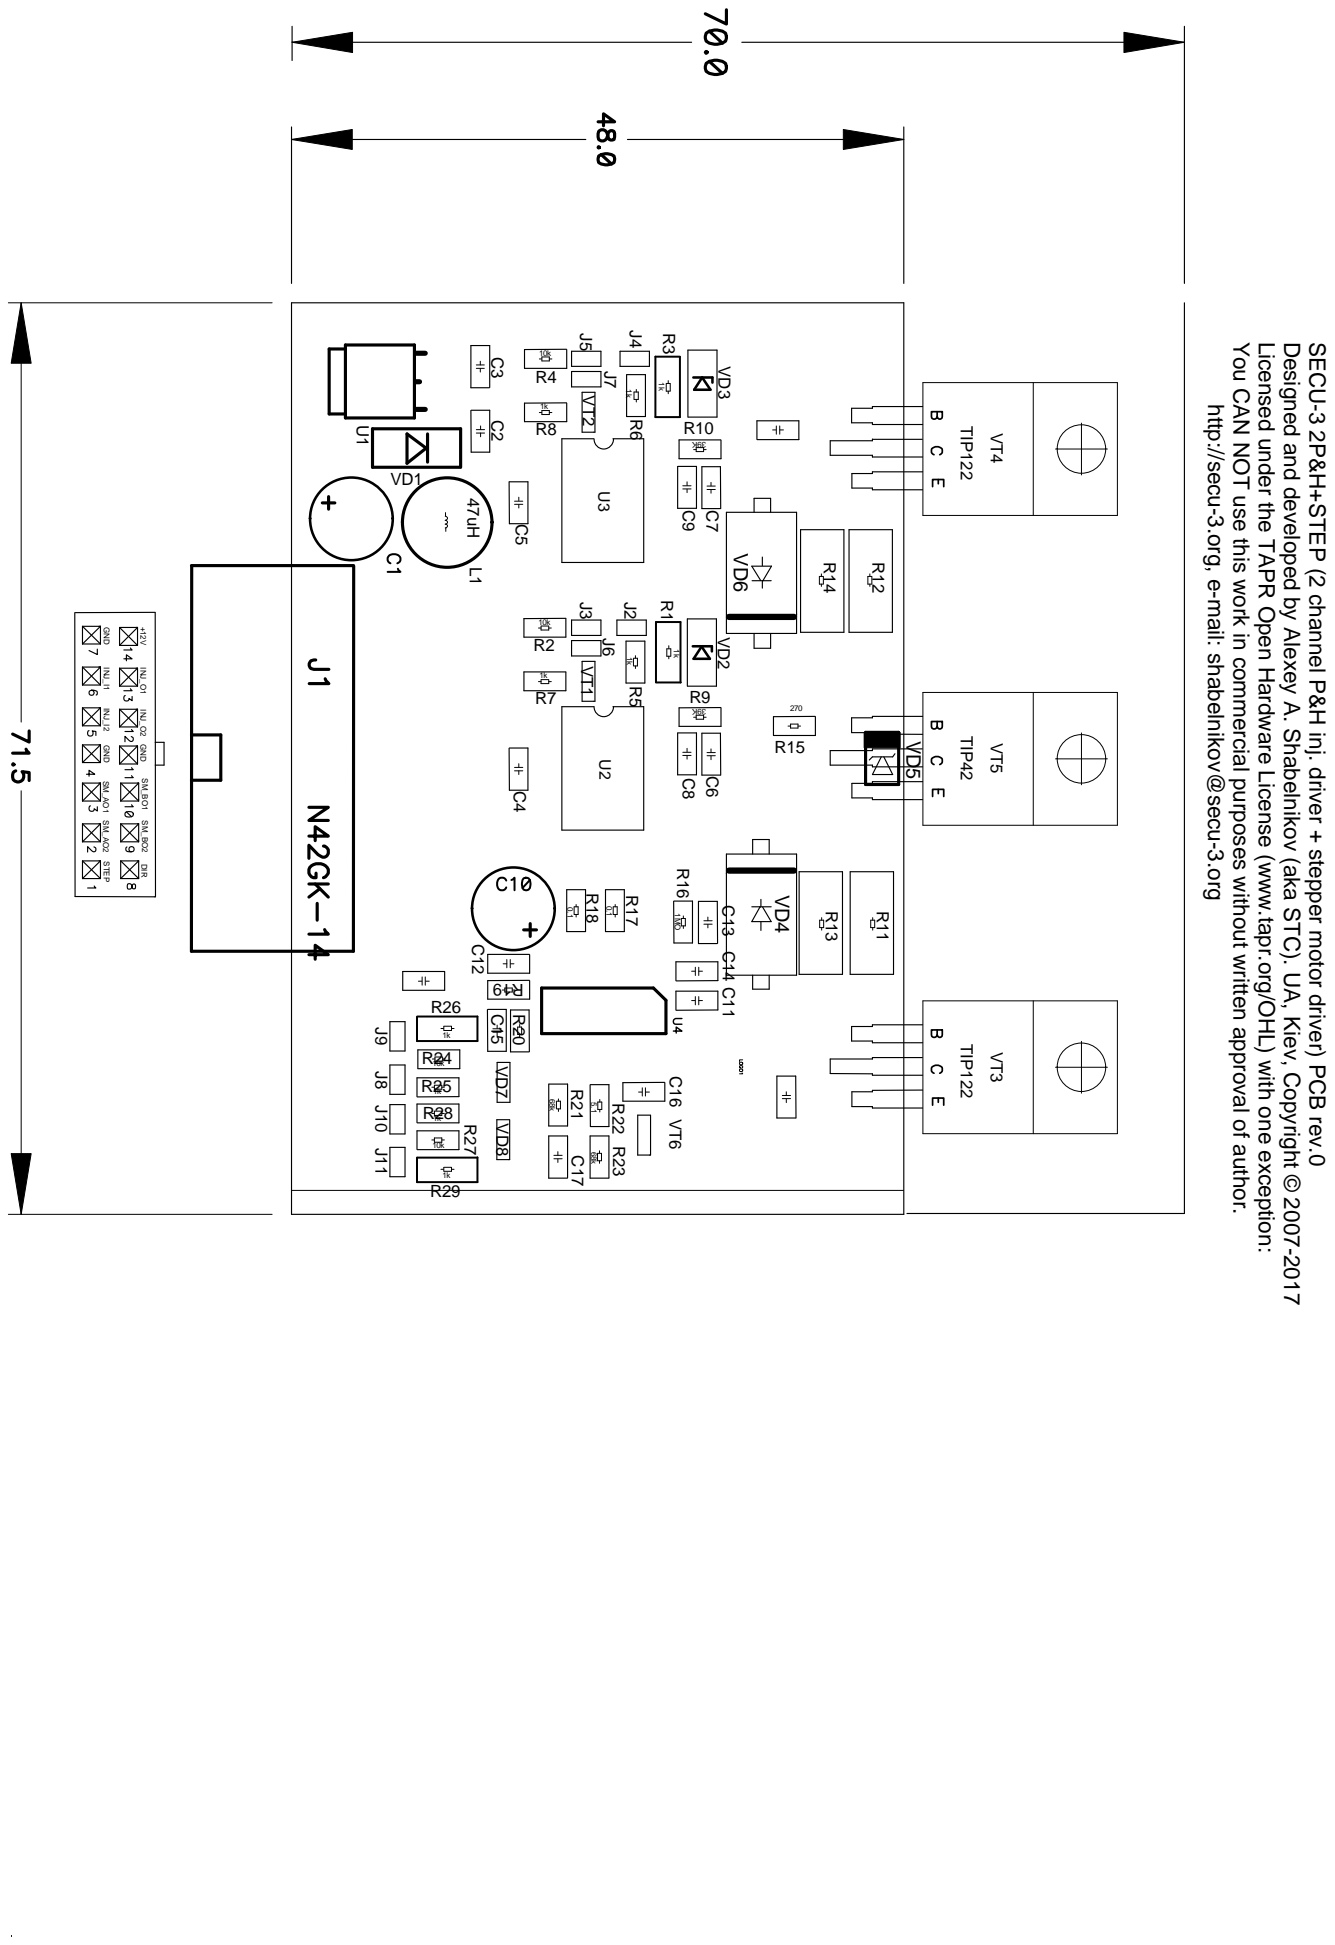
[picture p157: page 1]

You CAN NOT use this work in commercial purposes without written approval of author.

Licensed under the TAPR Open Hardware License (www.tapr.org/OHL) with one exception:

Designed and developed by Alexey A. Shabelnikov (aka STC). UA, Kiev, Copyright © 2007-2017

SECU-3 2P&H+STEP (2 channel P&H inj. driver + stepper motor driver) PCB rev.0

http://secu-3.org, e-mail: shabelnikov@secu-3.org
