ashabelnikov/secu3doc/PDF/SECU-STEP/secu3_smcu_schema.pdf

C1

10,0x35v

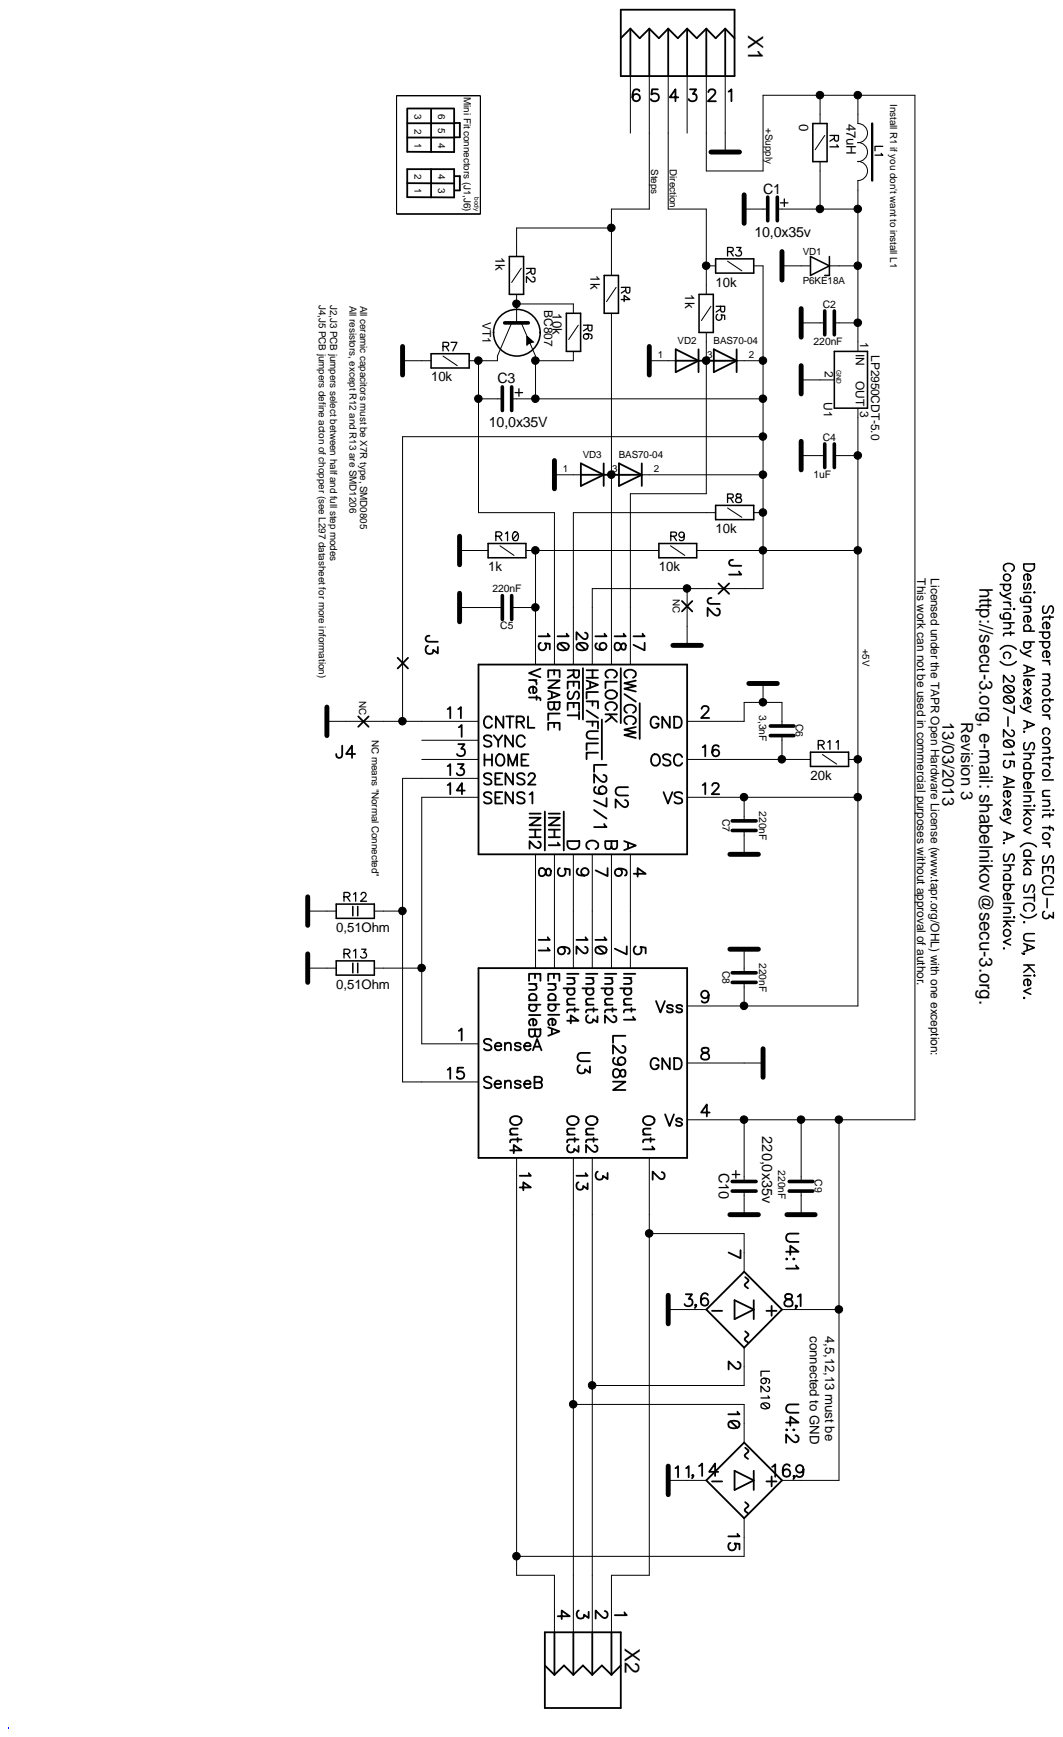
[picture p158: page 1]

Install R1 if you don't want to install L1

J4,J5 PCB jumpers define acton of chopper (see L297 datasheet for more information)

J2,J3 PCB jumpers select between half and full step modes

All resistors, except R12 and R13 are SMD1206

All ceramic capacitors must be X7R type, SMD0805

This work can not be used in commercial purposes without approval of author.

Licensed under the TAPR Open Hardware License (www.tapr.org/OHL) with one exception:

http://secu-3.org, e-mail: shabelnikov@secu-3.org.

NC means "Normal Connected"
