ashabelnikov/secu3doc/PDF/SECU-LZID/SECU-LZID5-rev4.pdf

### Revision 4

10/02/2019

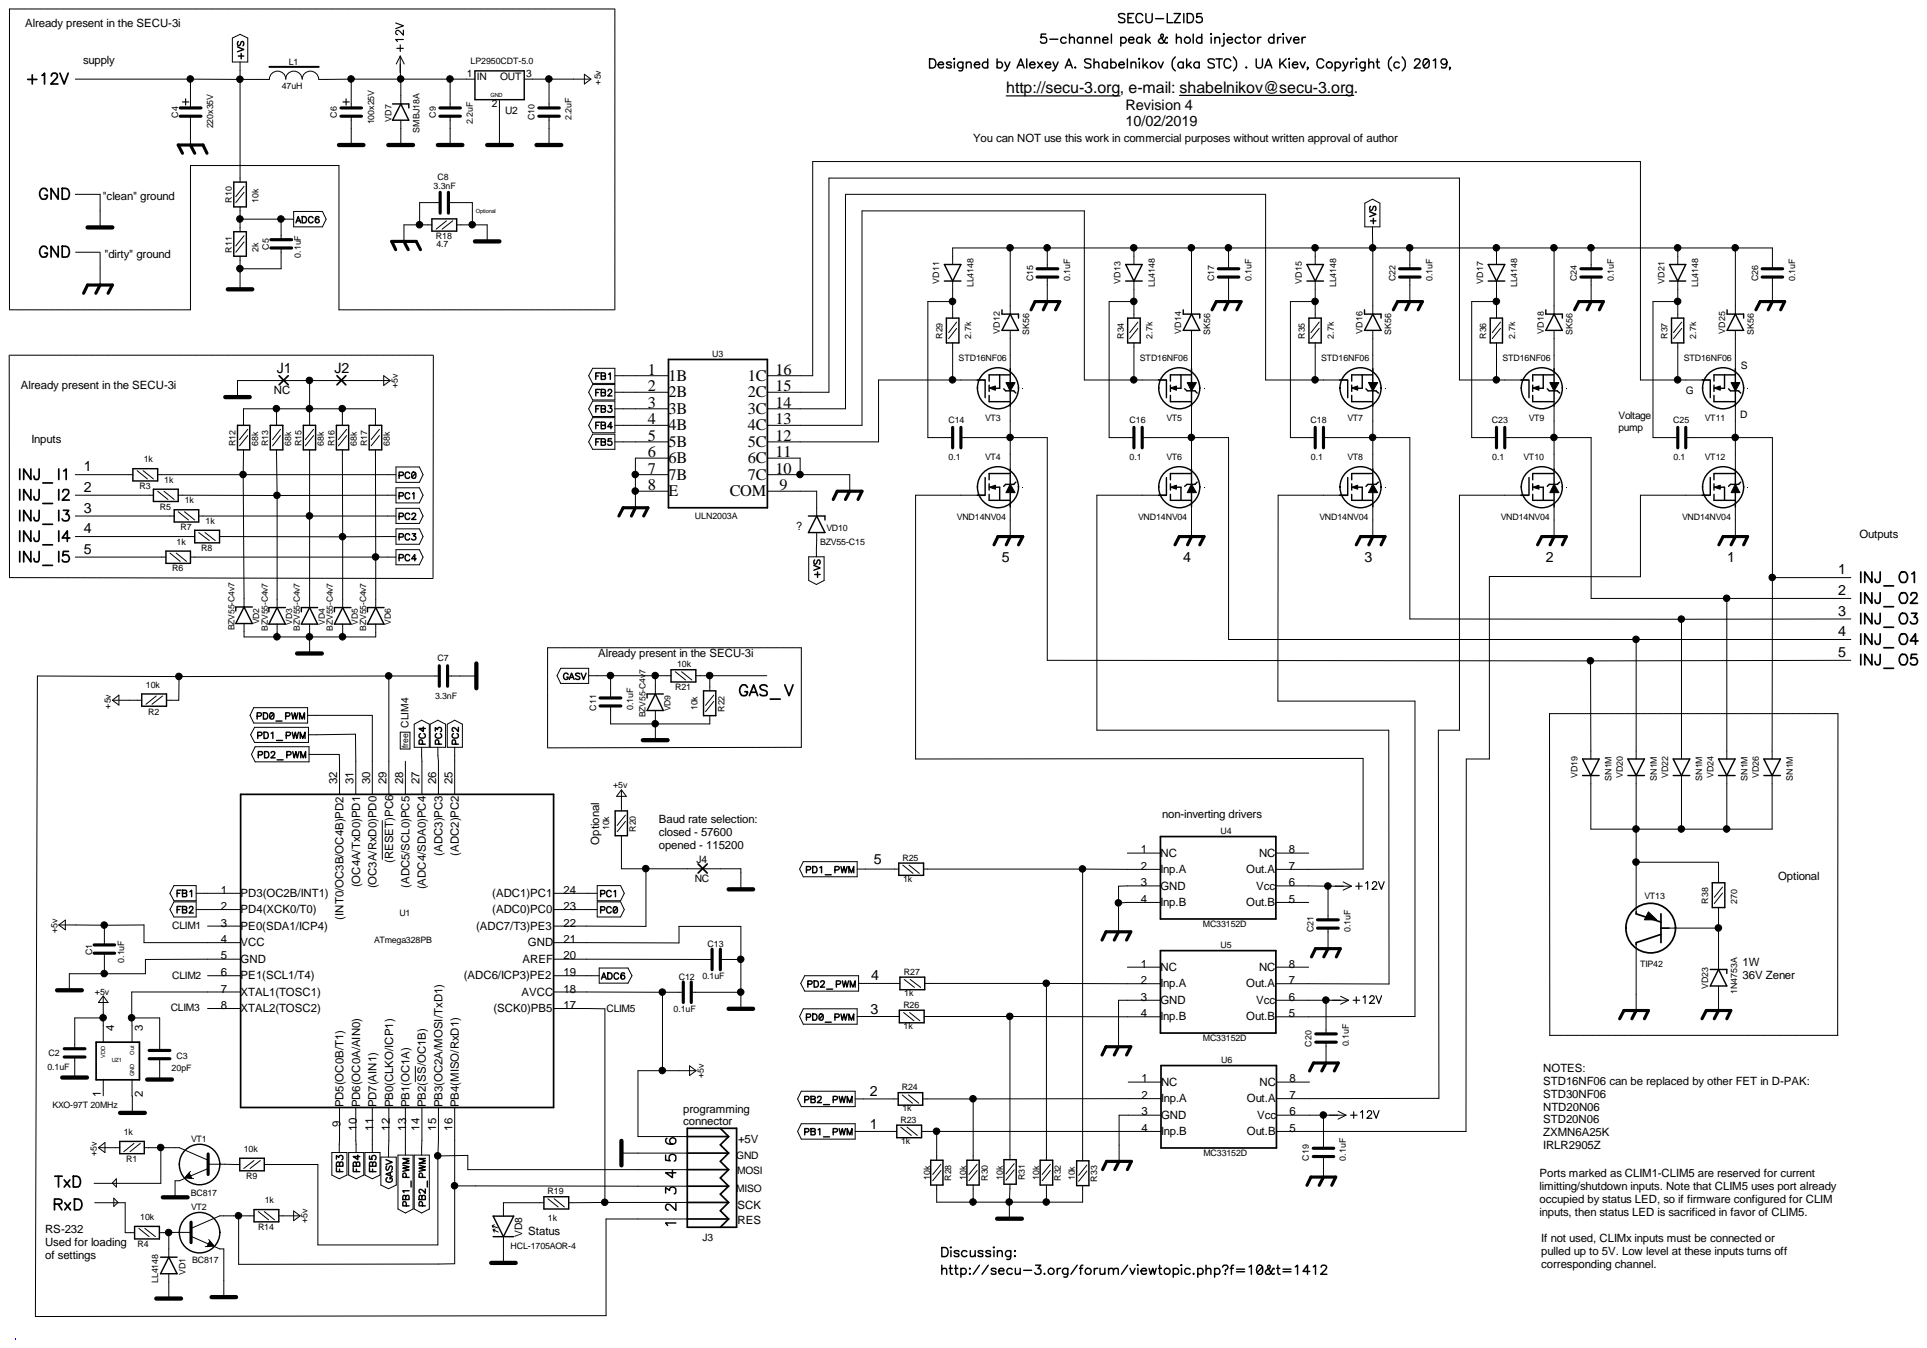
[picture p159: page 1]

Already present in the SECU-3i

http://secu-3.org, e-mail: shabelnikov@secu-3.org.

You can NOT use this work in commercial purposes without written approval of author

Ports marked as CLIM1-CLIM5 are reserved for current
limitting/shutdown inputs. Note that CLIM5 uses port already
occupied by status LED, so if firmware configured for CLIM
inputs, then status LED is sacrificed in favor of CLIM5.

If not used, CLIMx inputs must be connected or
pulled up to 5V. Low level at these inputs turns off
corresponding channel.
