ashabelnikov/secu3doc/PDF/SECU-DRV8825/secu-drv8825-rev0-pcb-topsilk.pdf

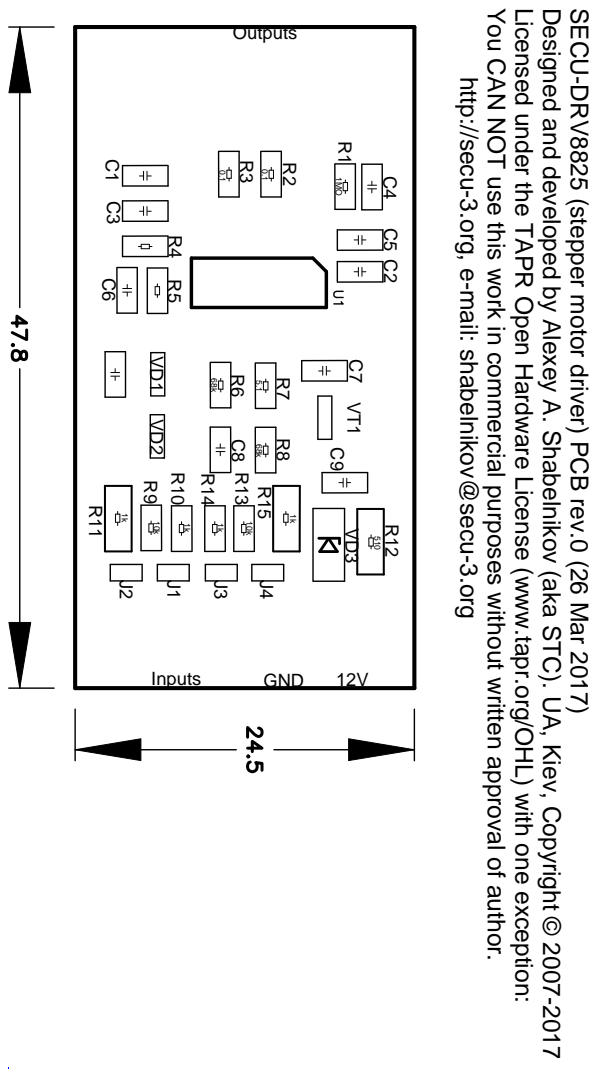
[picture p160: page 1]

You CAN NOT use this work in commercial purposes without written approval of author.

Licensed under the TAPR Open Hardware License (www.tapr.org/OHL) with one exception:

Designed and developed by Alexey A. Shabelnikov (aka STC). UA, Kiev, Copyright © 2007-2017

SECU-DRV8825 (stepper motor driver) PCB rev.0 (26 Mar 2017)

http://secu-3.org, e-mail: shabelnikov@secu-3.org Inputs GND
