ashabelnikov/secu3doc/PDF/SECU-3i/secu3i-BB-rev0-pcb-topsilk.pdf

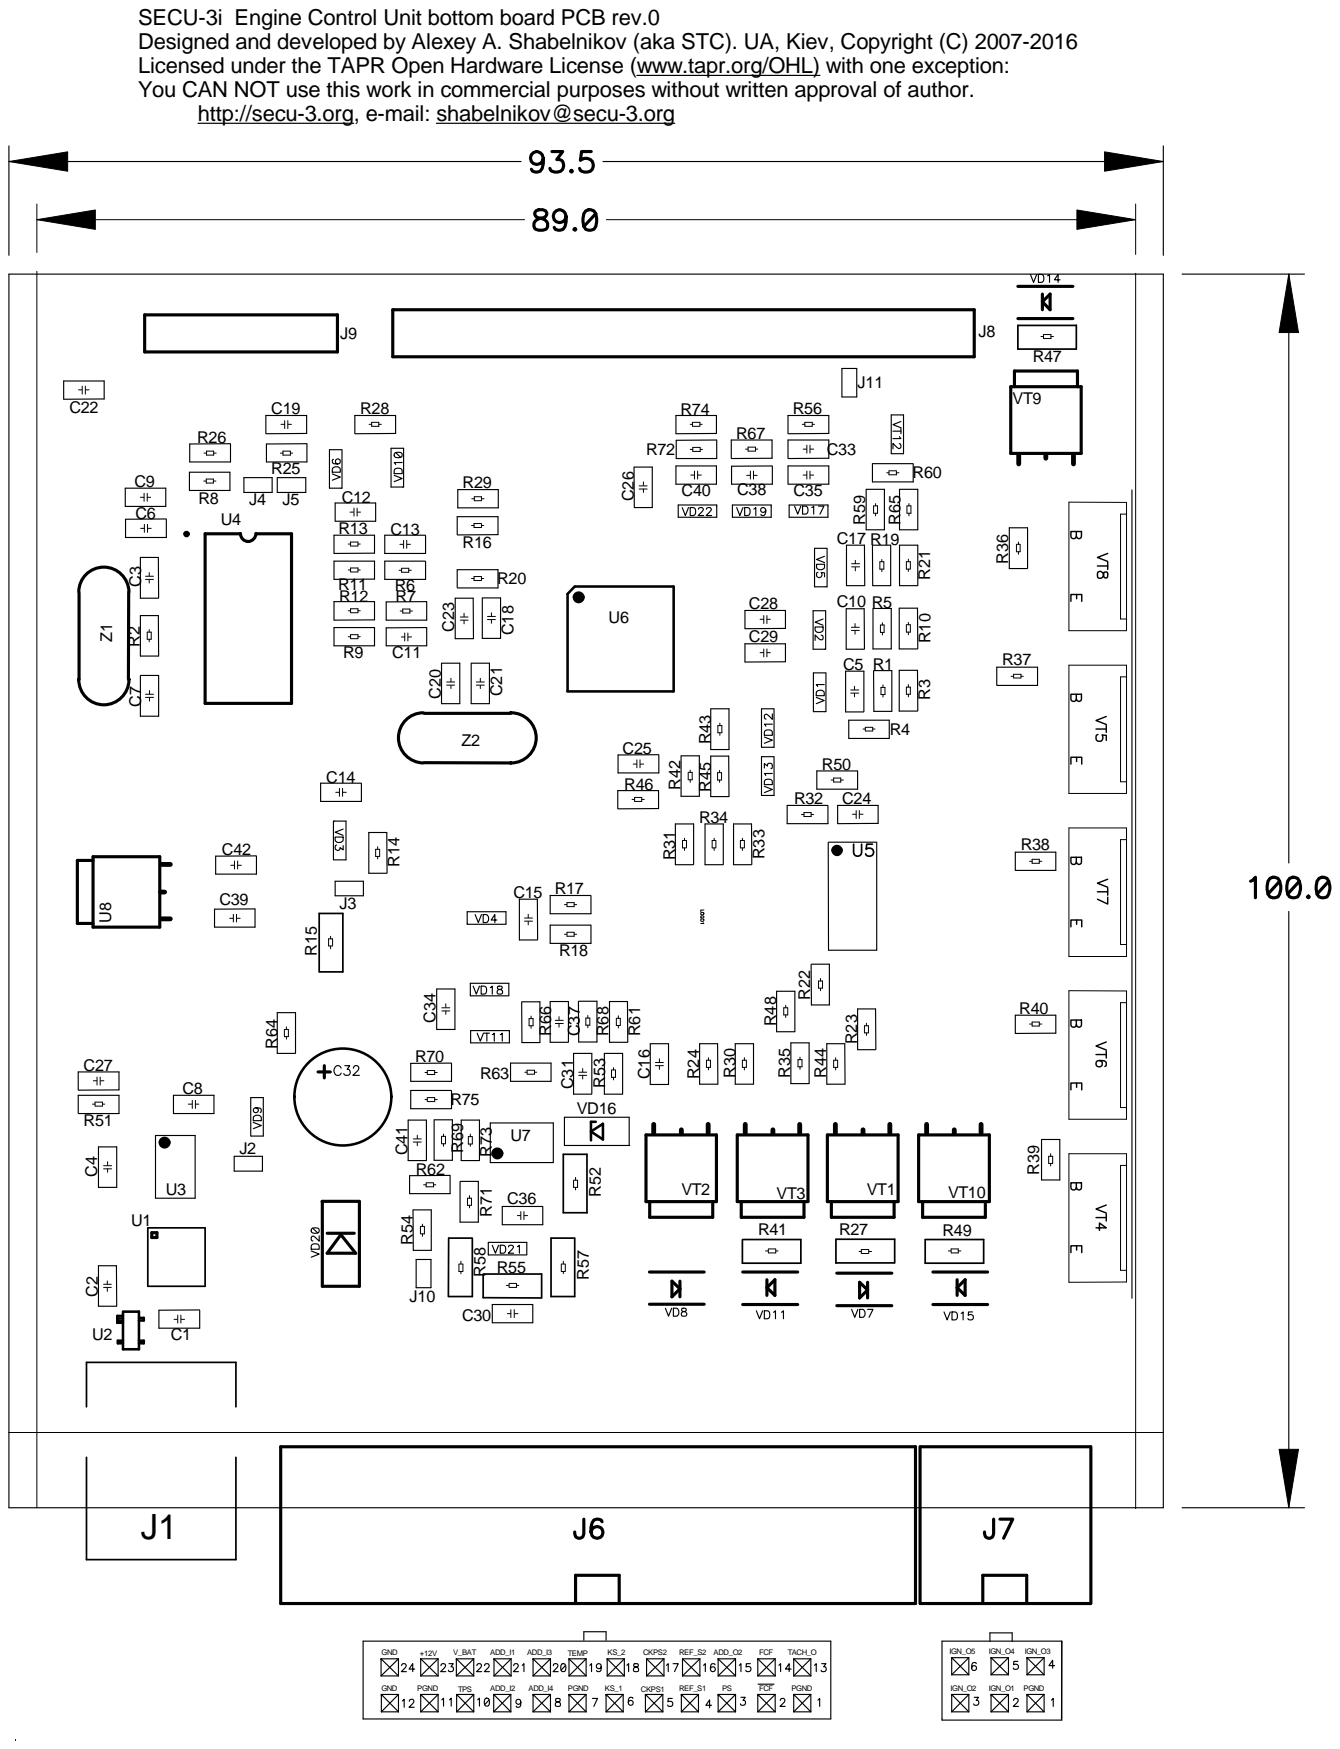
[picture p161: page 1]

SECU-3i Engine Control Unit bottom board PCB rev.0
Designed and developed by Alexey A. Shabelnikov (aka STC). UA, Kiev, Copyright (C) 2007-2016
Licensed under the TAPR Open Hardware License (www.tapr.org/OHL) with one exception:
You CAN NOT use this work in commercial purposes without written approval of author.
http://secu-3.org, e-mail: shabelnikov@secu-3.org C⁷
