ashabelnikov/secu3doc/PDF/SECU-3i/secu3i-BB-rev0-sch.pdf

Vbus | 1
D- | 2

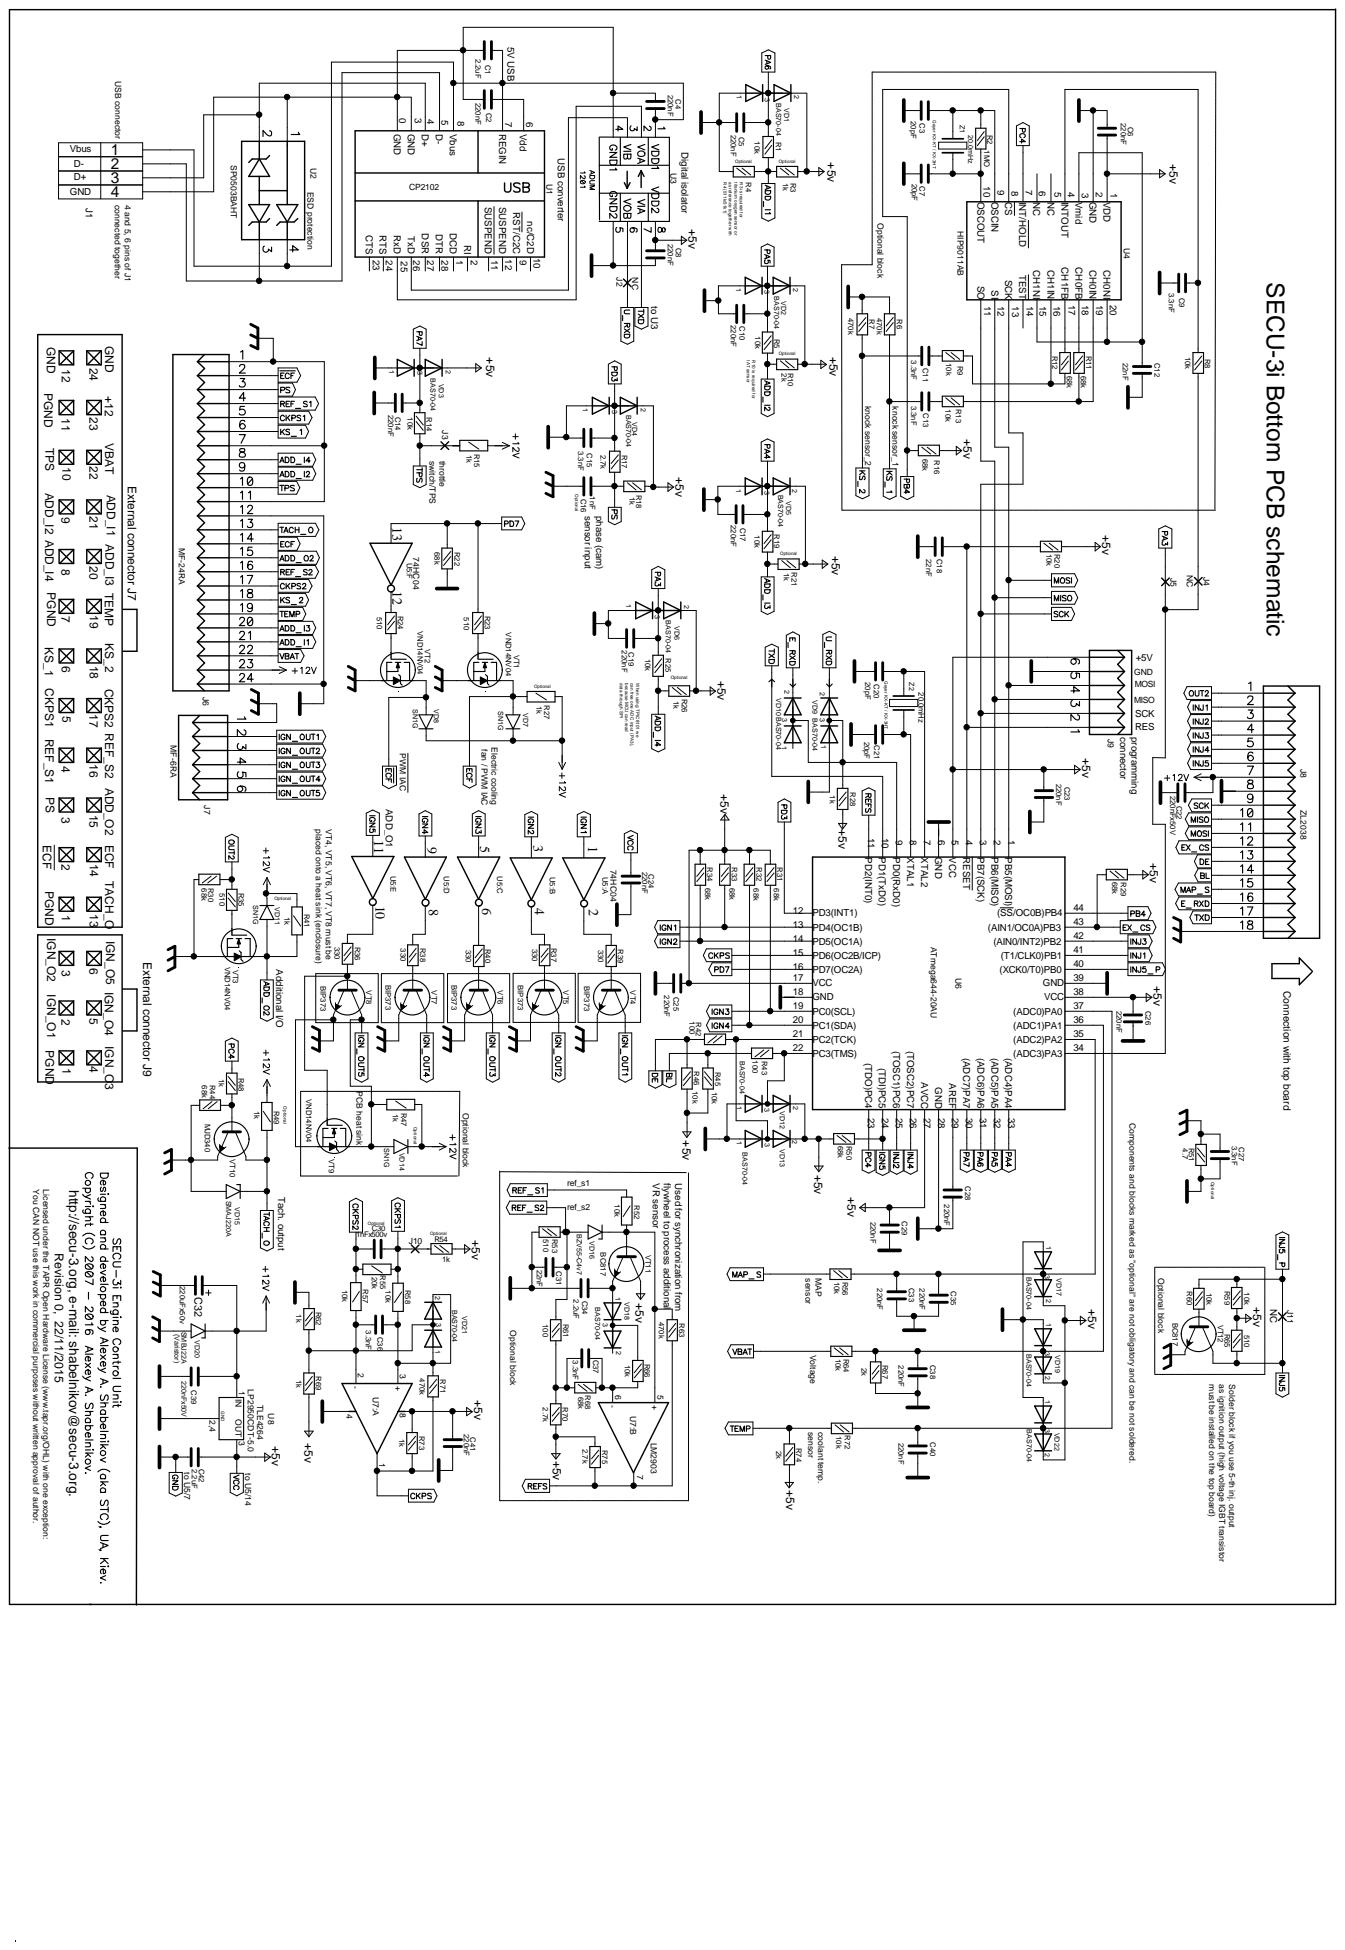
[picture p162: page 1]

Geyer KX-KT / KX-3HT

as reference together with

titanium oxygen sensor or

because MCU can read

can free one ADC input (PA3),

placed onto a heat sink (enclosure)

Connection with top board

Components and blocks marked as "optional" are not obligatory and can be not soldered.

You CAN NOT use this work in commercial purposes without written approval of author.

Licensed under the TAPR Open Hardware License (www.tapr.org/OHL) with one exception:

http://secu-3.org, e-mail: shabelnikov@secu-3.org.

flywheel to process additional

Used for synchronization from

must be installed on the top board)

as ignition output (high voltage IGBT transistor

Solder block if you use 5-th inj. output
