ashabelnikov/secu3doc/PDF/SECU-3i/secu3i-TB-rev0-sch.pdf

16

19

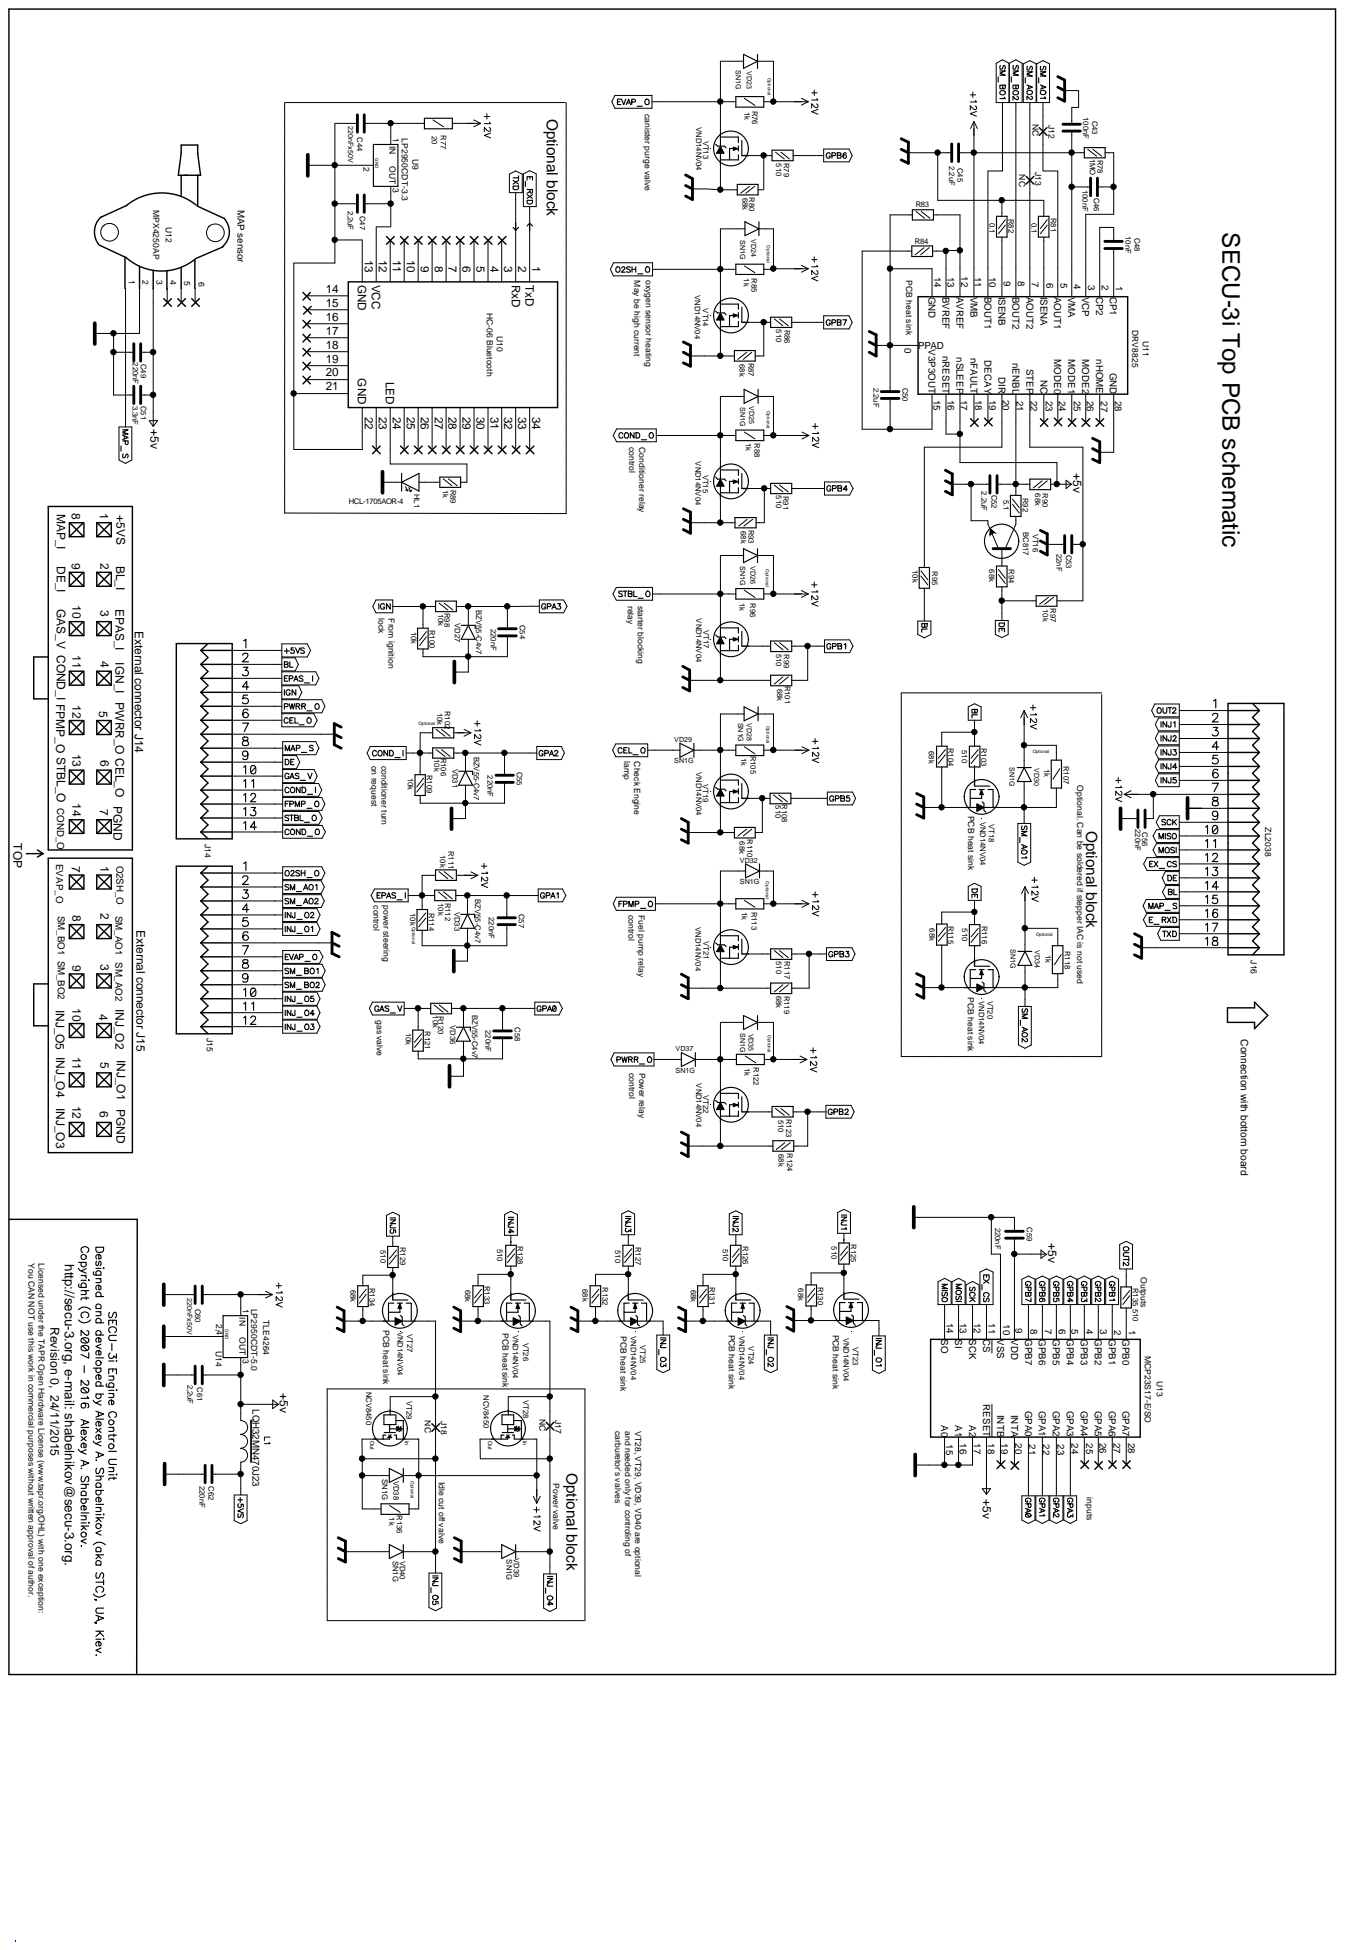
[picture p163: page 1]

SECU-3i Top PCB schematic

May be high current

Optional. Can be soldered if stepper IAC is not used

Connection with bottom board

You CAN NOT use this work in commercial purposes without written approval of author.

Licensed under the TAPR Open Hardware License (www.tapr.org/OHL) with one exception:

http://secu-3.org, e-mail: shabelnikov@secu-3.org.

and needed only for controling of

Idle cut off valve
