ashabelnikov/secu3doc/PDF/SECU-3/secu3_pcb_bottom.pdf

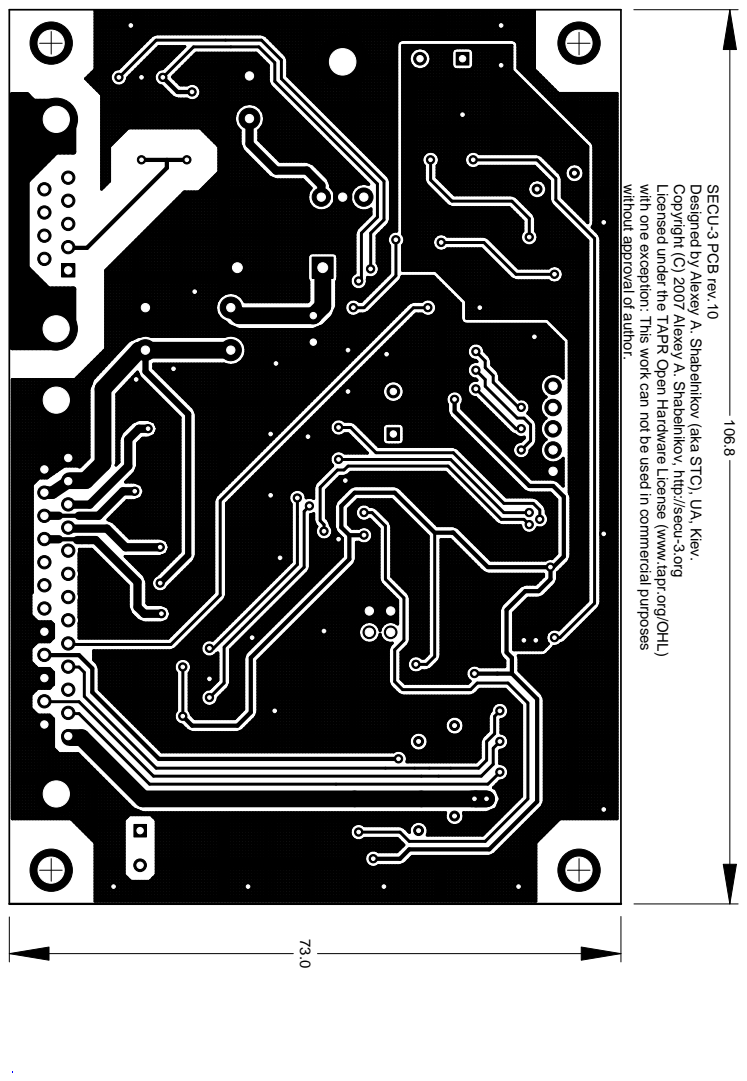
[picture p164: page 1]

without approval of author.

with one exception: This work can not be used in commercial purposes

Licensed under the TAPR Open Hardware License (www.tapr.org/OHL)

Copyright (C) 2007 Alexey A. Shabelnikov, http://secu-3.org

Designed by Alexey A. Shabelnikov (aka STC), UA, Kiev.

SECU-3 PCB rev.10
