ashabelnikov/secu3doc/PDF/SECU-3/secu3_schema.pdf

+5v

### DB9F

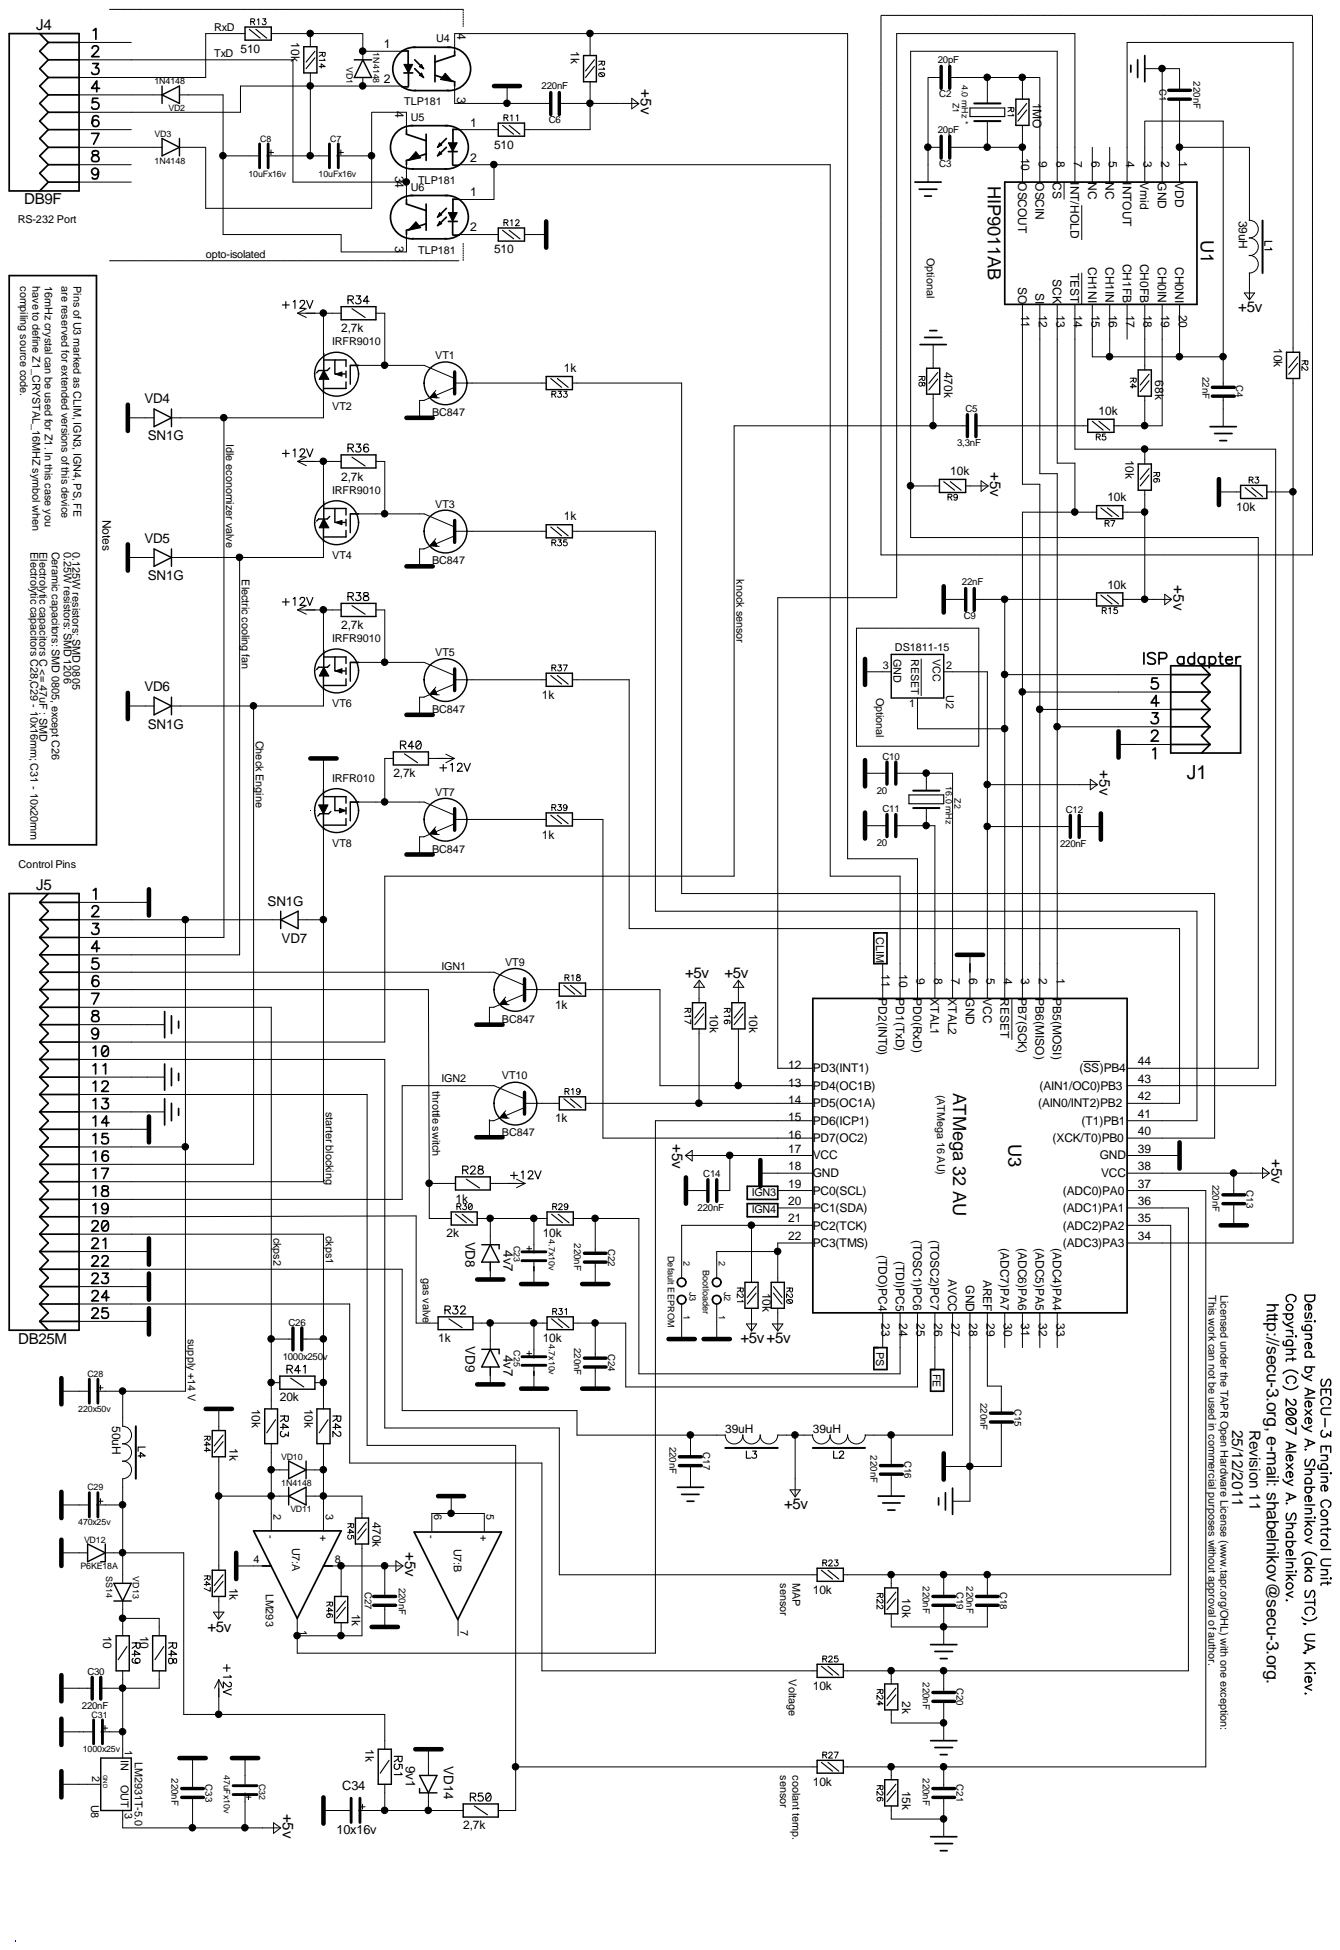
[picture p165: page 1]

have to define Z1_CRYSTAL_16MHZ symbol when

16mHz crystal can be used for Z1. In this case you

are reserved for extended versions of this device

Pins of U3 marked as CLIM, IGN3, IGN4, PS, FE

Electrolytic capacitors C <= 47uF : SMD Electrolytic capacitors C28,C29 - 10x16mm; C31 - 10x20mm

Ceramic capacitors: SMD 0805, except C26

43 (AIN1/OC0)PB3
42 (AIN0/INT2)PB2

This work can not be used in commercial purposes without approval of author.

Licensed under the TAPR Open Hardware License (www.tapr.org/OHL) with one exception:

http://secu-3.org, e-mail: shabelnikov@secu-3.org.
