ashabelnikov/secu3doc/PDF/SECU-3L/secu3l_schema_usb.pdf

Vbus | 1
| 2

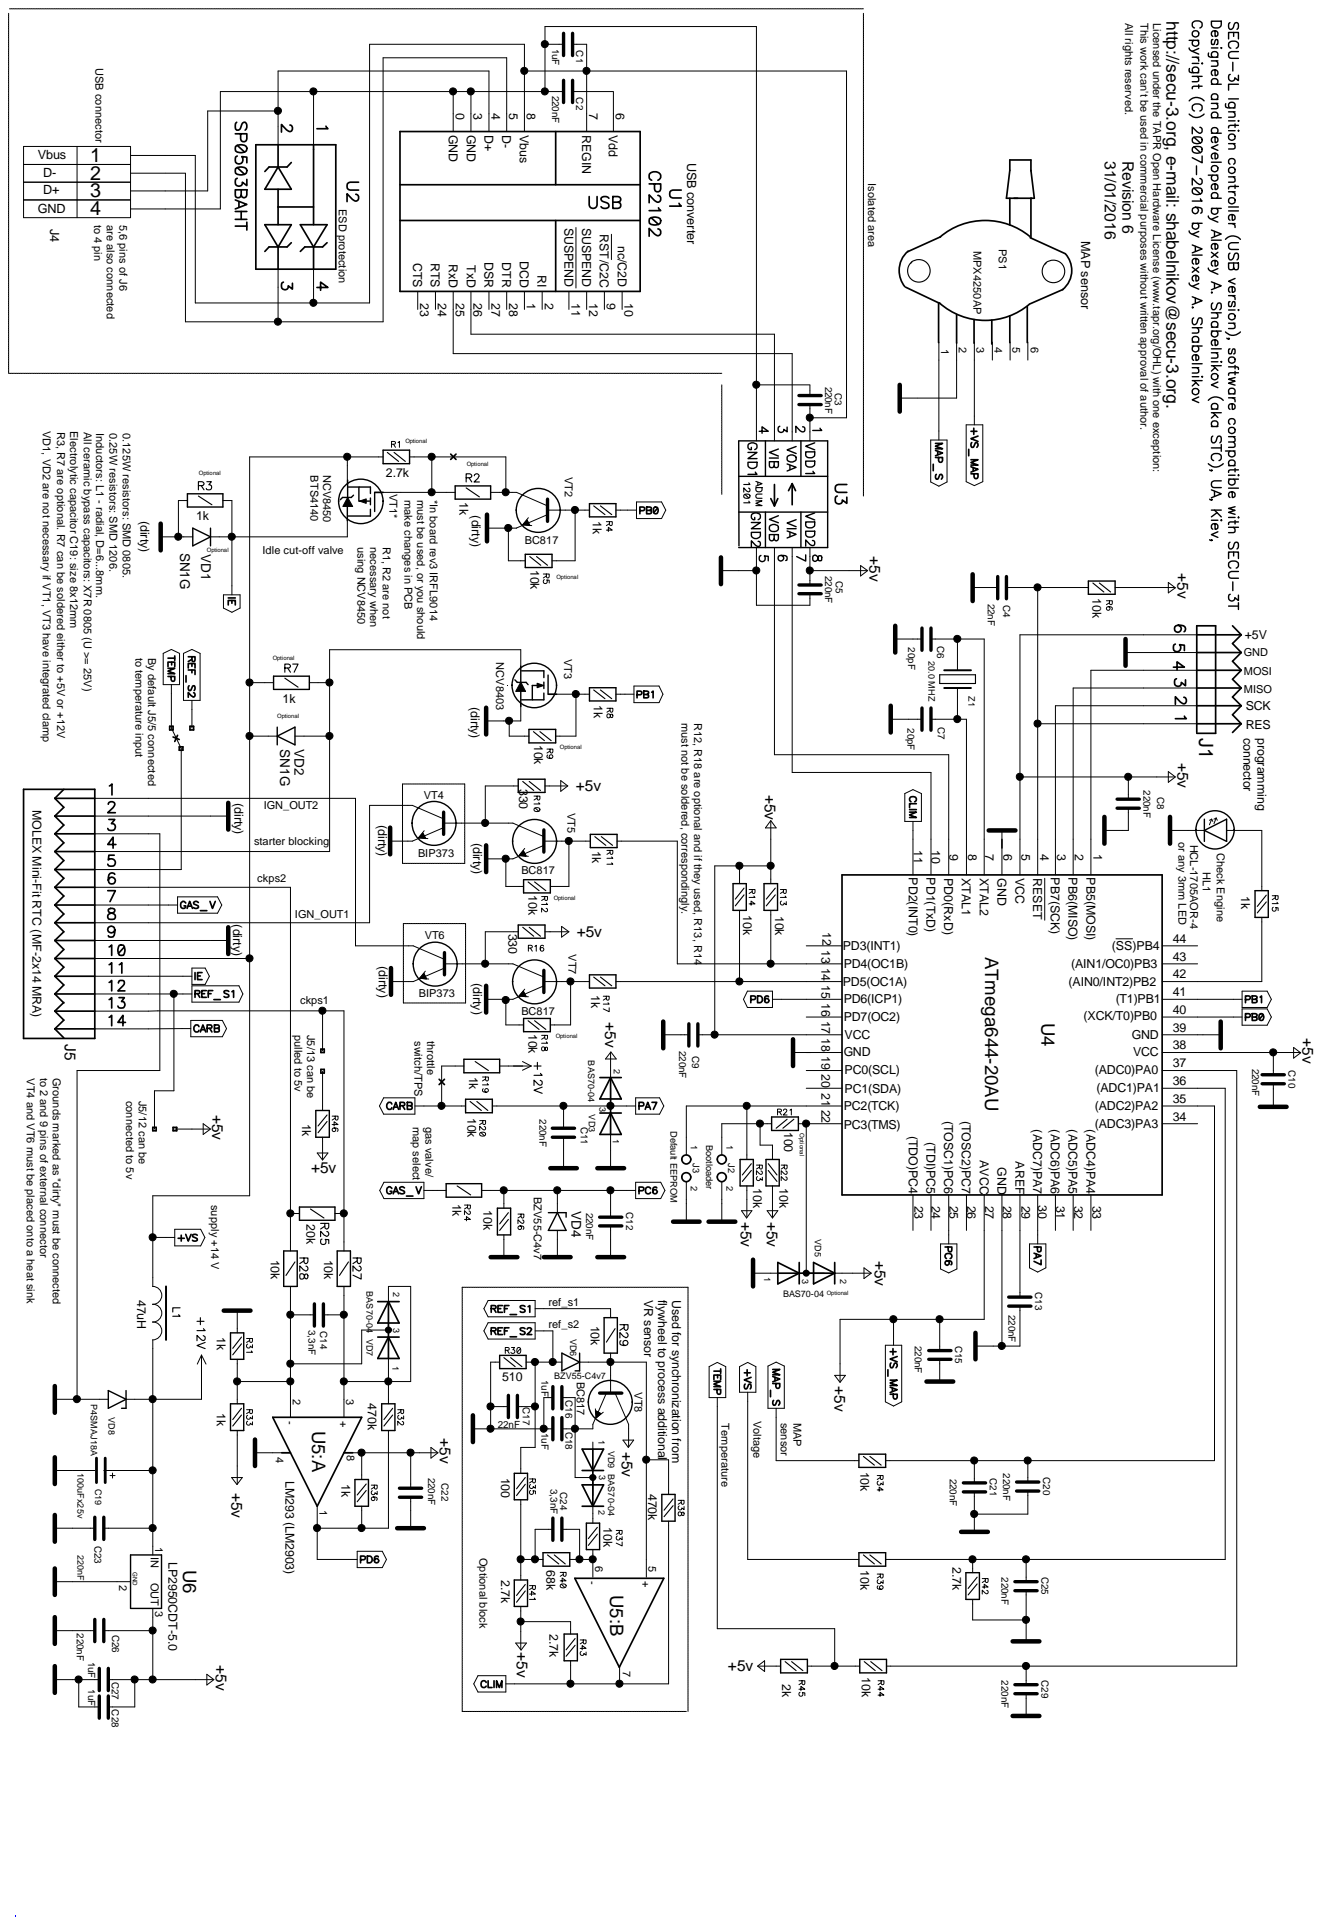
[picture p166: page 1]

This work can't be used in commercial purposes without written approval of author.

Licensed under the TAPR Open Hardware License (www.tapr.org/OHL) with one exception:

http://secu-3.org, e-mail: shabelnikov@secu-3.org.

GND | 4

VD1, VD2 are not necessary if VT1, VT3 have integrated clamp

R3, R7 are optional. R7 can be soldered either to +5V or +12V

All ceramic bypass capacitors: X7R 0805 (U >= 25V)

make changes in PCB

must be used, or you should

Idle cut-off valve

must not be soldered, correspondingly.

R12, R18 are optional and if they used, R13, R14

IGN_OUT2 starter blocking

MOLEX Mini-Fit RTC (MF-2x14 MRA)

ckps2

VT4 and VT6 must be placed onto a heat sink

to 2 and 9 pins of external connector

Grounds marked as "dirty" must be connected

flywheel to process additional

Used for synchronization from
