ashabelnikov/secu3doc/PDF/SECU-3M/secu-3-micro-pcb-topsilk.pdf

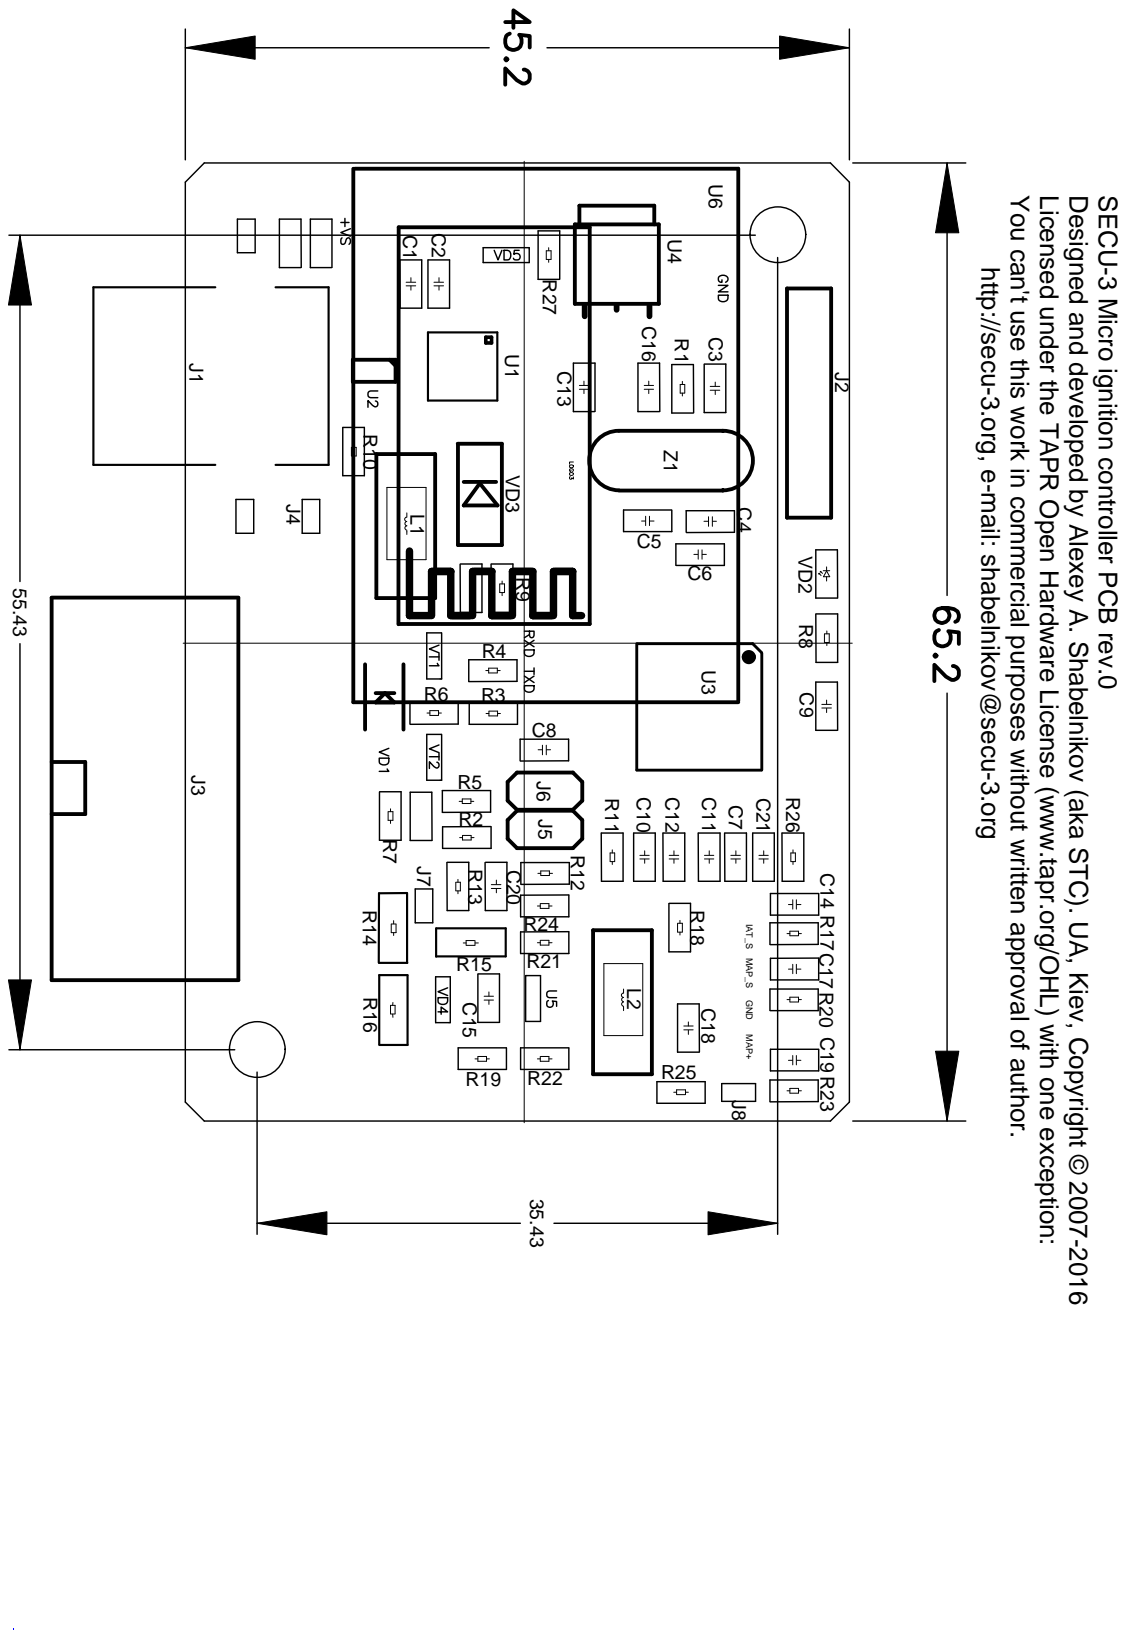
[picture p167: page 1]

Licensed under the TAPR Open Hardware License (www.tapr.org/OHL) with one exception:

Designed and developed by Alexey A. Shabelnikov (aka STC). UA, Kiev, Copyright

SECU-3 Micro ignition controller PCB rev.0

http://secu-3.org, e-mail: shabelnikov@secu-3.org

't use this work in commercial purposes without written approval of author.
