ashabelnikov/secu3doc/PDF/SECU-3M/secu-3-micro-sch.pdf

4

3

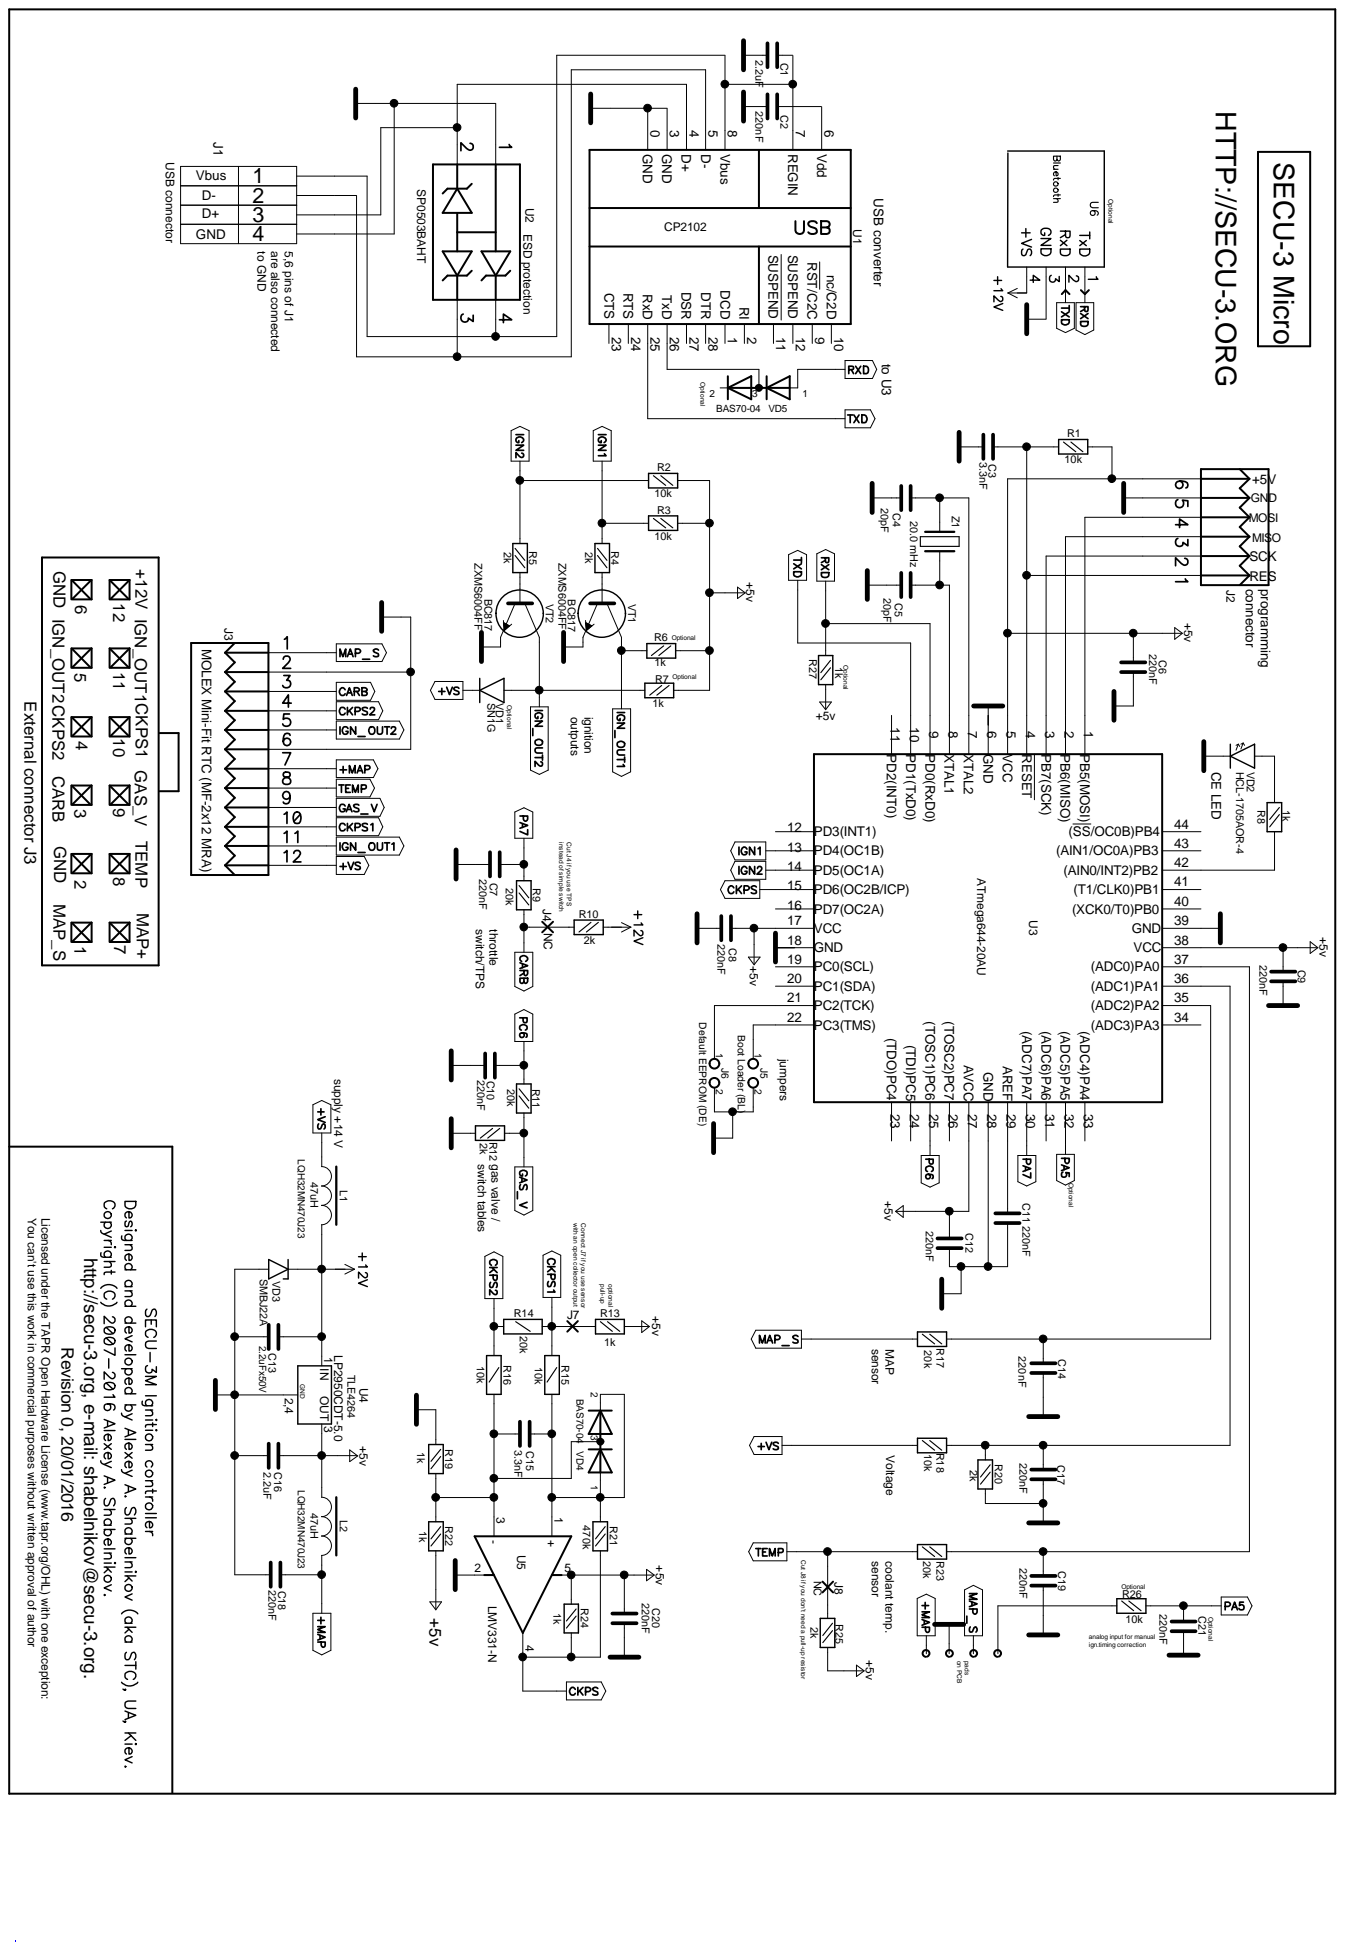
[picture p168: page 1]

D+J1 Vbus | 1

MOLEX Mini-Fit RTC (MF-2x12 MRA)

instead of simple switch

Cut J4 if you use TPS

You can't use this work in commercial purposes without written approval of author

Licensed under the TAPR Open Hardware License (www.tapr.org/OHL) with one exception:

with an open collector output

Connect J7 if you use sensor

http://secu-3.org, e-mail: shabelnikov@secu-3.org.

Cut J8 if you don't need a pull-up resistor

analog input for manual
ign.timing correction
