ashabelnikov/secu3doc/PDF/SECU-3T/secu3t_schema_rs.pdf

# TLP181 U4

J7J4

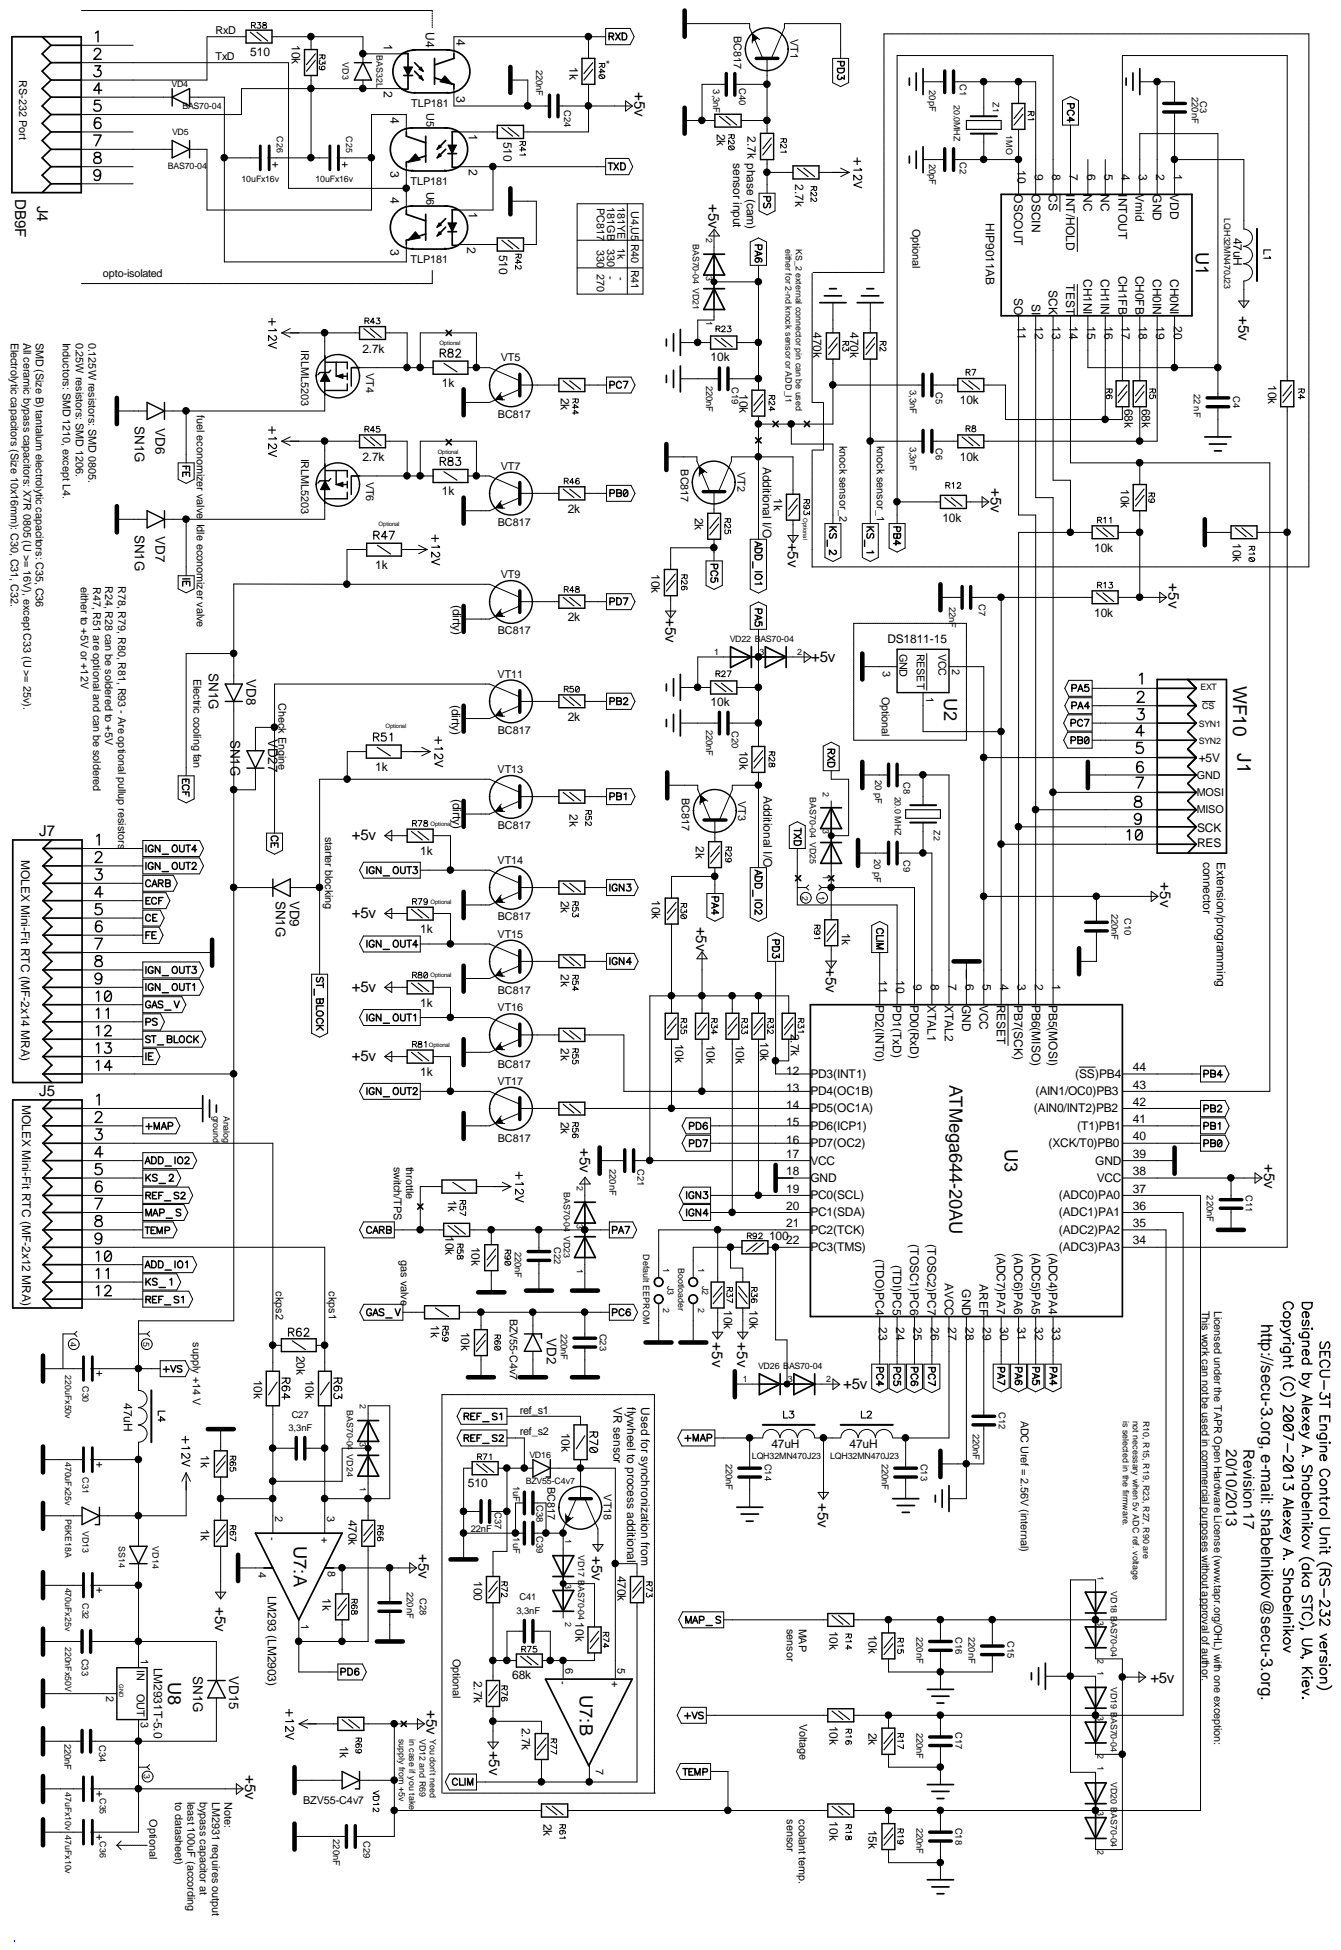
[picture p169: page 1]

either for 2-nd knock sensor or ADD_I1

KS_2 external connector pin can be used

All ceramic bypass capacitors: X7R 0805 (U >= 16V), except C33 (U >= 25v).

SMD (Size B) tantalum electrolytic capacitors: C35, C36

R47, R51 are optional and can be soldered

R24, R28 can be soldered to +5V

R78, R79, R80, R81, R93 - Are optional pullup resistors

MOLEX Mini-Fit RTC (MF-2x14 MRA)

MOLEX Mini-Fit RTC (MF-2x12 MRA)

36 (ADC1)PA1

100 | 34 (ADC3)PA3

This work can not be used in commercial purposes without approval of author.

Licensed under the TAPR Open Hardware License (www.tapr.org/OHL) with one exception:

flywheel to process additional

Used for synchronization from

is selected in the firmware.

not necessary when 5v ADC ref. voltage

mail: shabelnikov@secu-3.org.

in case if you take
