ashabelnikov/secu3doc/PDF/SECU-IGNITERS/secu3_igniters.pdf

+5v

+5v

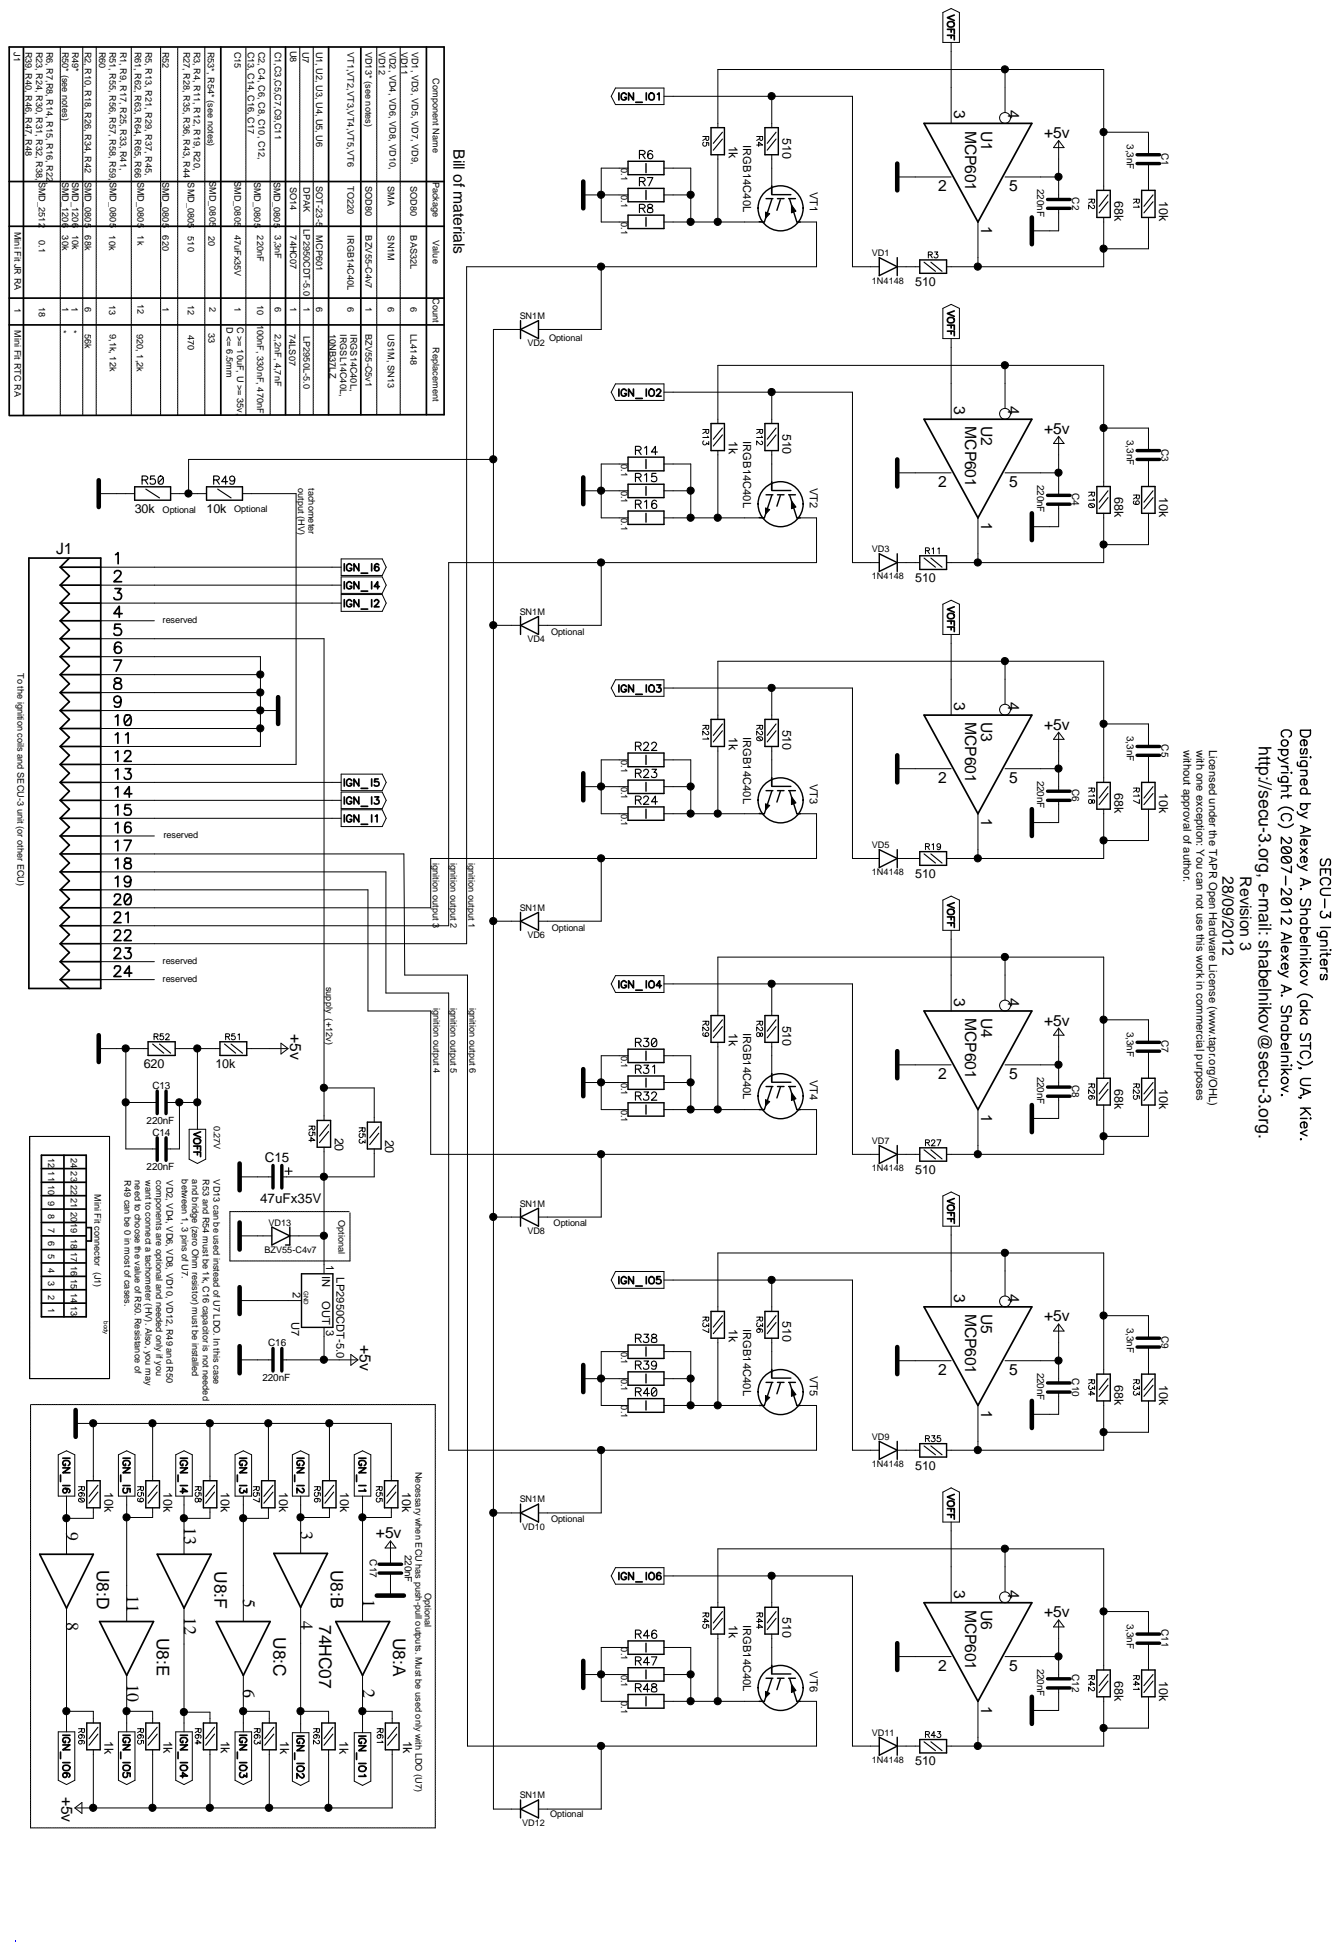
[picture p170: page 1]

Mini Fit JR RA Mini Fit RTC RA

To the ignition coils and SECU-3 unit (or other ECU)

without approval of author.

with one exception: You can not use this work in commercial purposes

Licensed under the TAPR Open Hardware License (www.tapr.org/OHL)

http://secu-3.org, e-mail: shabelnikov@secu-3.org.

R49 can be 0 in most of cases.

need to choose the value of R50. Resistance of

want to connect a tachometer (HV). Also, you may

components are optional and needed only if you

and bridge (zero Ohm resistor) must be installed

R53 and R54 must be 1k, C16 capacitor is not needed

VD13 can be used instead of U7 LDO. In this case

Necessary when ECU has push-pull outputs. Must be used only with LDO (U7)
