ashabelnikov/secu3doc/PDF/SECU-IGNITERS/secu3_igniters_pcb_topsilk.pdf

### R2 R13 R61

## R15 VD3

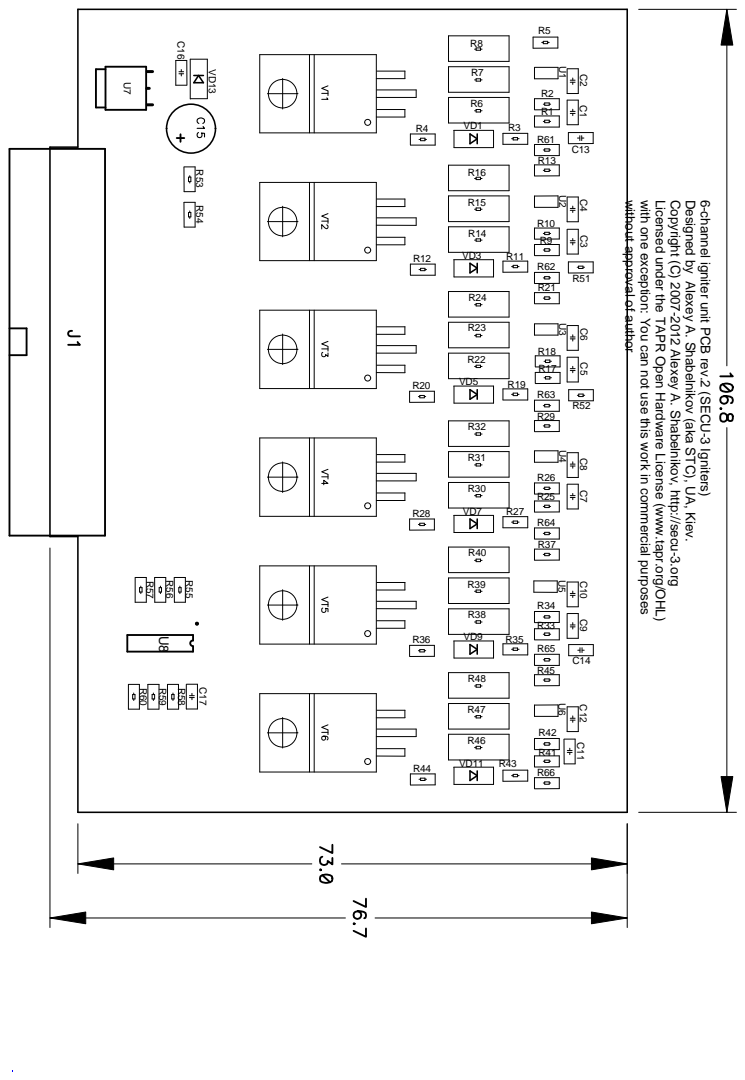
[picture p171: page 1]

without approval of author

with one exception: You can not use this work in commercial purposes

Licensed under the TAPR Open Hardware License (www.tapr.org/OHL)

Copyright (C) 2007-2012 Alexey A. Shabelnikov, http://secu-3.org

Designed by Alexey A. Shabelnikov (aka STC), UA, Kiev.

6-channel igniter unit PCB rev.2 (SECU-3 Igniters)
