ashabelnikov/secu3doc/PDF/SECU-INJ-DRV4/secu3_hi-z_inj_drv.pdf

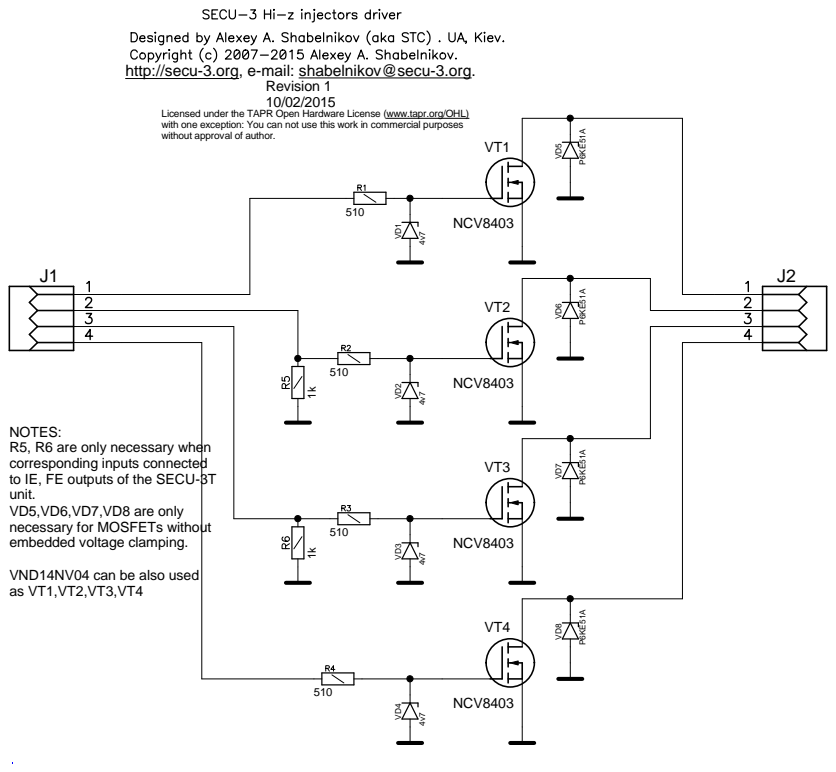
[picture p172: page 1]
Revision 1; NCV8403

http://secu-3.org, e-mail: shabelnikov@secu-3.org.

Licensed under the TAPR Open Hardware License (www.tapr.org/OHL)
with one exception: You can not use this work in commercial purposes
without approval of author.

NOTES:
R5, R6 are only necessary when
corresponding inputs connected
to IE, FE outputs of the SECU-3T
unit.
VD5,VD6,VD7,VD8 are only
necessary for MOSFETs without
embedded voltage clamping.

VND14NV04 can be also used
