ashabelnikov/secu3doc/PDF/SECU-P&H+PWMIAC/secu3_pnh+pwm_iac.pdf

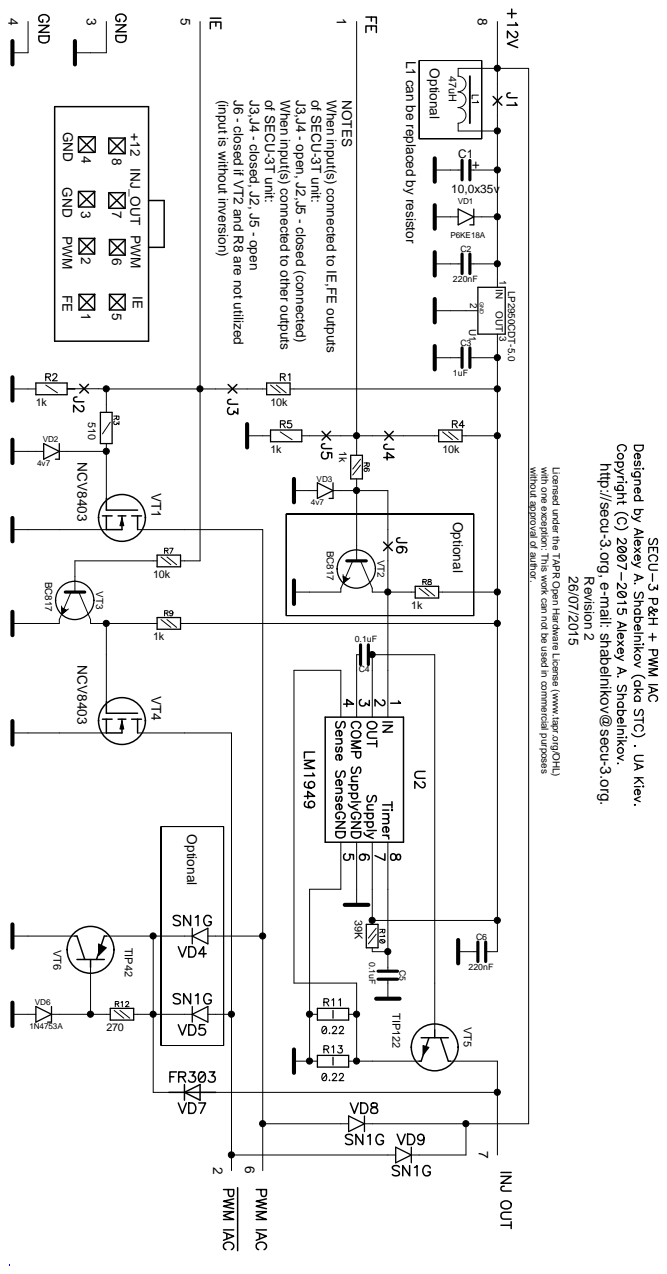
[picture p173: page 1]

L1 can be replaced by resistor

(input is without inversion)

J6 - closed if VT2 and R8 are not utilized

When input(s) connected to other outputs

When input(s) connected to IE,FE outputs

without approval of author.

with one exception: This work can not be used in commercial purposes

Licensed under the TAPR Open Hardware License (www.tapr.org/OHL)
