ashabelnikov/secu3doc/PDF/SECU-P&H-INJ-DRV4/secu3-pnh-inj-drv4-pcb-botsilk.pdf

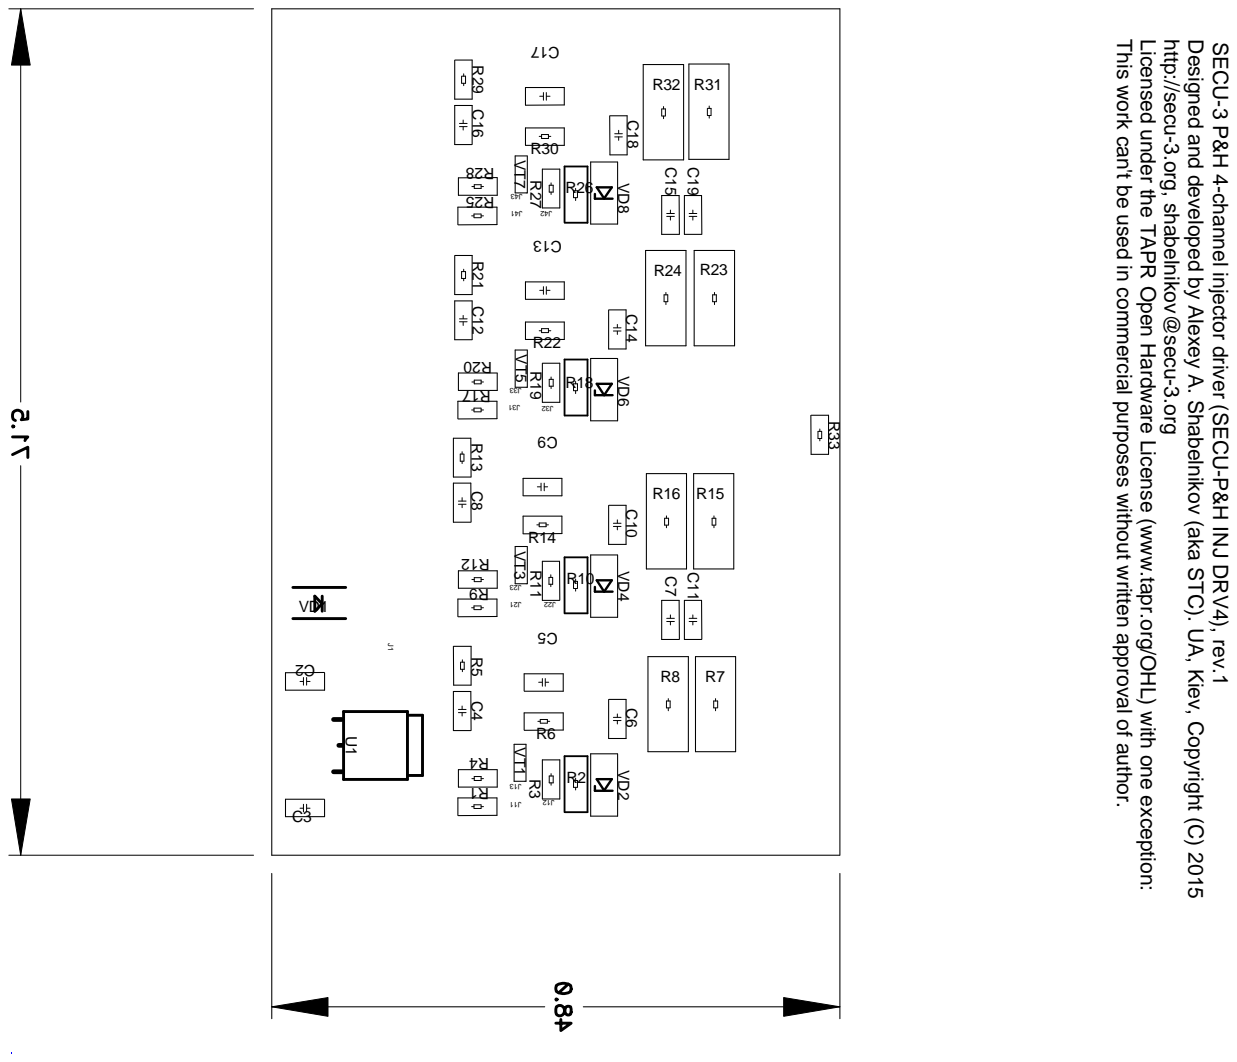
[picture p174: page 1]

This work can't be used in commercial purposes without written approval of author.

Licensed under the TAPR Open Hardware License (www.tapr.org/OHL) with one exception:

http://secu-3.org, shabelnikov@secu-3.org

Designed and developed by Alexey A. Shabelnikov (aka STC). UA, Kiev, Copyright (C) 2015

SECU-3 P&H 4-channel injector driver (SECU-P&H INJ DRV4), rev.1
