ashabelnikov/secu3doc/PDF/SECU-P&H-INJ-DRV4/secu3-pnh-inj-drv4-schema.pdf

# x35v 2GND

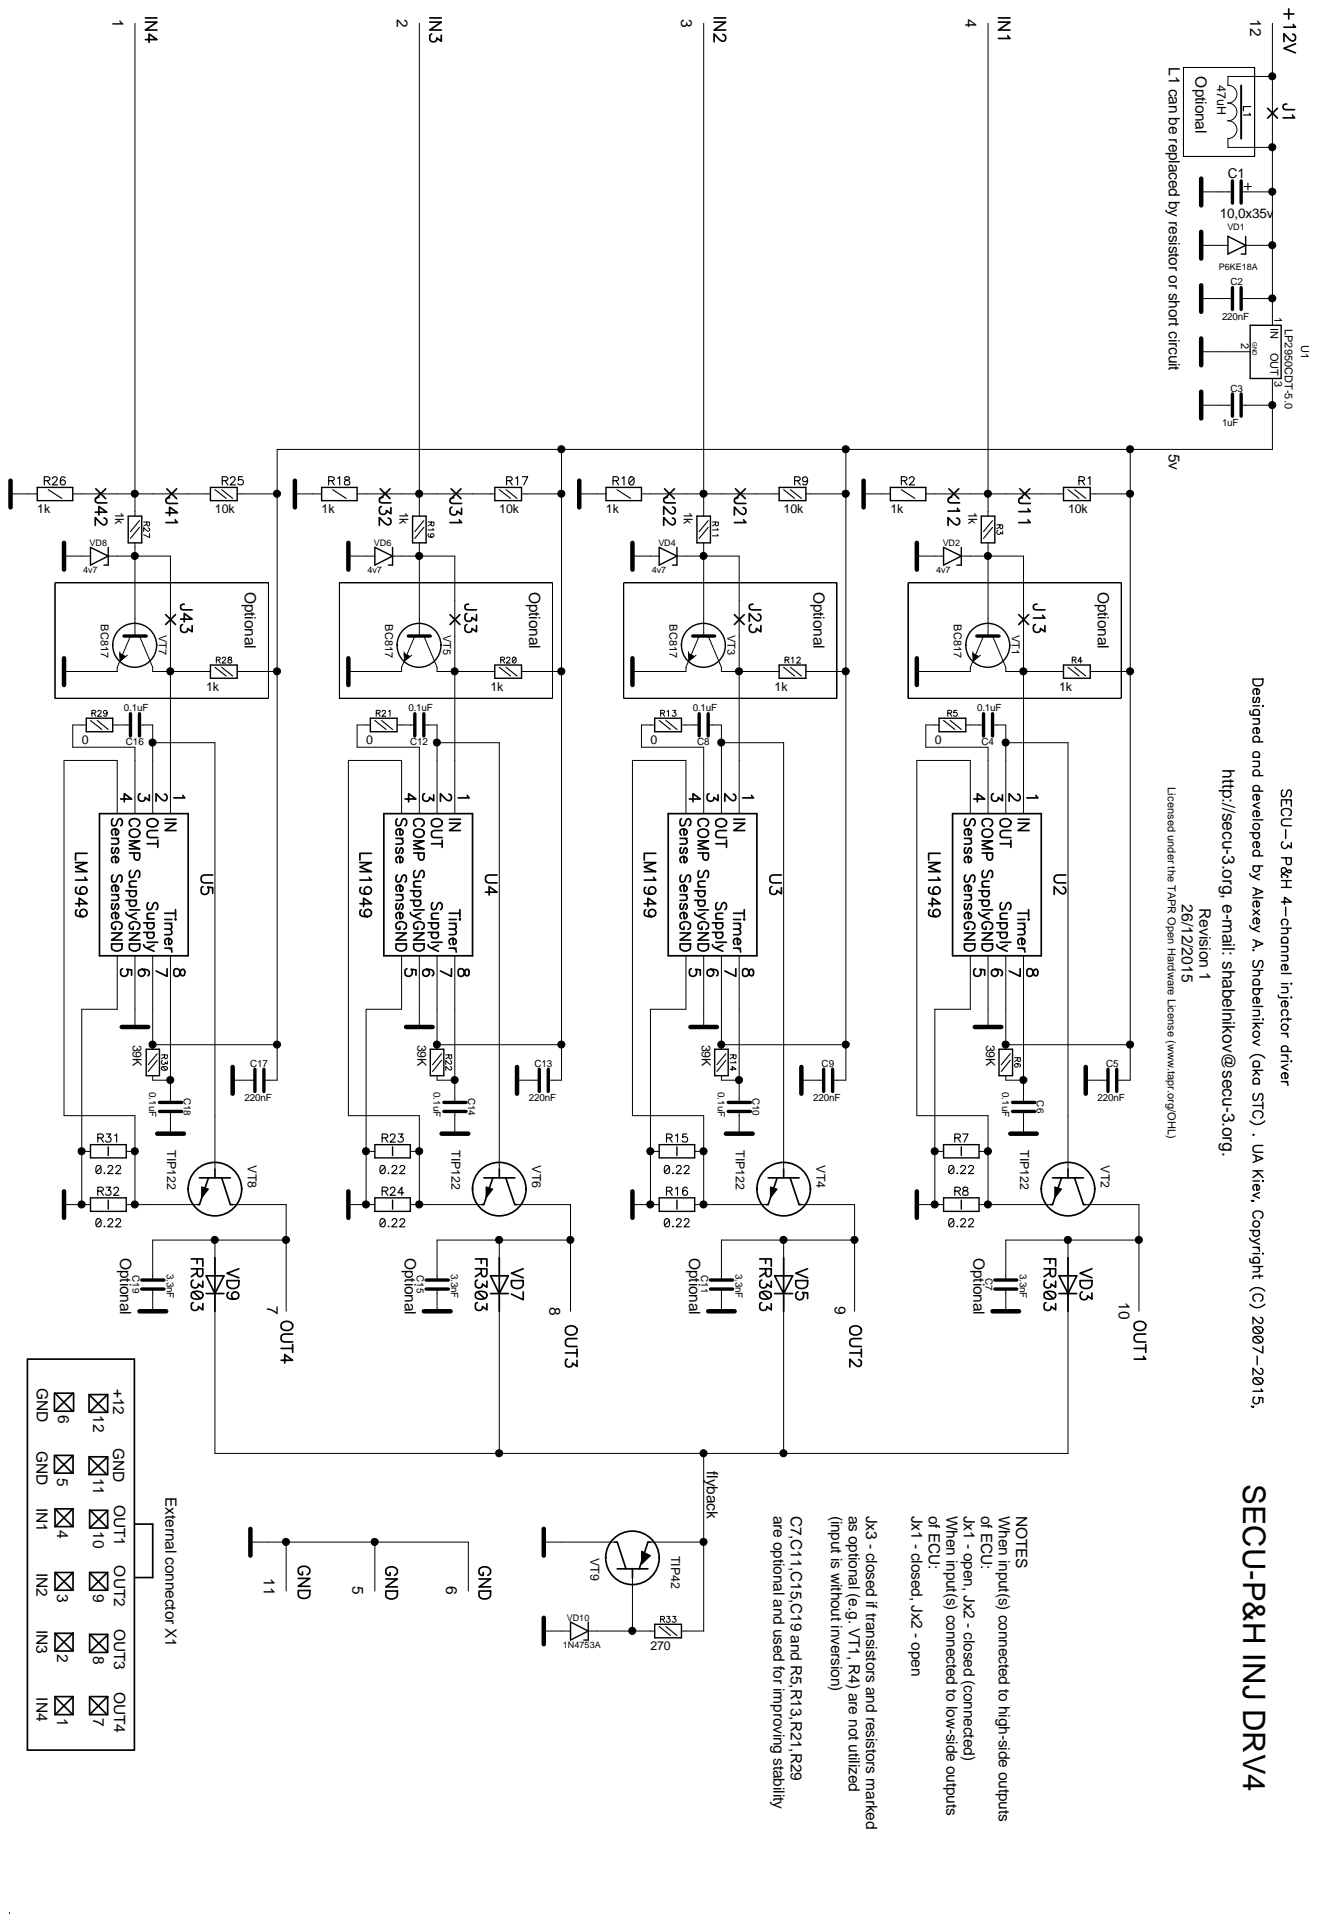
[picture p175: page 1]

Licensed under the TAPR Open Hardware License (www.tapr.org/OHL) L1 can be replaced by resistor or short circuit

http://secu-3.org, e-mail: shabelnikov@secu-3.org.

are optional and used for improving stability

(input is without inversion)

as optional (e.g. VT1, R4) are not utilized

Jx3 - closed if transistors and resistors marked

When input(s) connected to low-side outputs

When input(s) connected to high-side outputs
