ashabelnikov/secu3doc/PDF/SECU-2P&H+STEP/secu-2pnh+step-sch.pdf

## N42GK

-14 J1

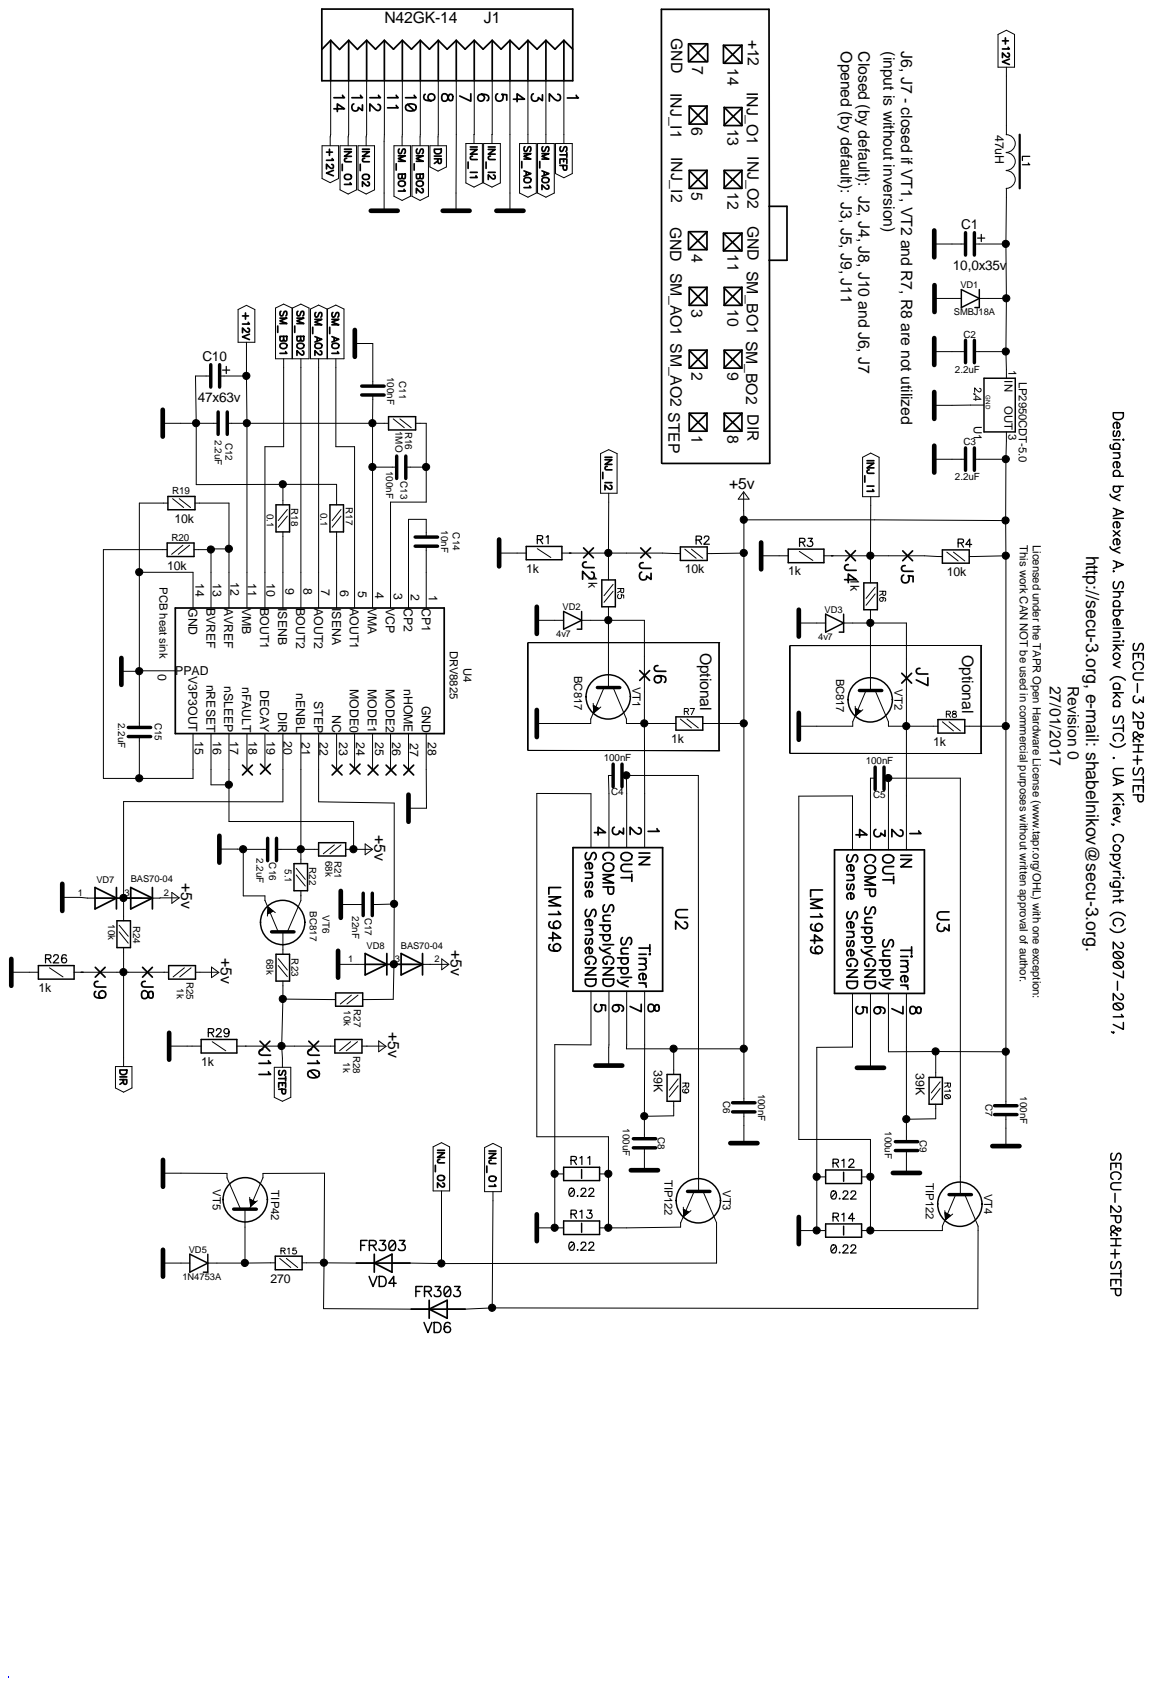
[picture p176: page 1]

Closed (by default): J2, J4, J8, J10 and J6, J7

VT2 J6, J7 - closed if VT1, VT2 and R7, R8 are not utilized (input is without inversion)

This work CAN NOT be used in commercial purposes without written approval of author.

Licensed under the TAPR Open Hardware License (www.tapr.org/OHL) with one exception:

http://secu-3.org, e-mail: shabelnikov@secu-3.org.
