ashabelnikov/secu3doc/PDF/SECU-3T/secu3t_pcb_botsilk.pdf

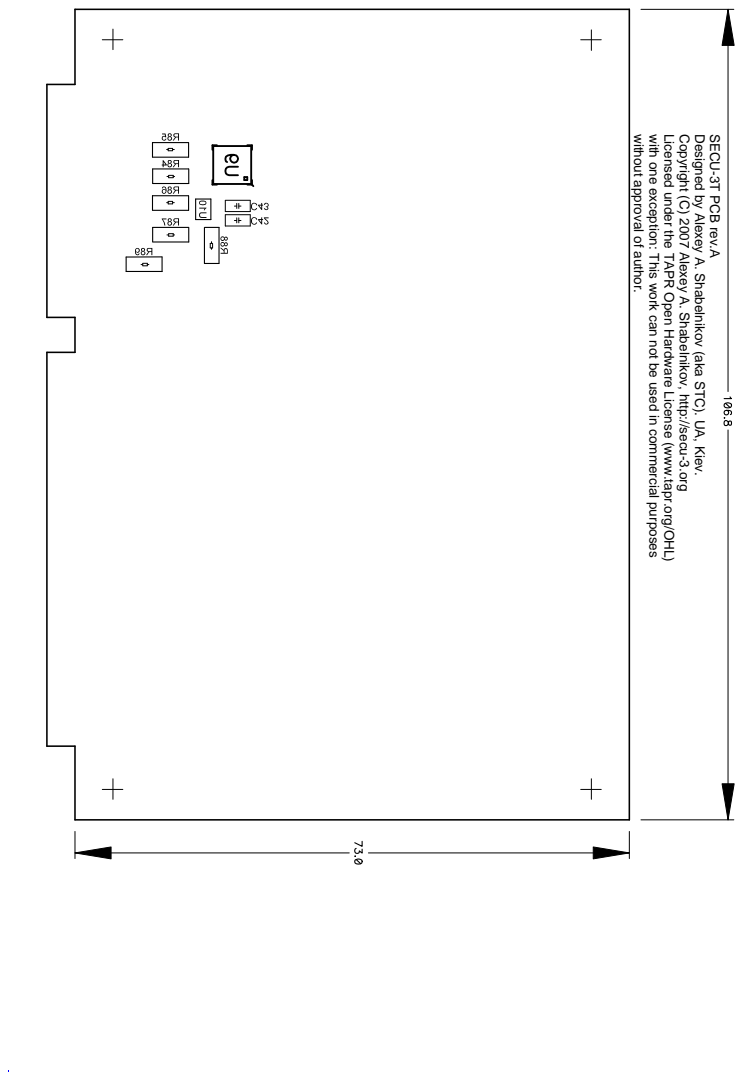
[picture p177: page 1]
SECU-3; T P C B rev.A; D esigned; Ale; x ey A. Shabelnik; ov (aka; A, Kiev.; Cop; yright (C) 2007; ov, htt; e cu-3.org; TAPR Open H; ard; w are; with one; exception: This w; omm; erci al purposes; without appro

Licensed under the

al of author.

ork can not be used in c

License (www.tapr.org/OHL)
