ashabelnikov/secu3doc/PDF/SECU-3T/secu3t_pcb_bottom_u6.pdf

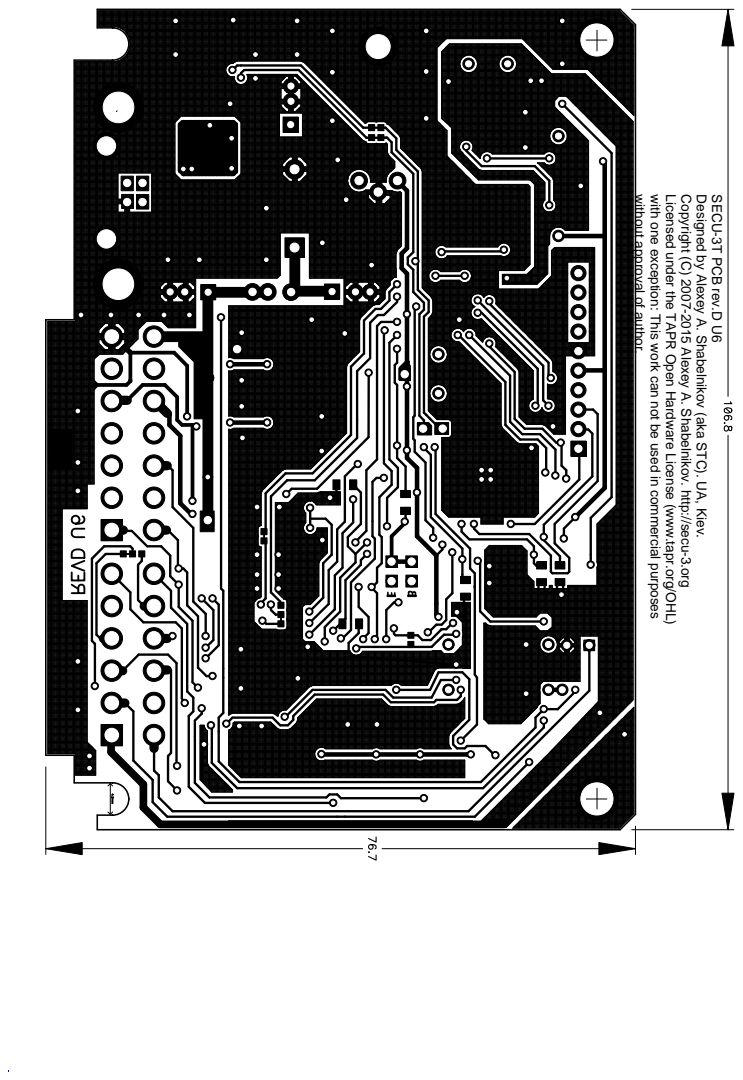
[picture p178: page 1]
SECU-3; T P C B rev.D U6; Designed by; Alexey; A, Kiev.; Copyright (C) 2007-2015; A. Shabelnikov. htt; p://secu-3.org; R Open; H ard; without approval; of author.

with one exception: This

Licensed under the TAP

A. Shabelnikov (aka ST

ork can not be used in commercial purposes

are License (www.tapr.org/OHL)
