ashabelnikov/secu3doc/PDF/SECU-IGNITERS/secu3_igniters_pcb_botsilk.pdf

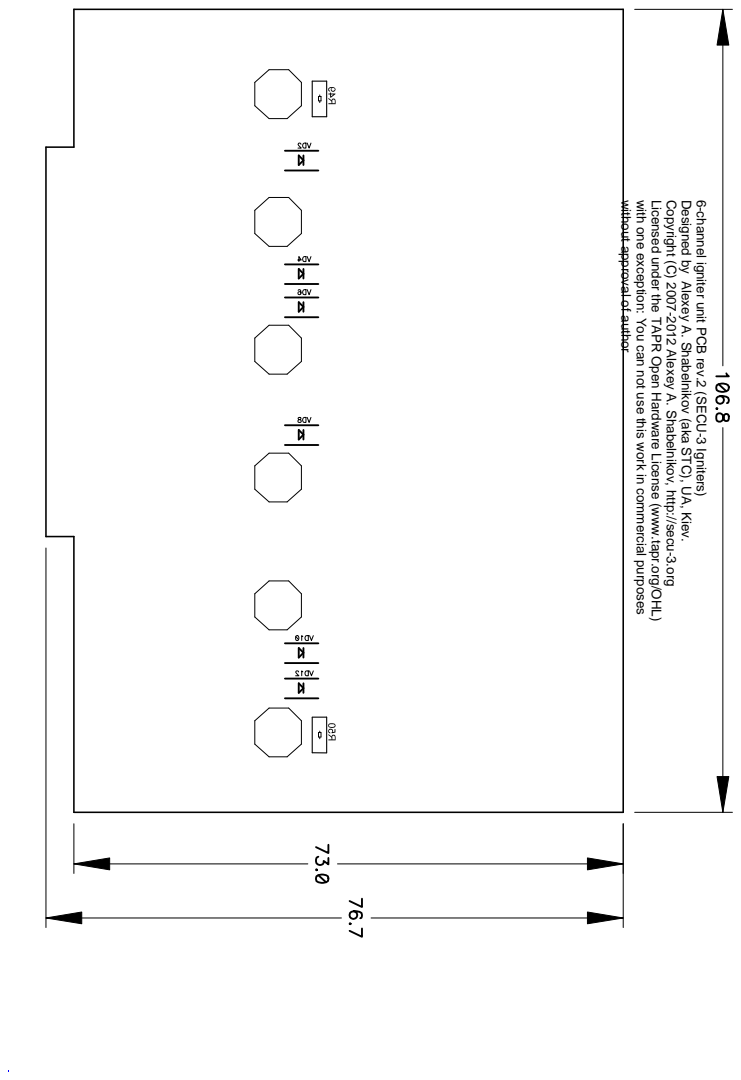
[picture p179: page 1]
CB rev.; 2 (SECU-3 Igniters); Designed; Ale; Cop; yright (C) 2007-2012 Ale; e cu-3.org; TAP; R Open Hardware; with one; ommer; cial purposes; without appro

Licensed under the

channel igniter unit P

exception: You can not use this work in c

al of author

ey A. Shabelnikov (aka S

ey A. Shabelnikov, htt

License (www.tapr.org/OHL)

TC), UA, Kiev.
