ashabelnikov/secu3doc/(list of files, drawings)

Other design files:
PCB/fanpwm_pcb_rev1.pcb
PCB/fanpwm_pcb_rev2.pcb
PCB/secu3_hi-z_inj_drv.pcb
PCB/secu3_igniters_rev2.pcb
PCB/secu3_pcb.pcb
PCB/secu3_smcu_rev1.pcb
PCB/secu3_smcu_rev2.pcb
PCB/secu3_smcu_rev3.pcb
PCB/secu3t_bluetooth.pcb
PCB/secu3t_bluetooth_rev2.pcb
PCB/secu3t_rev6.pcb
PCB/secu3t_rev9.pcb
PCB/secu3t_revA.pcb
PCB/secu3t_revBU4.pcb
PCB/secu3t_revCU6.pcb
PCB/secu3t_revDU6.pcb
PCB/secu3t_revDU6A.pcb
