ashabelnikov/secu3doc/(commit log)

2015-09-09 Add some SECU-3 hardware documetation files
    [fanpwm_pcb_rev1.pcb, fanpwm_pcb_rev2.pcb, secu3_hi-z_inj_drv.pcb, secu3_hi-z_inj_drv.sch, secu3_igniters.sch, secu3_igniters_rev2.pcb, secu3_pcb.pcb, secu3_pnh+pwm_iac.sch]
2015-10-27 Add SMCU REV3 PCB
    [secu3_smcu_rev3.pcb]
2015-11-03 Add png files of wiring
2015-11-04 Add some design files for wiring
2015-11-04 Add SECU-3T wiring diagram (simultaneous or semi-sequential injection, hi-z injectors, stepper IAC).
2015-11-04 Update wiring
2015-11-04 Add wiring for stepper IAC
2015-11-05 Add SECU-3T unit wiring for fuel injection, lo-z injector, PWM IAC
2015-11-06 Add schematic diagrams for connecting PWM IAC to the SECU-3T unit
2015-11-06 Add hi-z inj. wiring for SECU-3T unit with 24pin external connector
2015-11-13 Add wiring diagram for SECU-3L unit
2015-11-14 Add wiring for SECU-3L unit (synchronization from a Hall sensor, distributor)
2015-11-22 Fix error
    [secu3_pnh+pwm_iac.sch, secu3l_schema_usb.sch]
2016-01-29 Fix DRC errors
    [fanpwm_pcb_rev1.pcb, fanpwm_pcb_rev2.pcb, secu3_hi-z_inj_drv.pcb, secu3_igniters_rev2.pcb, secu3_pcb.pcb, secu3_smcu_rev1.pcb, secu3_smcu_rev2.pcb, secu3_smcu_rev3.pcb]
2016-02-01 Add dimensions
    [fanpwm_pcb_rev1.pcb, fanpwm_pcb_rev2.pcb, secu3_hi-z_inj_drv.pcb, secu3_igniters_rev2.pcb, secu3_pcb.pcb, secu3_smcu_rev1.pcb, secu3_smcu_rev2.pcb, secu3_smcu_rev3.pcb]
2016-07-19 Update secu-3 lite revision
    [secu3l_schema_usb.sch]
2016-10-15 Add some new wiring diagrams
2016-11-12 fix drill errors
    [fanpwm_pcb_rev1.pcb, fanpwm_pcb_rev2.pcb, secu3_hi-z_inj_drv.pcb, secu3_igniters_rev2.pcb, secu3_pcb.pcb, secu3_smcu_rev1.pcb, secu3_smcu_rev2.pcb, secu3_smcu_rev3.pcb]
2016-11-12 Improve readability of schematics
    [secu3_hi-z_inj_drv.sch, secu3_igniters.sch, secu3_pnh+pwm_iac.sch, secu3_schema.sch, secu3_smcu_schema.sch, secu3t_schema_rs.sch, secu3t_schema_usb.sch]
2016-12-13 Add additional wiring diagrams
2016-12-24 Fix grammar errors and add new file
    [secu3l_schema_usb.sch, secu3t_revA.pcb, secu3t_revBU4.pcb]
2016-12-28 Add BOM files
    [fanpwm_bill_of_materials.xls, secu-3-micro-bill-of-materials.xls, secu3-inj-drv4-bill-of-materials.xls, secu3-pnh+pwm-iac-bill-of-materials.xls, secu3-pnh-inj-drv4-bill-of-materials.xls, secu3_bill_of_materials.xls, secu3_bluetooth_bill_of_materials.xls, secu3_smcu_bill_of_materials.xls]
2016-12-31 Add inj. wiring for 8-cylinder engine
2017-01-10 Add P-n-H wiring for J5.1
2017-02-12 Add two wiring diagram examples for 6-cylinder engine
2017-07-04 Add BOM file for SECU-DRV8825
    [secu-drv8825-bill-of-materials.xls]
2017-07-04 Add BOM file for SECU-2PnH+STEP unit
    [secu-2pnh+step-bill-of-materials.xls]
